lambert/31/README.md

# 31 Power Supply Unit

[Documentation](docs/README.md).

[Electrical CAD files](ecad/README.md)

[Mechanical CAD files](mcad/README.md)

CC BY-SA
