lambert/31/ecad/pcb/README.md

Requires [pcb version 4.2.1](https://sourceforge.net/projects/pcb/files/pcb/pcb-4.2.1/) or later.
