lambert/31/ecad/pcb/eyecandy/README.md

# pcb eyecandy

## 31.001.00.01.01 Front panel

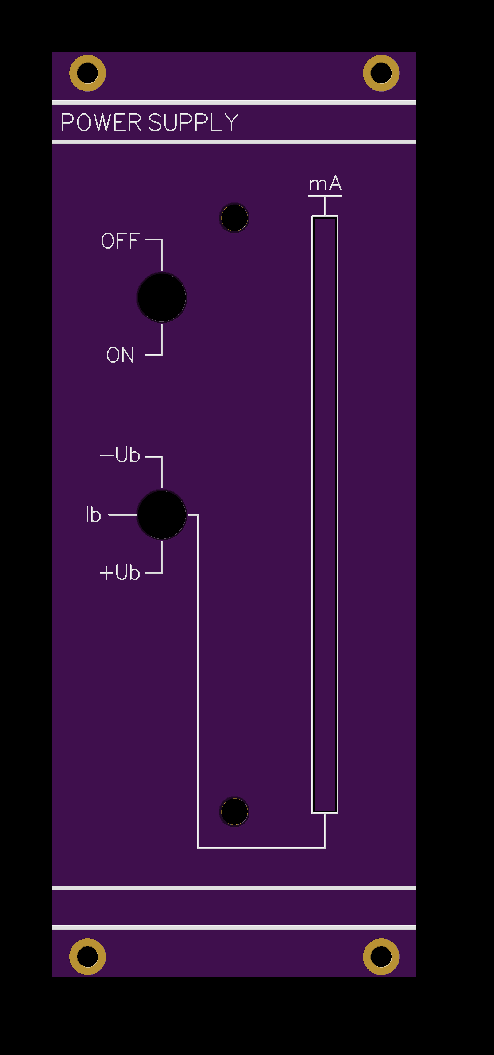
[picture p2: ecad/pcb/eyecandy/31.001.00.01.01.pcb.top.png]
top-001


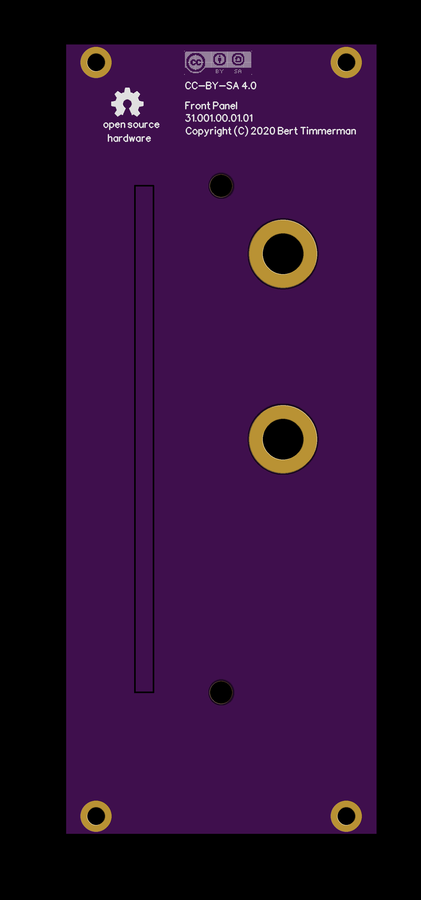
[picture p3: ecad/pcb/eyecandy/31.001.00.01.01.pcb.bottom.png]
bottom-001


## 31.002.00.01.01 Front pcb

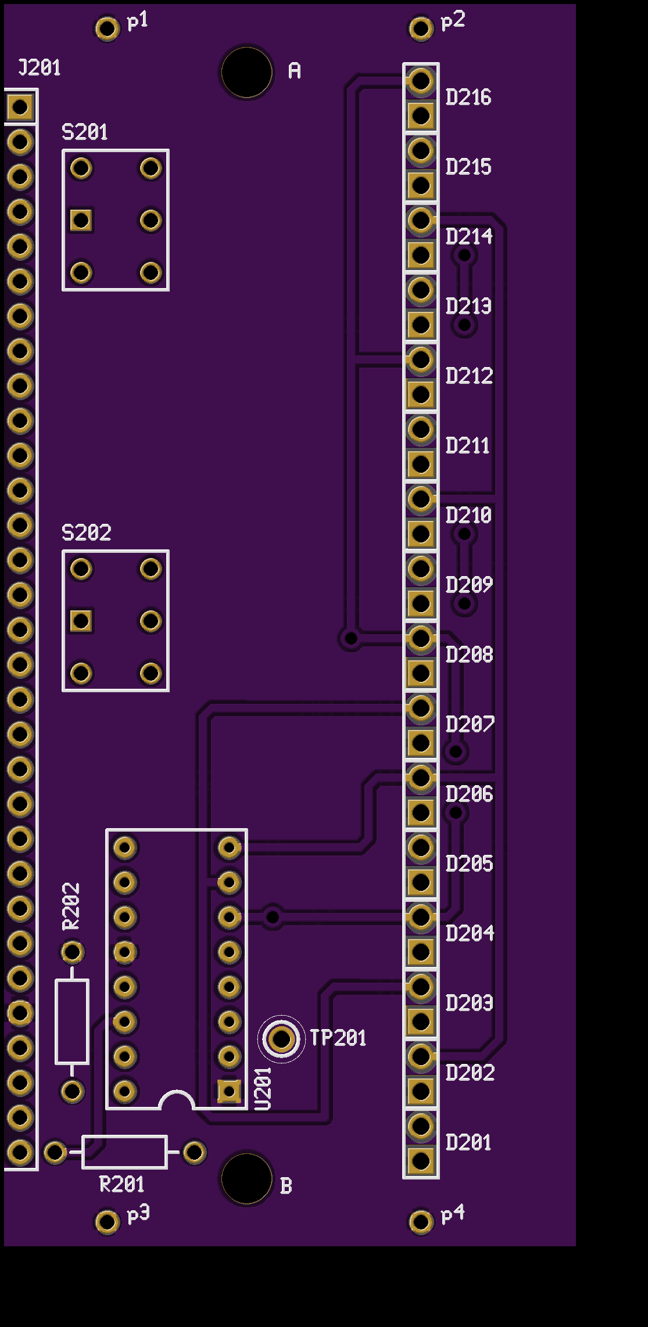
[picture p4: ecad/pcb/eyecandy/31.002.00.01.01.pcb.top.png]
top-002


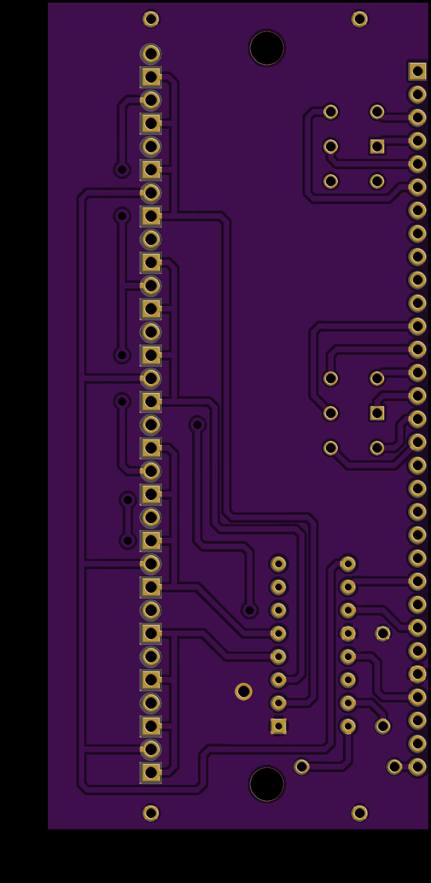
[picture p5: ecad/pcb/eyecandy/31.002.00.01.01.pcb.bottom.png]
bottom-002


## 31.003.00.01.01 Main pcb

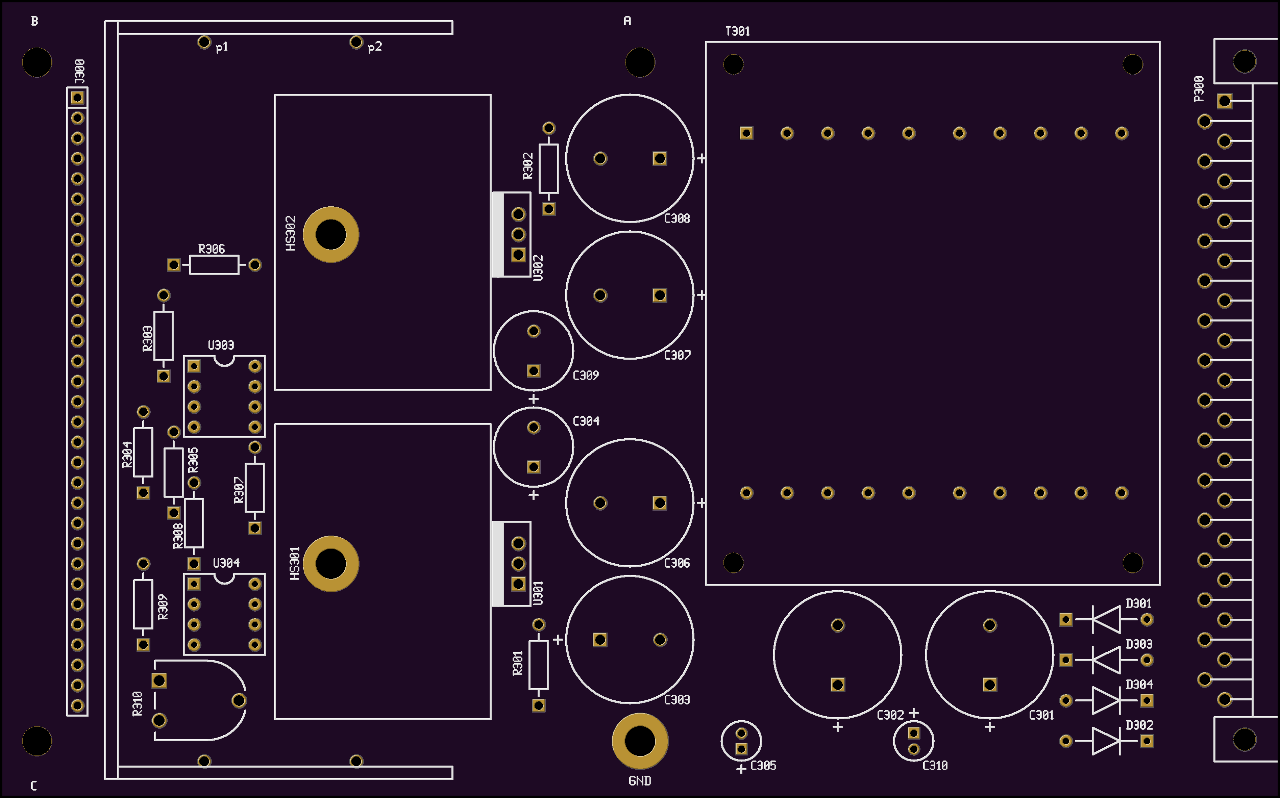
[picture p6: ecad/pcb/eyecandy/31.003.00.01.01.pcb.top.png]
top-003


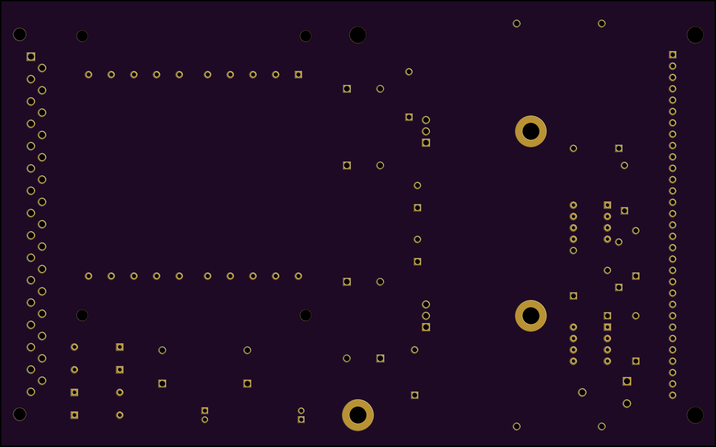
[picture p7: ecad/pcb/eyecandy/31.003.00.01.01.pcb.bottom.png]
bottom-003


## 31.004.00.01.01 Shielding pcb

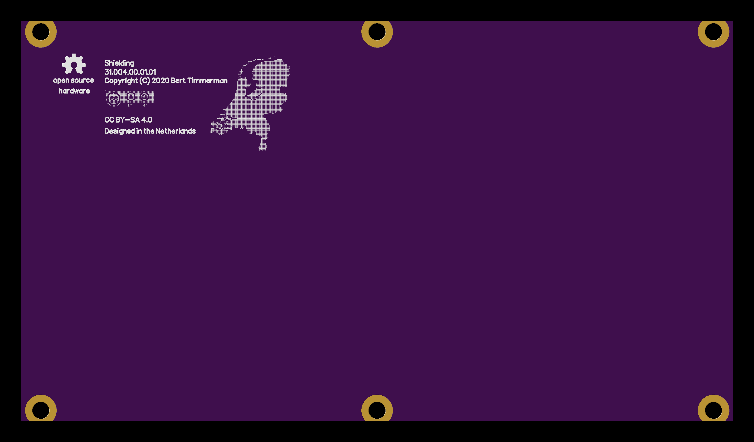
[picture p8: ecad/pcb/eyecandy/31.004.00.01.01.pcb.top.png]
top-004


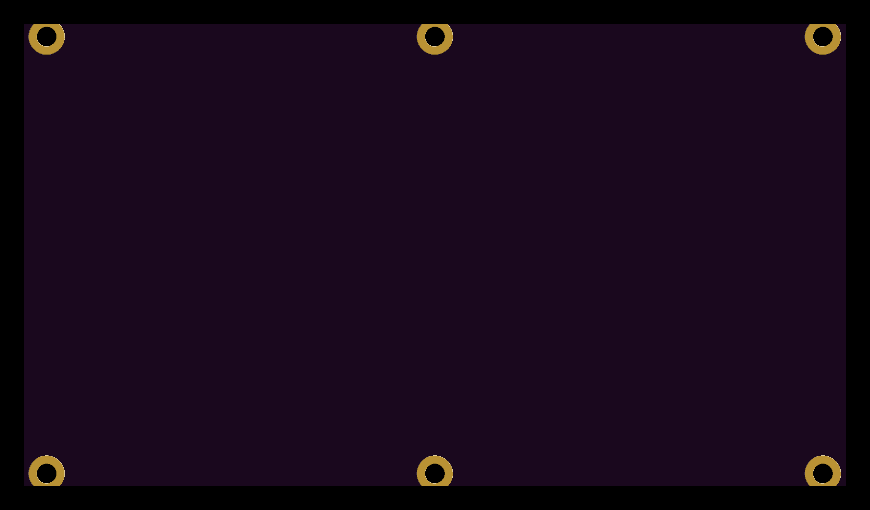
[picture p9: ecad/pcb/eyecandy/31.004.00.01.01.pcb.bottom.png]
bottom-004


## 31.005.00.01.01 Strut

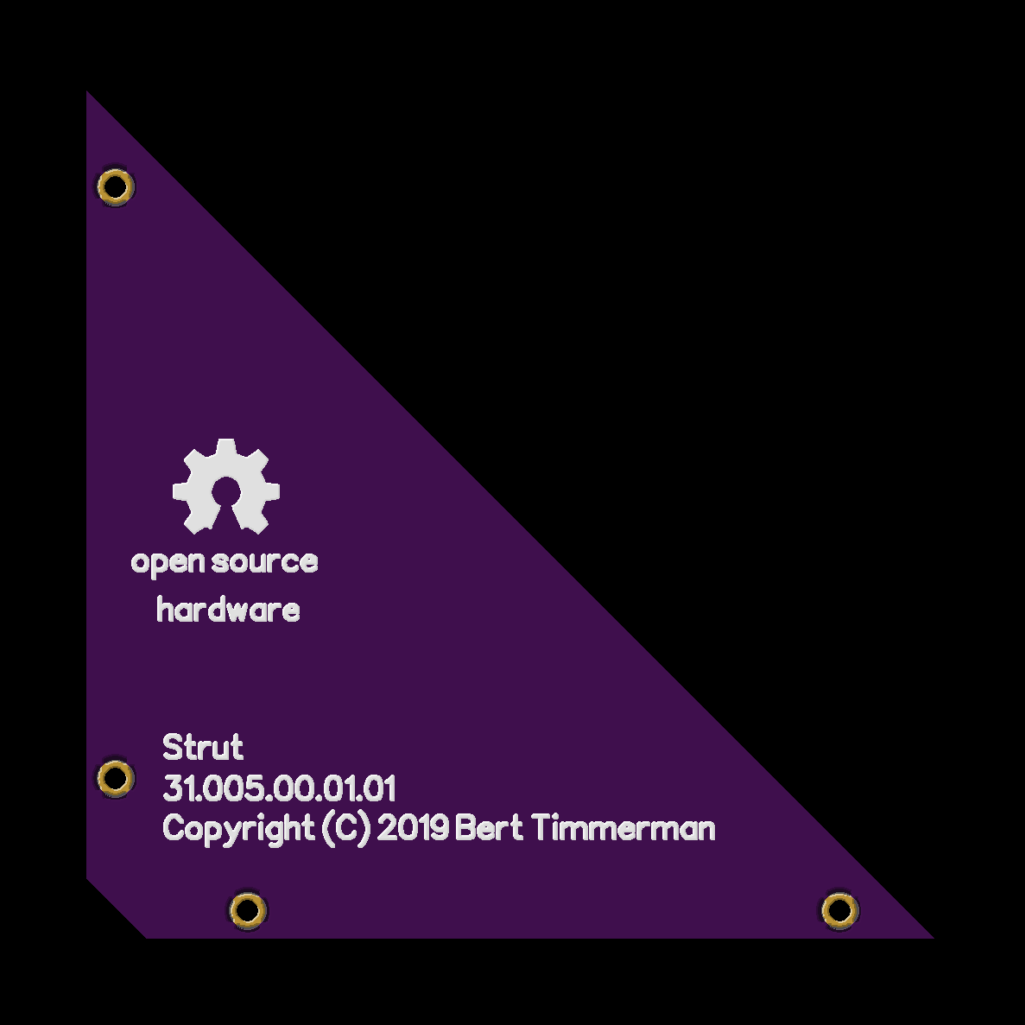
[picture p10: ecad/pcb/eyecandy/31.005.00.01.01.pcb.top.png]
top-005


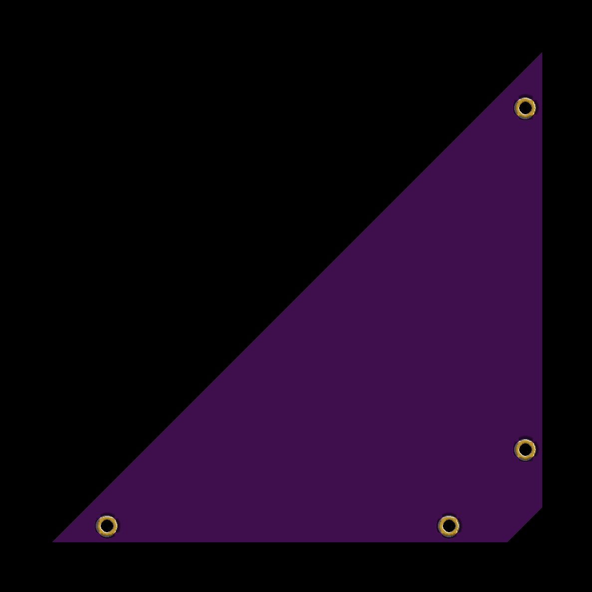
[picture p11: ecad/pcb/eyecandy/31.005.00.01.01.pcb.bottom.png]
bottom-005
