lambert/31/ecad/pcb/plotfiles/31.004.00.01.01.pcb.pdf

## 31.004.00.01.01.pcb

## 1. Table of Contents (This Page) Created on Sun Jan 3 12:16:32 2021 2. top 3. bottom 4. outline 5. plated-drill 6. componentmask 7. soldermask 8. topsilk 9. bottomsilk 10. topassembly 11. bottomassembly 12. fab

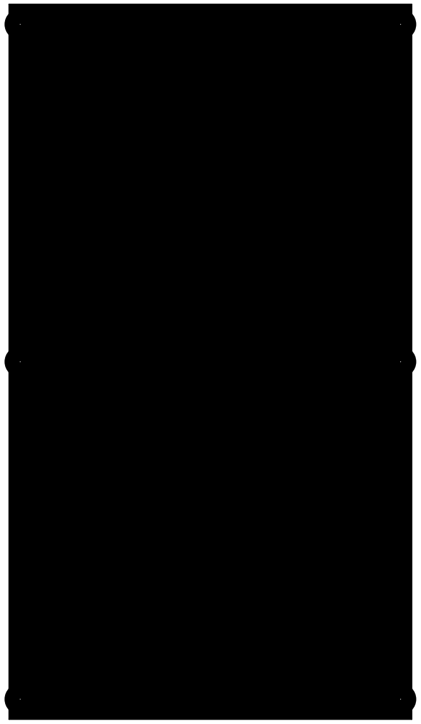
[picture p12: figure]

31.004.00.01.01.pcb, top, scale = 1:1.000

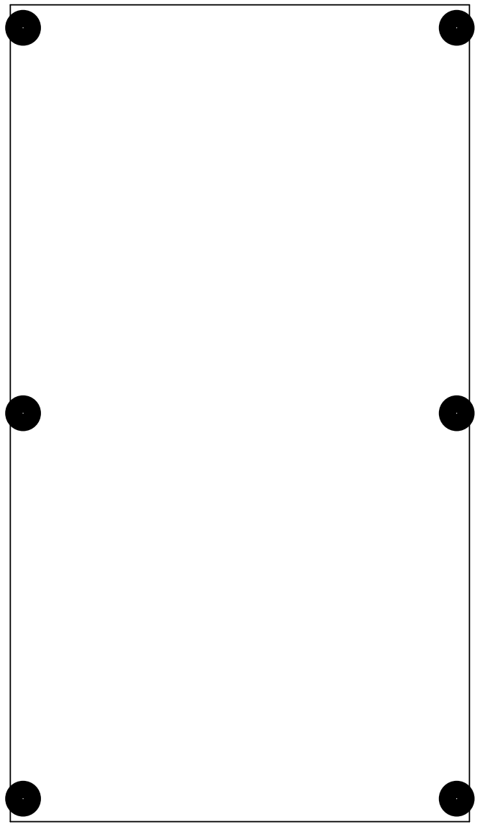
[picture p13: figure]

31.004.00.01.01.pcb, bottom (mirrored), scale = 1:1.000

31.004.00.01.01.pcb, outline, scale = 1:1.000

31.004.00.01.01.pcb, plated-drill, scale = 1:1.000

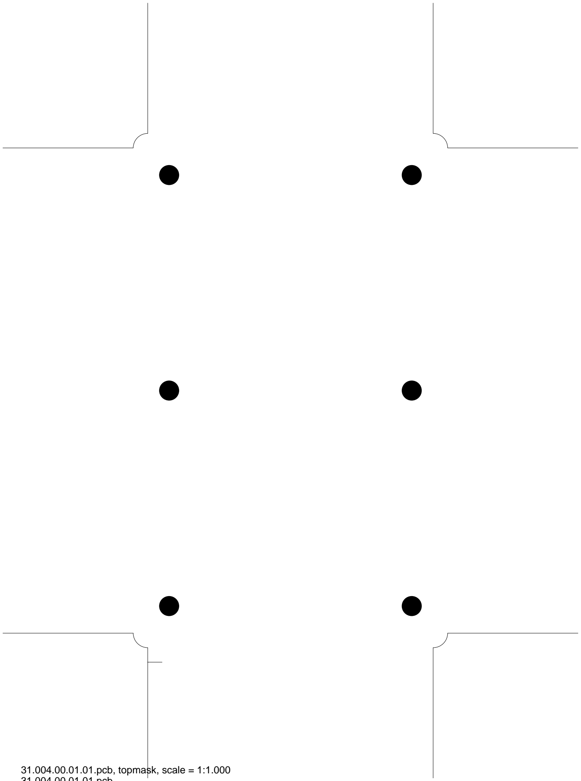
[picture p14: figure]
31.004.00.01.01.pcb, topmask, scale = 1:1.000

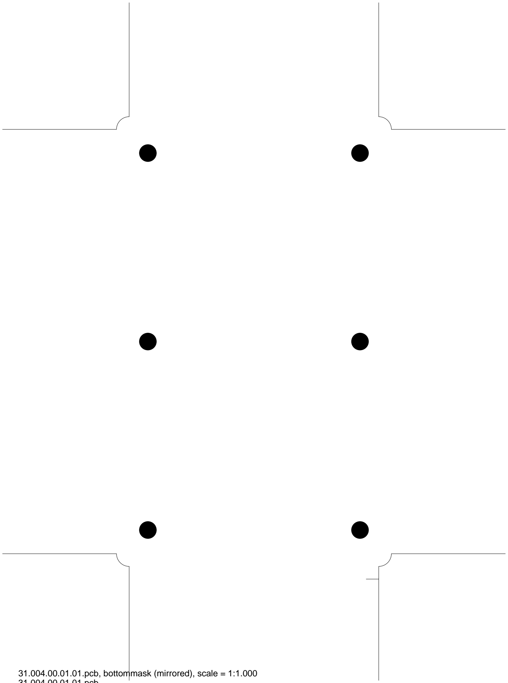
[picture p15: figure]

31.004.00.01.01.pcb, bottommask (mirrored), scale = 1:1.000

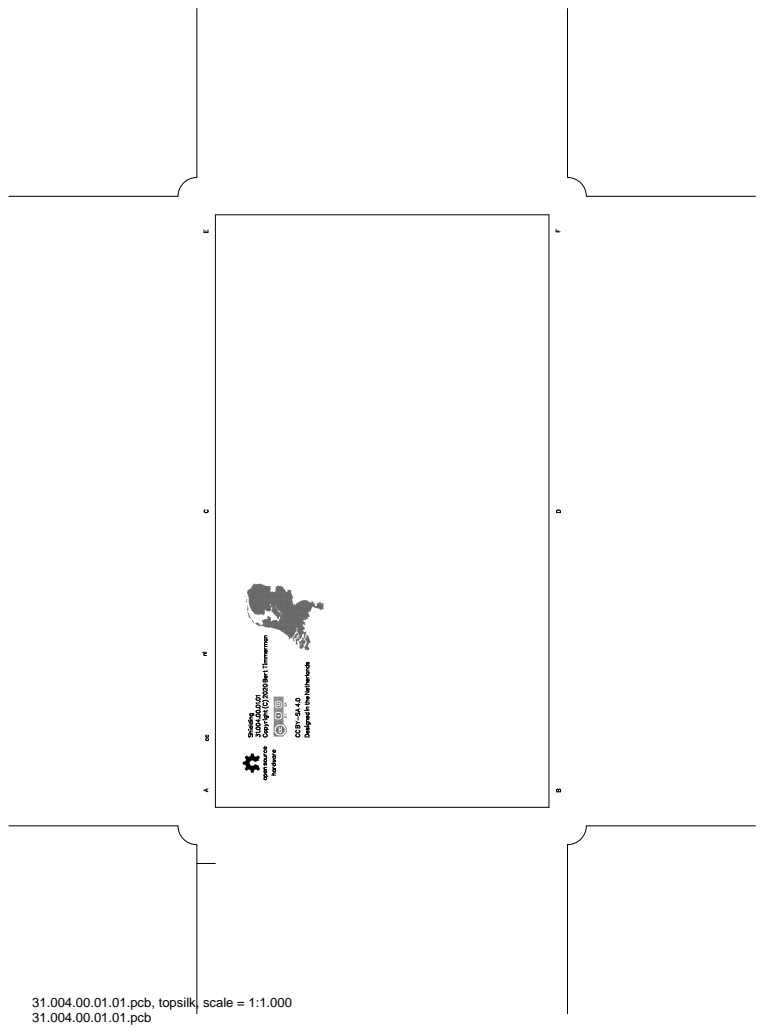
[picture p16: page 8]

31.004.00.01.01.pcb, topsilk, scale = 1:1.000

31.004.00.01.01.pcb, bottomsilk (mirrored), scale = 1:1.000

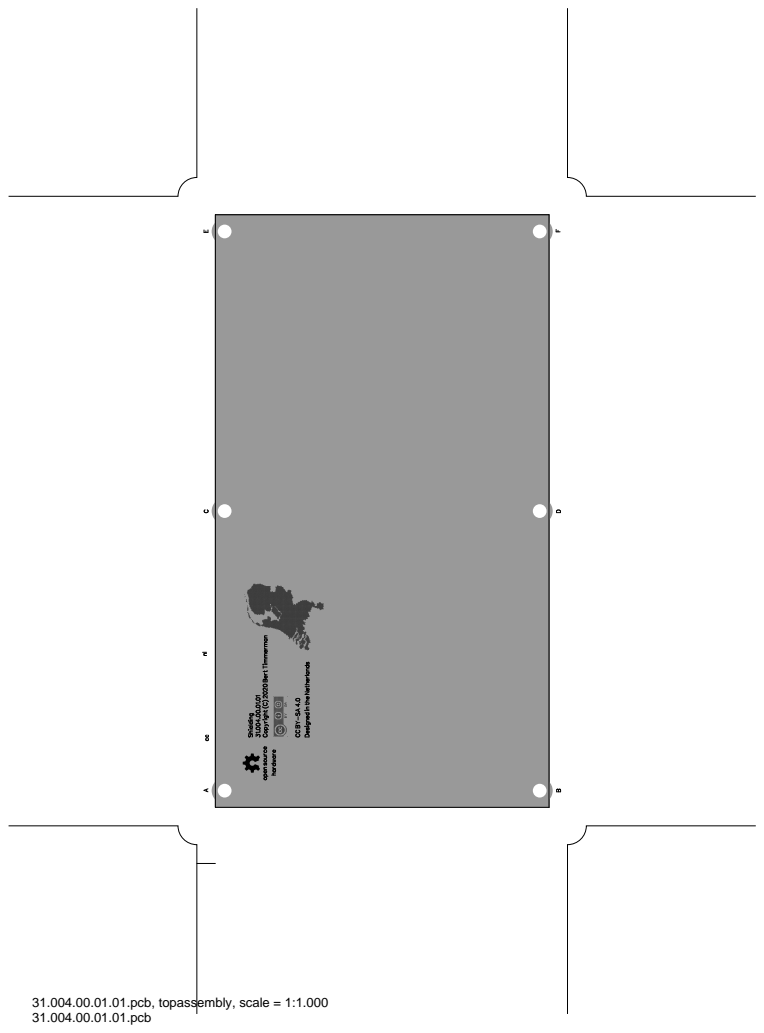
[picture p17: page 10]

31.004.00.01.01.pcb, topassembly, scale = 1:1.000

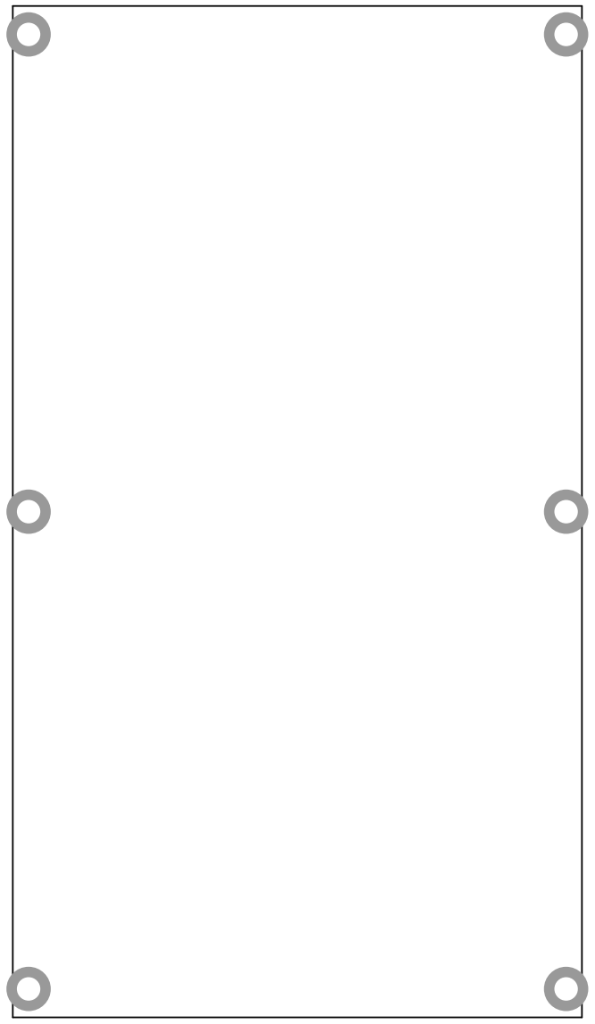
[picture p18: figure]

31.004.00.01.01.pcb, bottomassembly (mirrored), scale = 1:1.000

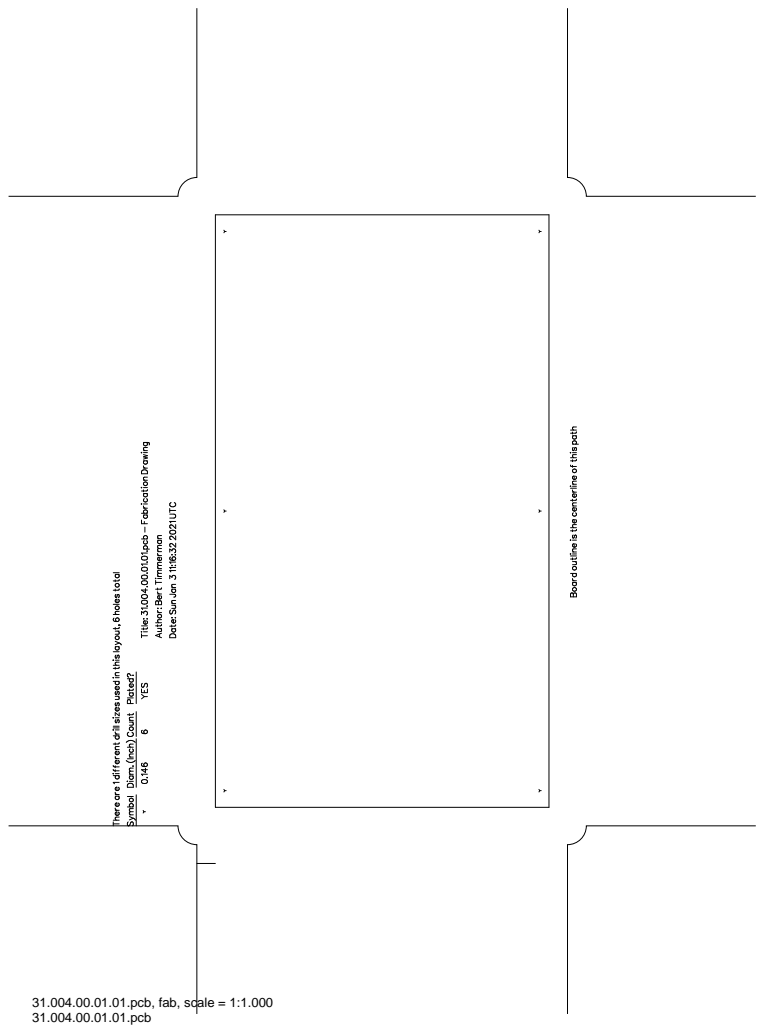
[picture p19: page 12]

31.004.00.01.01.pcb, fab, scale = 1:1.000
