lambert/31/docs/Era-UI39-13.5-18VA.jpg

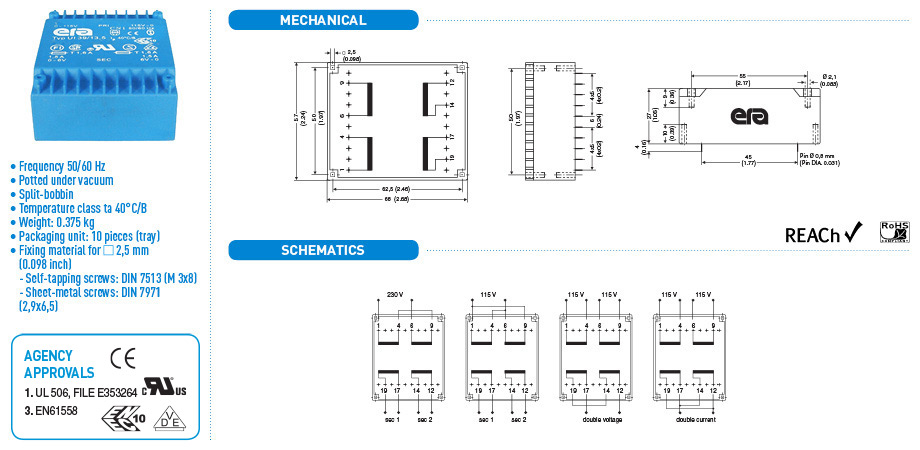
docs/Era-UI39-13.5-18VA.jpg
