lambert/31/mcad/parts/README.md

# Mechanical parts CAD files

All *.dwg files require Autodesk AutoCAD release 2015.
