lambert/31/docs/purchase/OSH_Park/README.md

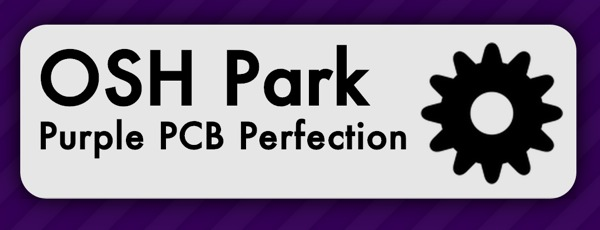
[picture p21: docs/purchase/OSH_Park/OSH_Park_logo.jpg]
OSH_Park_logo
.

----

[31.001.00 Front panel rev. 00](31-001-00/README.md)

[31.002.00 Front pcb rev. 00](31-002-00/README.md)

[31.003.00 Main pcb rev. 00](31-003-00/README.md)

[31.004.00 Shielding pcb rev. 00](31-004-00/README.md)

[31.005.00 Strut rev. 00](31-005-00/README.md)
