lambert/31/(list of files, cad)

Other CAD files:
mcad/parts/31_main_pcb_assembly_mechanical.dwg
mcad/parts/31_main_pcb_assembly.dwg
mcad/31.003.00.03.01_main_pcb_mechanical.dwg
mcad/parts/31_front_pcb_assembly.dwg
mcad/parts/31_assembly.dwg
mcad/parts/31_front_panel_assembly.dwg
mcad/31.001.00.01.01_front_panel_assembly.dwg
mcad/parts/31_main_pcb.dwg
mcad/31.003.00.02.01_main_pcb_fabrication_notes.dwg
mcad/31.003.00.02.02_main_pcb_drill_info.dwg
mcad/31.003.00.01.02_main_pcb_assembly_mechanical.dwg
mcad/31.000.00.01.06_assembly_left_view.dwg
mcad/31.000.00.01.07_assembly_right_view.dwg
mcad/31.002.00.01.01_front_pcb_assembly.dwg
mcad/31.003.00.01.01_main_pcb_assembly.dwg
mcad/31.000.00.01.02_assembly_top_view.dwg
mcad/31.000.00.01.00_assembly_SW_ISO_view.dwg
mcad/31.000.00.01.03_assembly_bottom_view.dwg
mcad/31.000.00.01.04_assembly_front_view.dwg
mcad/31.000.00.01.05_assembly_back_view.dwg
mcad/31.000.00.01.01_assembly_ISO_views.dwg
mcad/31.001.00.03.01_front_panel_mechanical.dwg
mcad/31.002.00.02.02_front_pcb_drill_info.dwg
mcad/31.004.00.03.01_shielding_pcb_mechanical.dwg
mcad/31.005.00.03.01_side_panel_mechanical.dwg
mcad/parts/31_front_panel_layout.dwg
mcad/31.006.00.03.01_heatsink_mechanical.dwg
mcad/parts/31_side_panel.dwg
mcad/31.002.00.02.01_front_pcb_fabrication_notes.dwg
mcad/parts/31_front_panel.dwg
mcad/parts/31_shielding_pcb.dwg
mcad/31.001.00.02.02_front_panel_fabrication_notes.dwg
mcad/parts/31_HSINK_Conrad_188751-02_88x35x37_modified.dwg
mcad/parts/31_front_pcb.dwg
mcad/31.001.00.02.03_front_panel_drill_info.dwg
mcad/31.002.00.03.01_front_pcb_mechanical.dwg
mcad/31.001.00.02.01_front_panel_layout.dwg
