lambert/31/mcad/plotfiles/31.001.00.02.02_front_panel_fabrication_notes.pdf

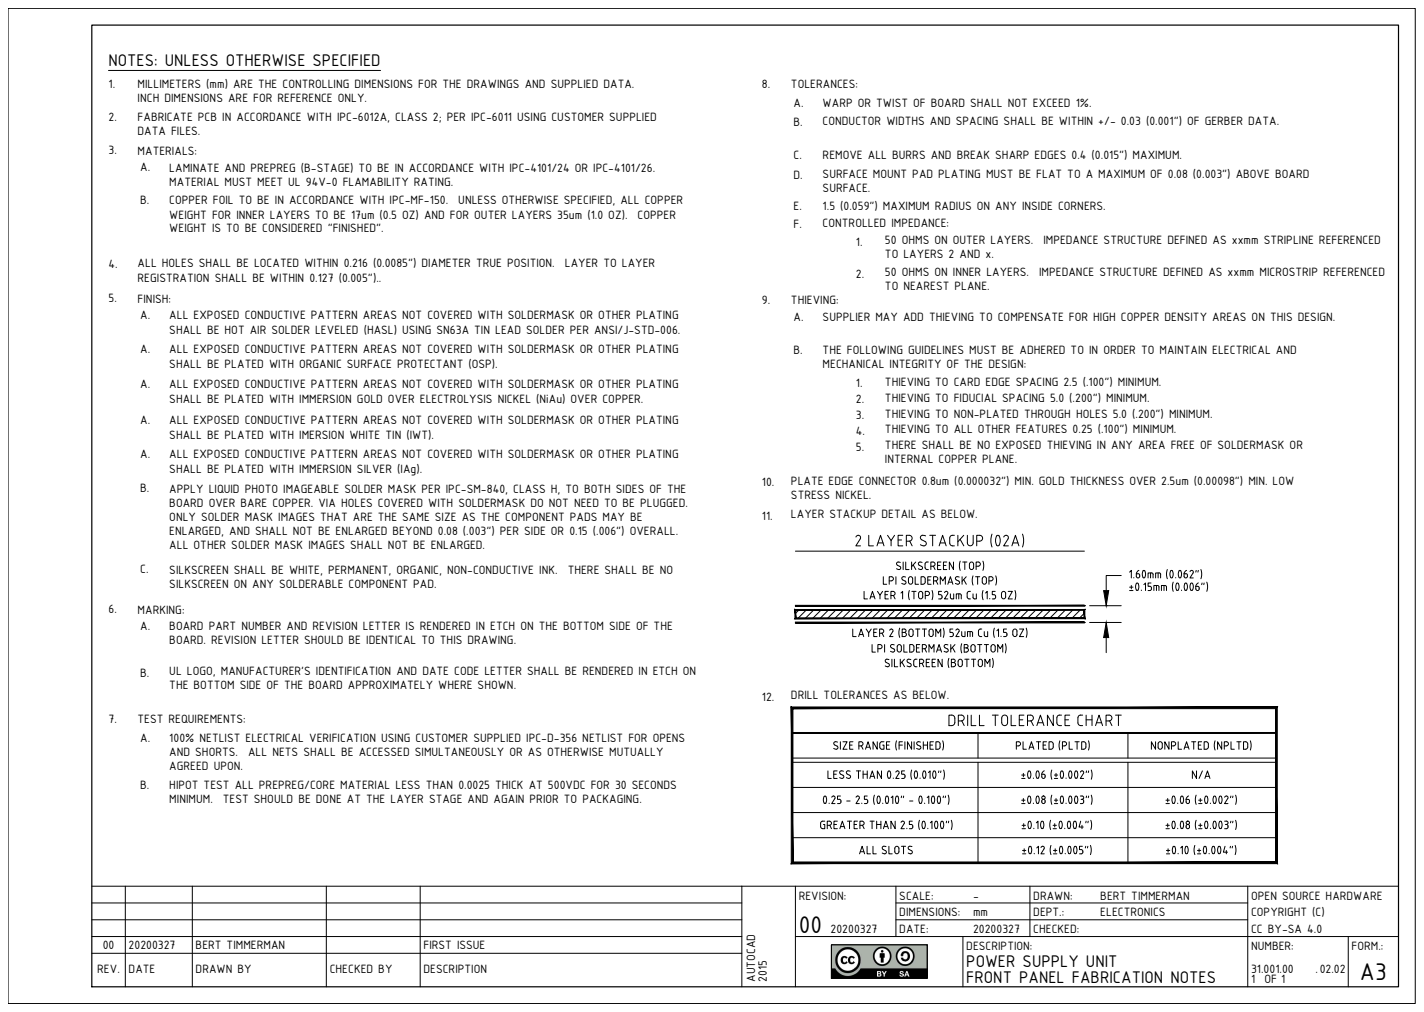
[picture p22: page 1]

NOTES: UNLESS OTHERWISE SPECIFIED

MILLIMETERS (mm) ARE THE CONTROLLING DIMENSIONS FOR THE DRAWINGS AND SUPPLIED DATA.
INCH DIMENSIONS ARE FOR REFERENCE ONLY.
FABRICATE PCB IN ACCORDANCE WITH IPC-6012A, CLASS 2; PER IPC-6011 USING CUSTOMER SUPPLIED
DATA FILES.
MATERIALS:
LAMINATE AND PREPREG (B-STAGE) TO BE IN ACCORDANCE WITH IPC-4101/24 OR IPC-4101/26.
MATERIAL MUST MEET UL 94V-0 FLAMABILITY RATING.
COPPER FOIL TO BE IN ACCORDANCE WITH IPC-MF-150. UNLESS OTHERWISE SPECIFIED, ALL COPPER
WEIGHT FOR INNER LAYERS TO BE 17um (0.5 OZ) AND FOR OUTER LAYERS 35um (1.0 OZ). COPPER
WEIGHT IS TO BE CONSIDERED "FINISHED".

8. TOLERANCES:
WARP OR TWIST OF BOARD SHALL NOT EXCEED 1%.
CONDUCTOR WIDTHS AND SPACING SHALL BE WITHIN +/- 0.03 (0.001") OF GERBER DATA.

REMOVE ALL BURRS AND BREAK SHARP EDGES 0.4 (0.015") MAXIMUM.
SURFACE MOUNT PAD PLATING MUST BE FLAT TO A MAXIMUM OF 0.08 (0.003") ABOVE BOARD
SURFACE.
1.5 (0.059") MAXIMUM RADIUS ON ANY INSIDE CORNERS.
CONTROLLED IMPEDANCE:

50 OHMS ON OUTER LAYERS. IMPEDANCE STRUCTURE DEFINED AS xxmm STRIPLINE REFERENCED
TO LAYERS 2 AND x.
50 OHMS ON INNER LAYERS. IMPEDANCE STRUCTURE DEFINED AS xxmm MICROSTRIP REFERENCED
TO NEAREST PLANE.

ALL HOLES SHALL BE LOCATED WITHIN 0.216 (0.0085") DIAMETER TRUE POSITION. LAYER TO LAYER
REGISTRATION SHALL BE WITHIN 0.127 (0.005")..
5. FINISH:
ALL EXPOSED CONDUCTIVE PATTERN AREAS NOT COVERED WITH SOLDERMASK OR OTHER PLATING
SHALL BE HOT AIR SOLDER LEVELED (HASL) USING SN63A TIN LEAD SOLDER PER ANSI/J-STD-006.
SHALL BE PLATED WITH ORGANIC SURFACE PROTECTANT (OSP).
SHALL BE PLATED WITH IMMERSION GOLD OVER ELECTROLYSIS NICKEL (NiAu) OVER COPPER.

9. THIEVING:
SUPPLIER MAY ADD THIEVING TO COMPENSATE FOR HIGH COPPER DENSITY AREAS ON THIS DESIGN.

THE FOLLOWING GUIDELINES MUST BE ADHERED TO IN ORDER TO MAINTAIN ELECTRICAL AND
MECHANICAL INTEGRITY OF THE DESIGN:

THIEVING TO CARD EDGE SPACING 2.5 (.100") MINIMUM.
THIEVING TO FIDUCIAL SPACING 5.0 (.200") MINIMUM.
THIEVING TO NON-PLATED THROUGH HOLES 5.0 (.200") MINIMUM.
THIEVING TO ALL OTHER FEATURES 0.25 (.100") MINIMUM.
THERE SHALL BE NO EXPOSED THIEVING IN ANY AREA FREE OF SOLDERMASK OR
INTERNAL COPPER PLANE.

SHALL BE PLATED WITH IMERSION WHITE TIN (IWT).
SHALL BE PLATED WITH IMMERSION SILVER (IAg).
APPLY LIQUID PHOTO IMAGEABLE SOLDER MASK PER IPC-SM-840, CLASS H, TO BOTH SIDES OF THE
BOARD OVER BARE COPPER. VIA HOLES COVERED WITH SOLDERMASK DO NOT NEED TO BE PLUGGED.
ONLY SOLDER MASK IMAGES THAT ARE THE SAME SIZE AS THE COMPONENT PADS MAY BE
ENLARGED, AND SHALL NOT BE ENLARGED BEYOND 0.08 (.003") PER SIDE OR 0.15 (.006") OVERALL.
ALL OTHER SOLDER MASK IMAGES SHALL NOT BE ENLARGED.

PLATE EDGE CONNECTOR 0.8um (0.000032") MIN. GOLD THICKNESS OVER 2.5um (0.00098") MIN. LOW
STRESS NICKEL.
11. LAYER STACKUP DETAIL AS BELOW.

SILKSCREEN SHALL BE WHITE, PERMANENT, ORGANIC, NON-CONDUCTIVE INK. THERE SHALL BE NO
SILKSCREEN ON ANY SOLDERABLE COMPONENT PAD.

MARKING:
BOARD PART NUMBER AND REVISION LETTER IS RENDERED IN ETCH ON THE BOTTOM SIDE OF THE
BOARD. REVISION LETTER SHOULD BE IDENTICAL TO THIS DRAWING.

UL LOGO, MANUFACTURER'S IDENTIFICATION AND DATE CODE LETTER SHALL BE RENDERED IN ETCH ON
THE BOTTOM SIDE OF THE BOARD APPROXIMATELY WHERE SHOWN.

12. DRILL TOLERANCES AS BELOW.

TEST REQUIREMENTS:
100% NETLIST ELECTRICAL VERIFICATION USING CUSTOMER SUPPLIED IPC-D-356 NETLIST FOR OPENS
AND SHORTS. ALL NETS SHALL BE ACCESSED SIMULTANEOUSLY OR AS OTHERWISE MUTUALLY
AGREED UPON.
HIPOT TEST ALL PREPREG/CORE MATERIAL LESS THAN 0.0025 THICK AT 500VDC FOR 30 SECONDS
MINIMUM. TEST SHOULD BE DONE AT THE LAYER STAGE AND AGAIN PRIOR TO PACKAGING.

REVISION: 00 20200327 | SCALE: -mm | DRAWN: BERT TIMMERMAN | OPEN SOURCE HARDWARE COPYRIGHT (C)

DIMENSIONS: | DEPT.: ELECTRONICS
DATE: 20200327 | CHECKED:

00 | 20200327 | BERT TIMMERMAN | | FIRST ISSUE | | DESCRIPTION: POWER SUPPLY UNIT FRONT PANEL FABRICATION NOTES | CC BY-SA 4.0 AUTOCAD 2015 NUMBER: 31.001.00 . OF 02.02 1 1 | FORM.: A3

REV. | DATE | DRAWN BY | CHECKED BY | DESCRIPTION
