lambert/31/docs/31_POWER_SUPPLY_UNIT-schematics.pdf

| PSU Power Supply Unit TITLE Front Page
31.000.00.00.01.sch FILE: 01 01 PAGE OF | 20240622 REVISION: Bert Timmerman DRAWN BY: | A3

This hardware is released under Creative Commons Share-alike 4.0 International (http://creativecommons.org/licenses/by-sa/4.0/).

Note: This is a human-readable summary of (and not a substitute for) the license (http://creativecommons.org/licenses/by-sa/4.0/legalcode).

You are free to:

Share — copy and redistribute the material in any medium or format

Adapt — remix, transform, and build upon the material
for any purpose, even commercially.

The licensor cannot revoke these freedoms as long as you follow the license terms.

Under the following terms:

Attribution — You must give appropriate credit, provide a link to the license, and indicate if changes were made. You may do so in any reasonable manner, but not in any way that suggests the licensor endorses you or your use.

ShareAlike — If you remix, transform, or build upon the material, you must distribute your contributions under the same license as the original.

No additional restrictions — You may not apply legal terms or technological measures that legally restrict others from doing anything the license permits.

Notices:

You do not have to comply with the license for elements of the material in the public domain or where your use is permitted by an applicable exception or limitation.

No warranties are given. The license may not give you all of the permissions necessary for your intended use. For example, other rights such as publicity, privacy, or moral rights may limit how you use the material.

DOC.NR. | | DESCRIPTION STATUS
31.000.00.01.01 | FINAL | Overall - Block diagram
31.000.00.01.02 | FINAL | Overall - Schematic
31.001.00.01.01 | FINAL | Front panel (DFM) - Schematic
31.002.00.01.01 | FINAL | Front PCB (DFM) - Schematic
31.003.00.01.01 | FINAL | Front PCB (DFM) - Schematic
31.004.00.01.01 | FINAL | Shielding PCB (DFM) - Schematic
31.005.00.01.01 | FINAL | Strut PCB (DFM) - Schematic

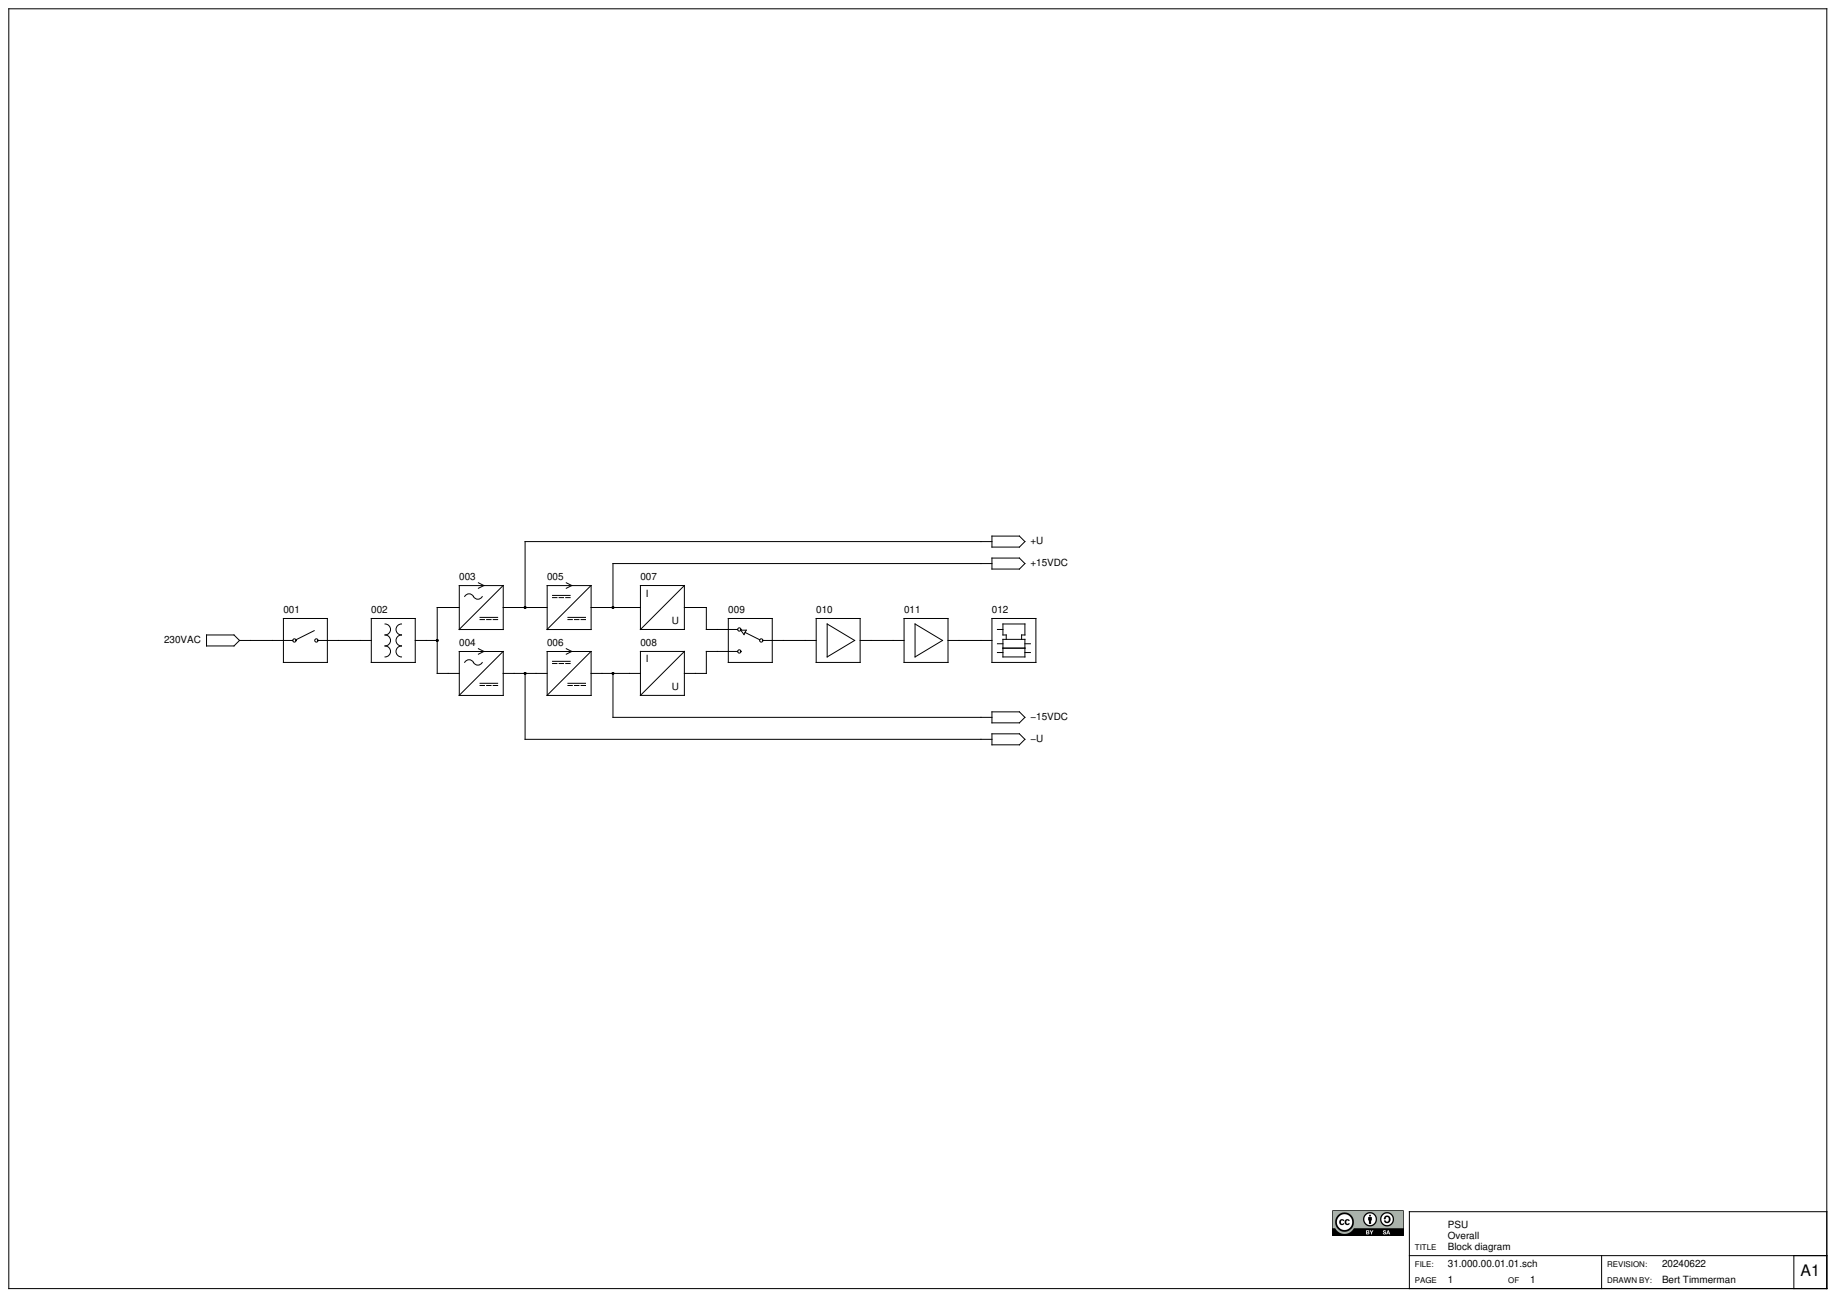
[picture p23: page 2]
A1 31.000.00.01.01.sch 1; 20240622 Bert Timmerman; Block diagram

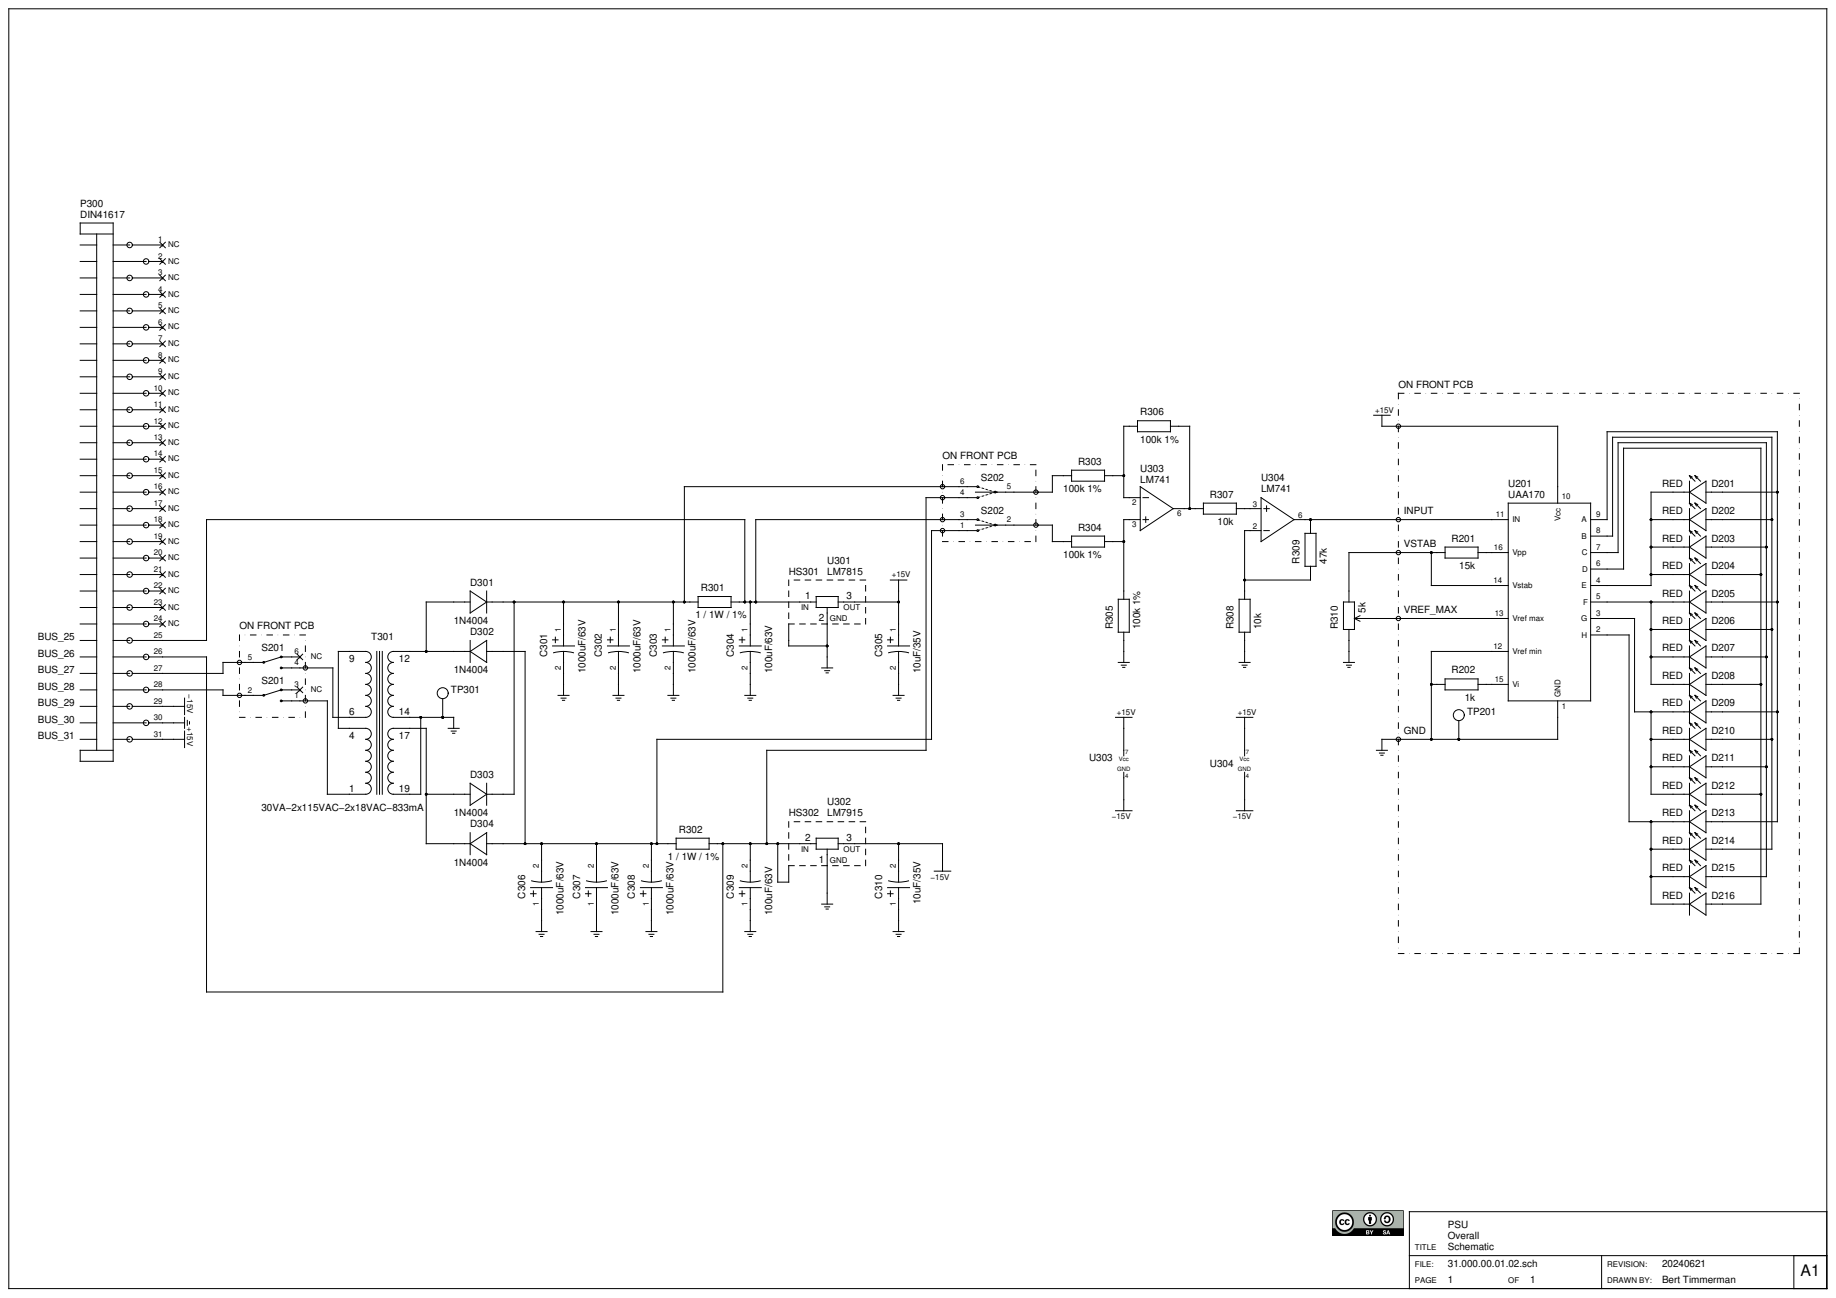
[picture p24: page 3]

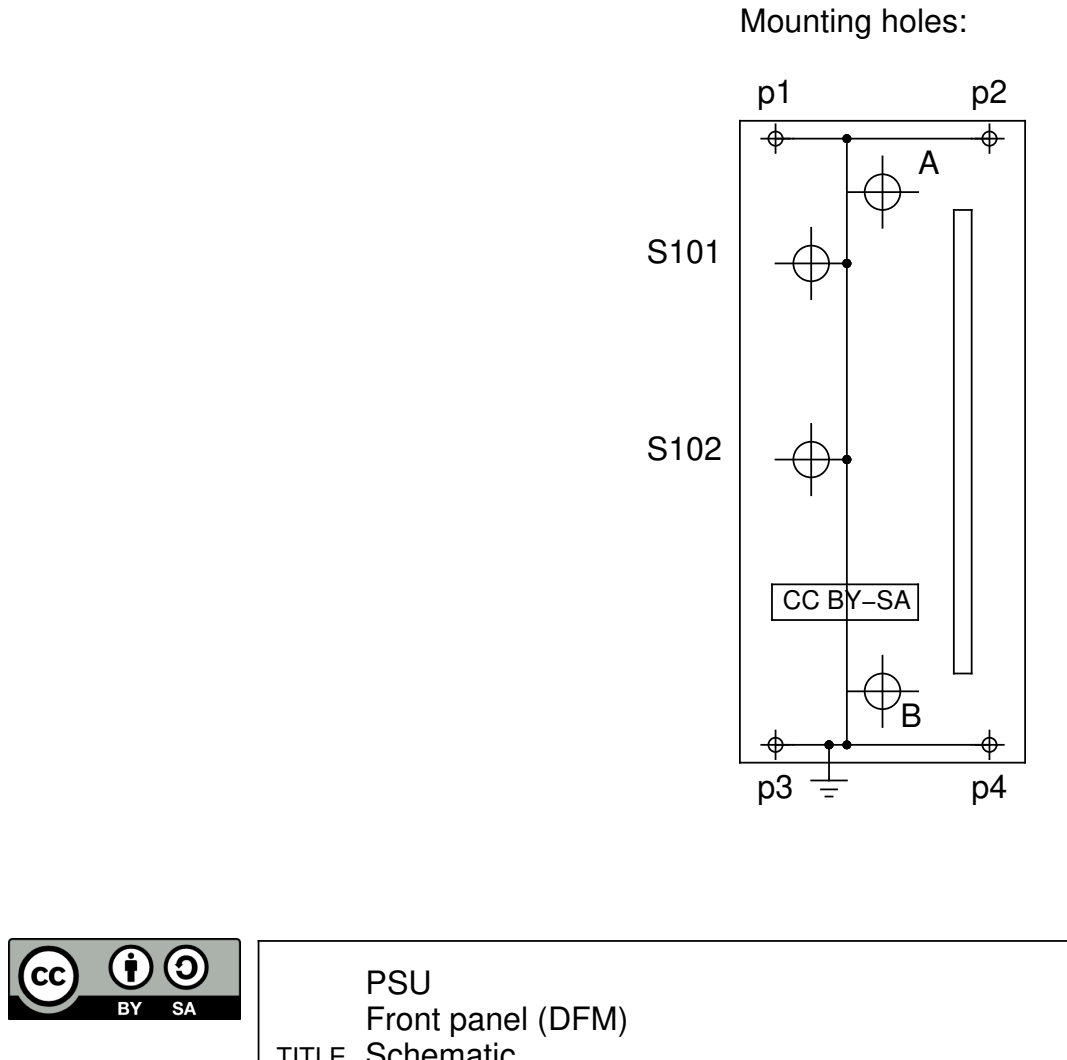
[picture p25: page 4]
Front panel (DFM); Mounting holes:

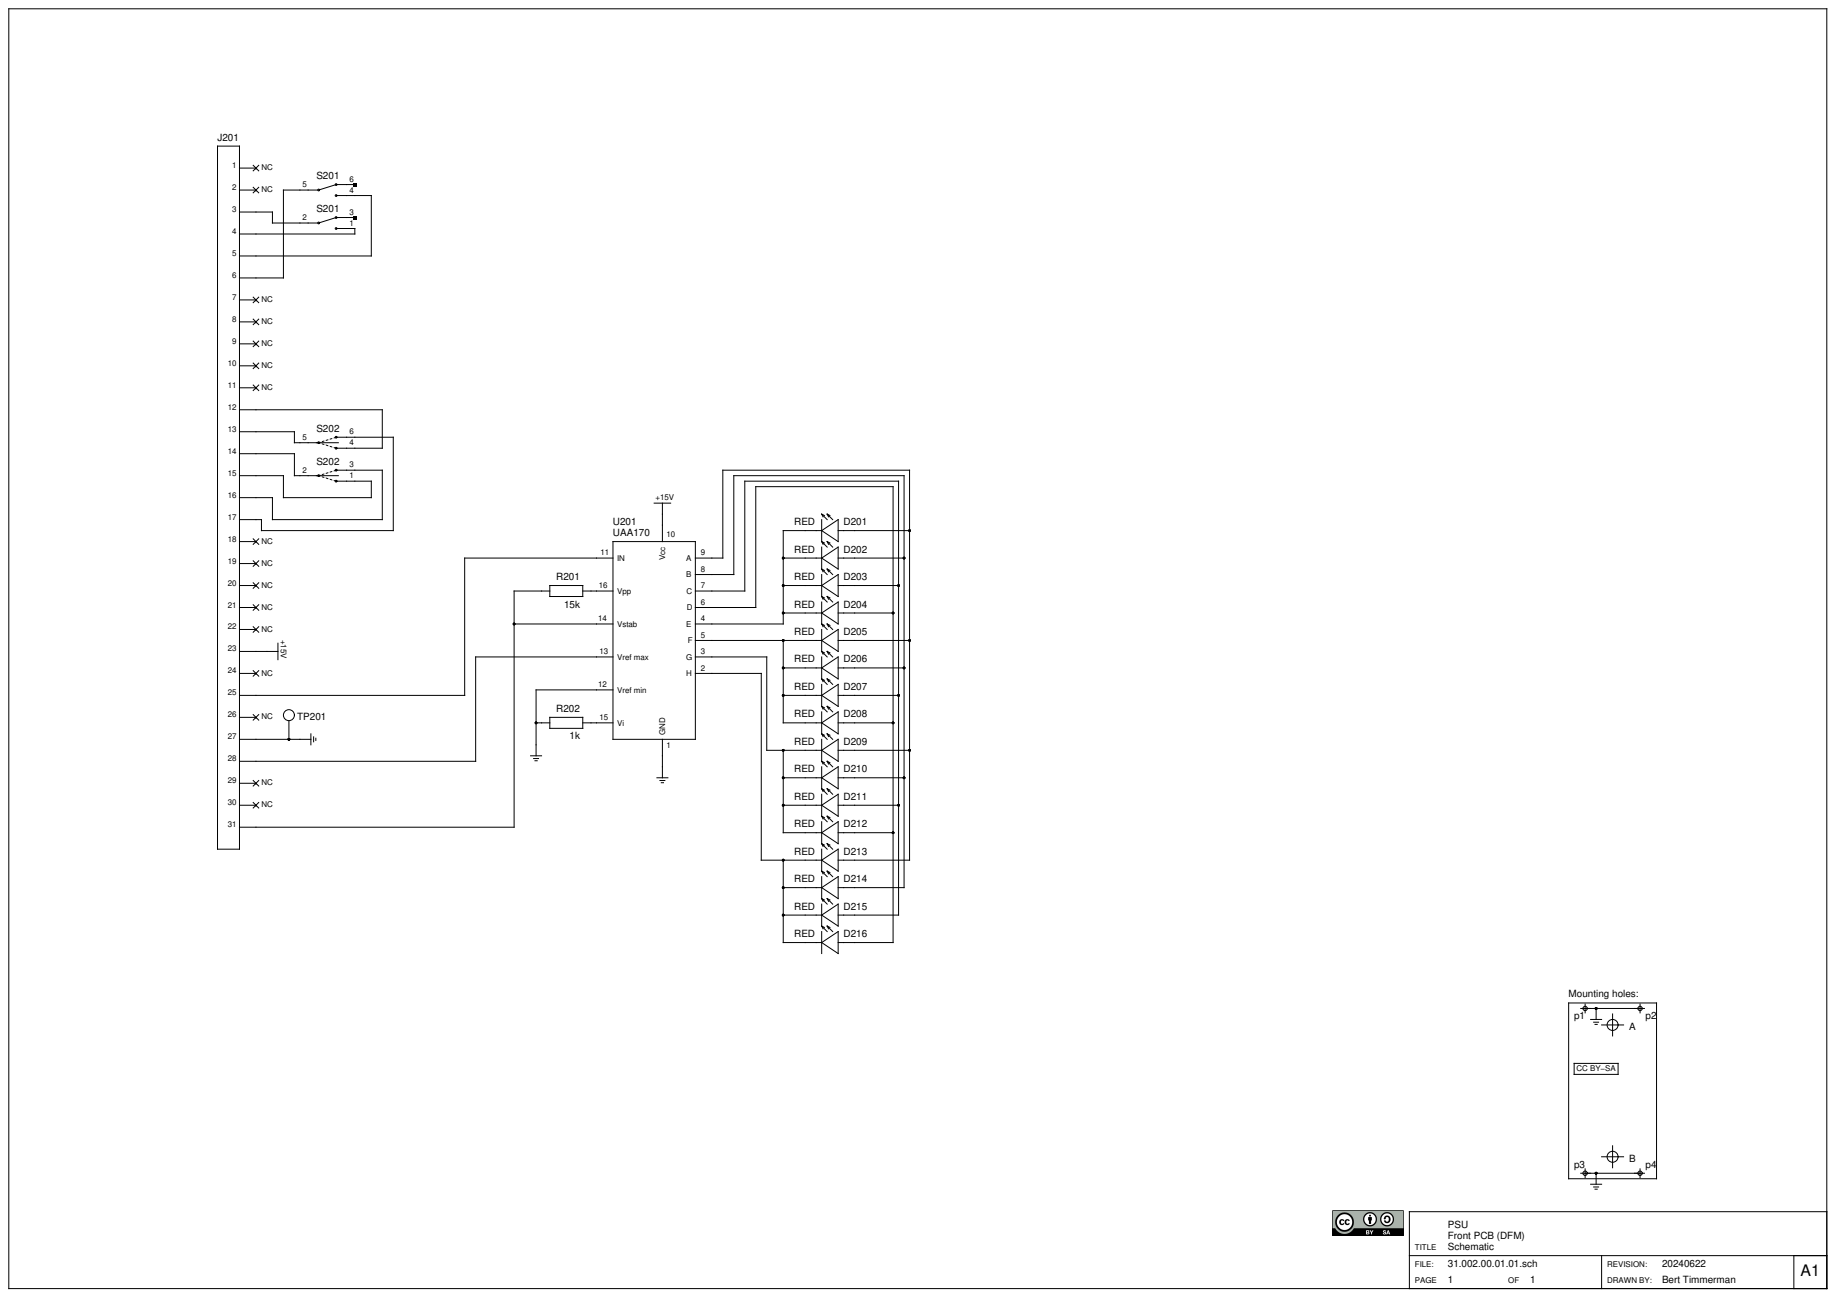
[picture p26: page 5]

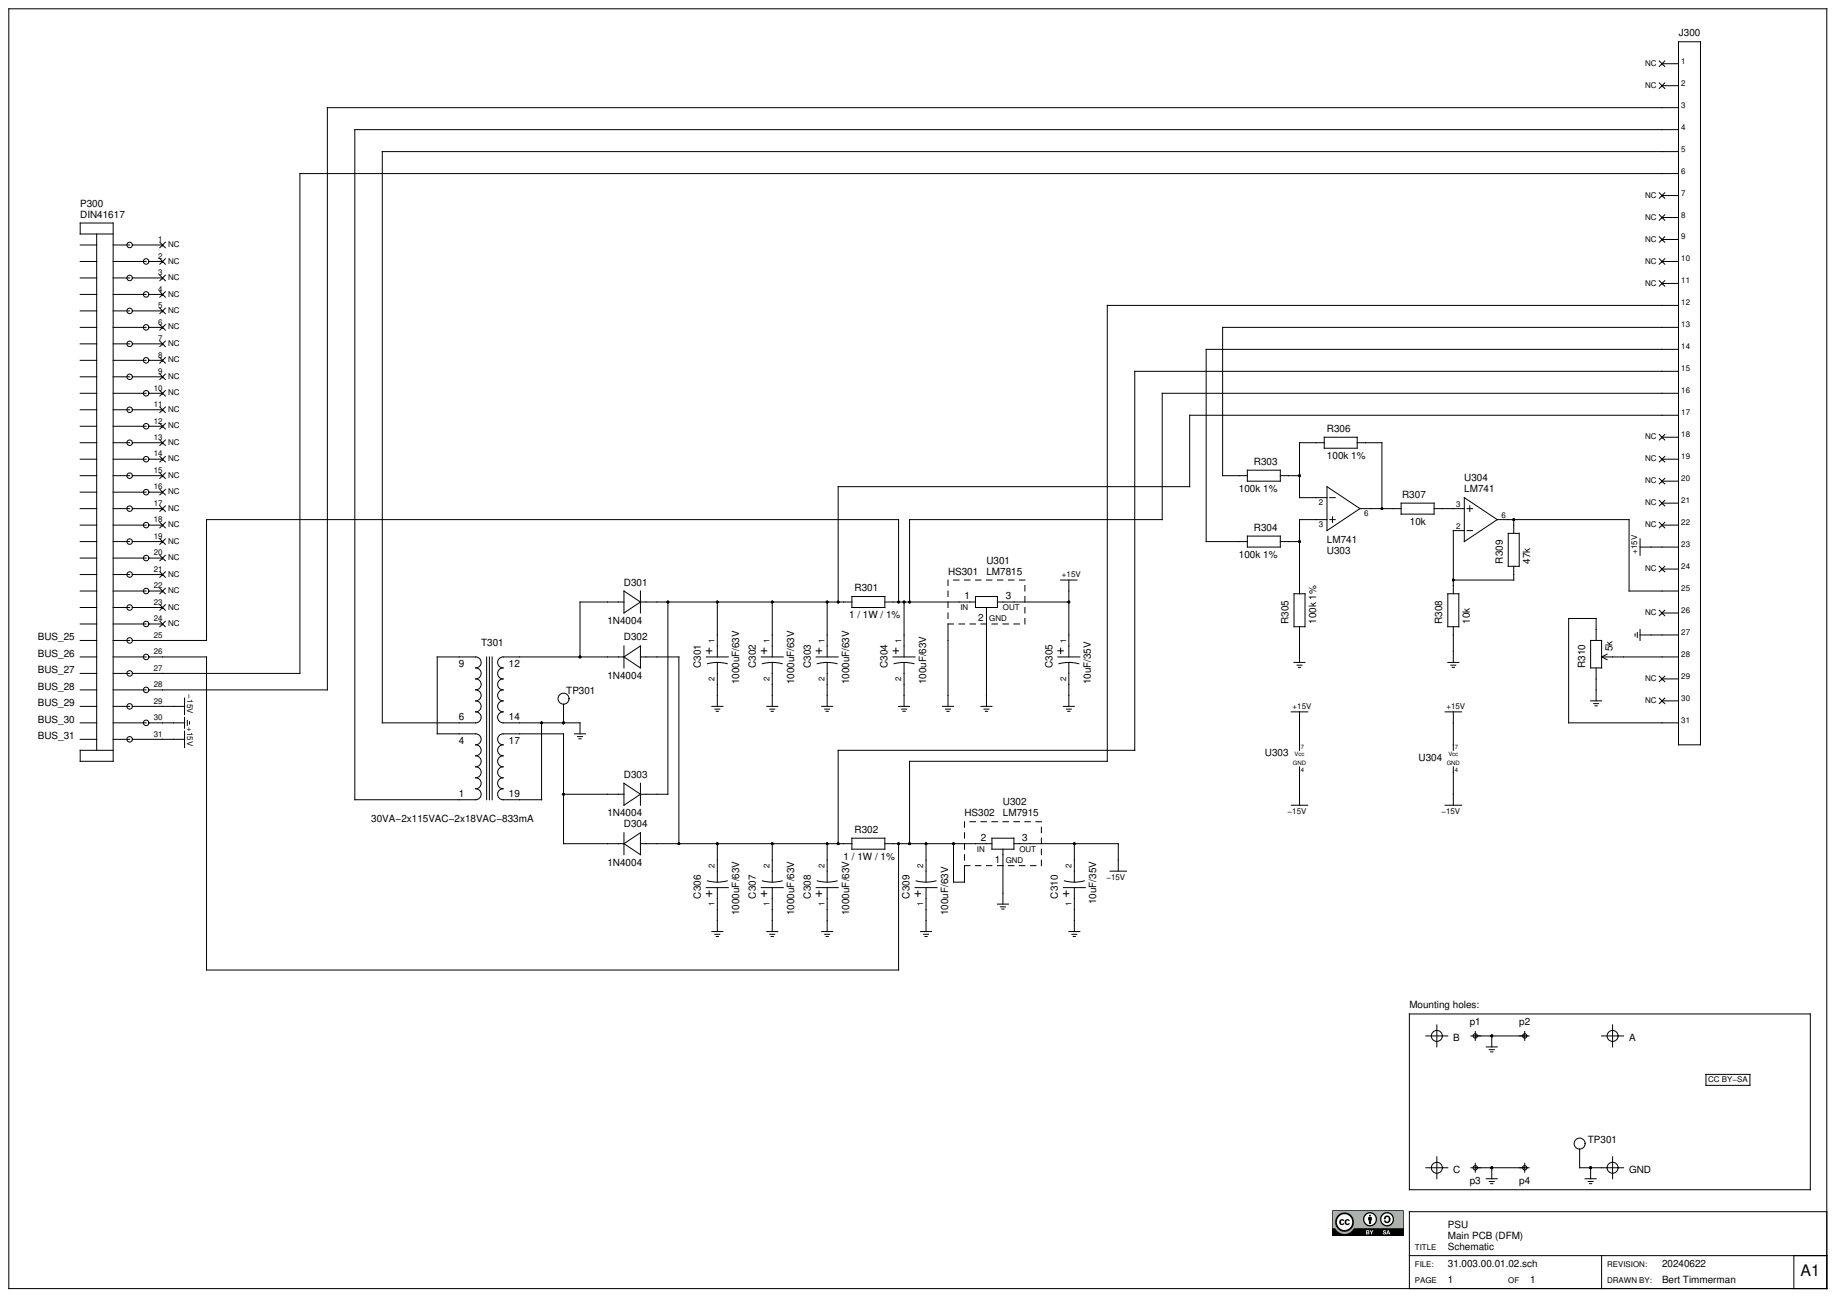
[picture p27: page 6]

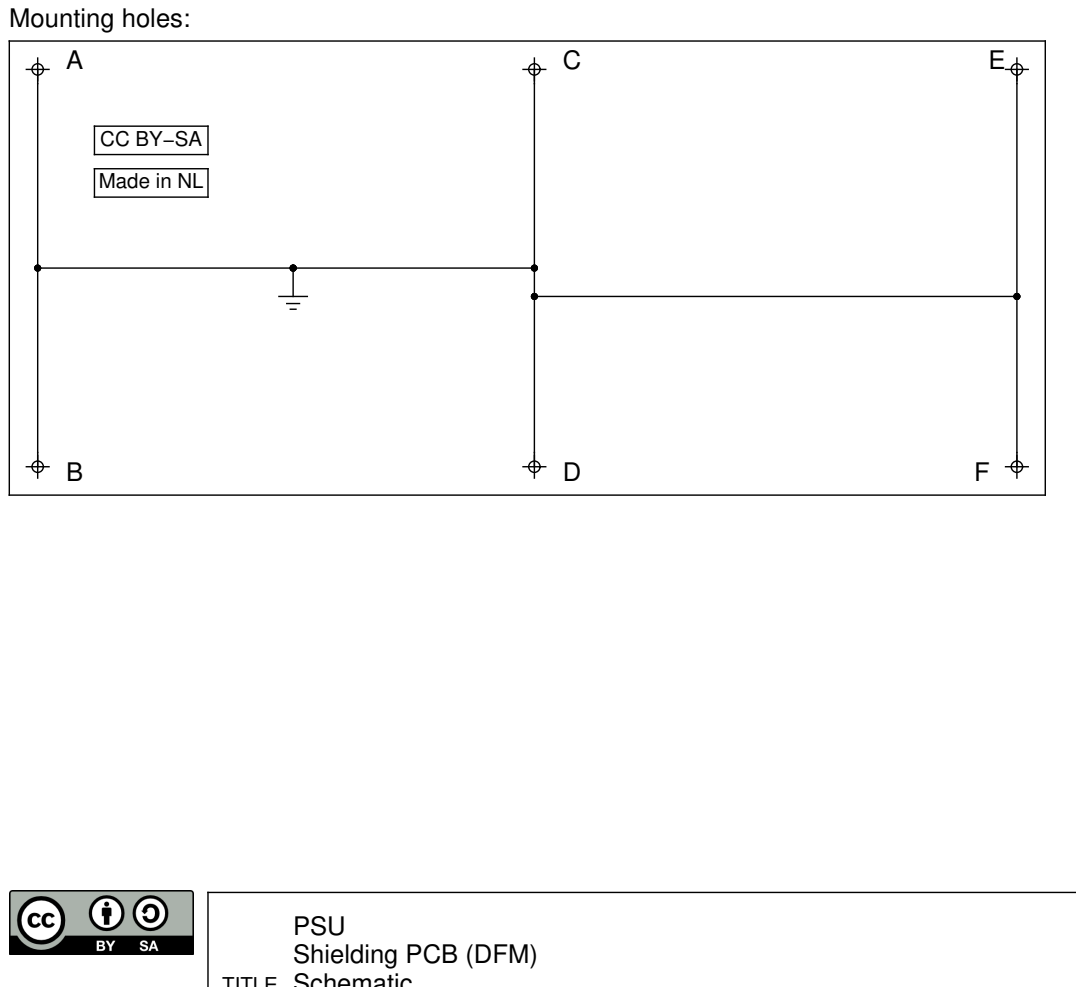
[picture p28: page 7]
Shielding PCB (DFM); Mounting holes:

Made in NL

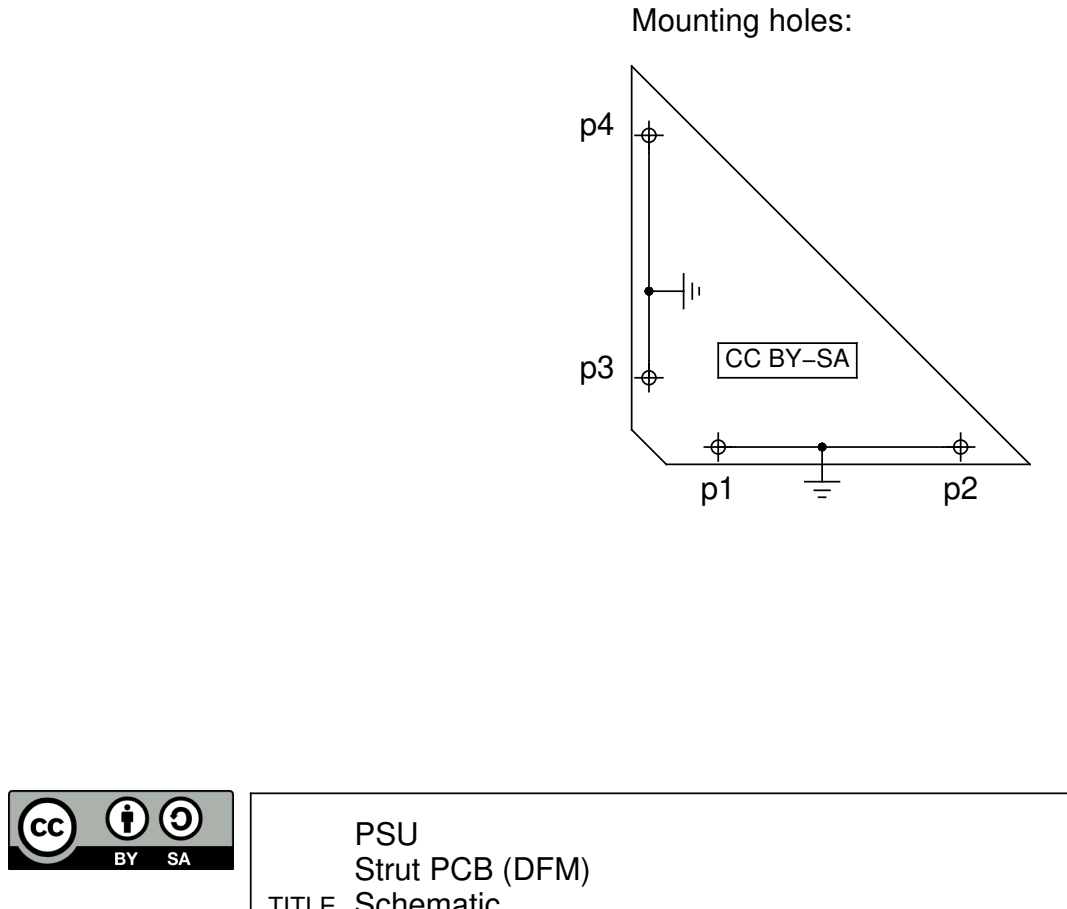
[picture p29: page 8]
Mounting holes:; Strut PCB (DFM)
