lambert/31/mcad/plotfiles/31.001.00.03.01_front_panel_mechanical.pdf

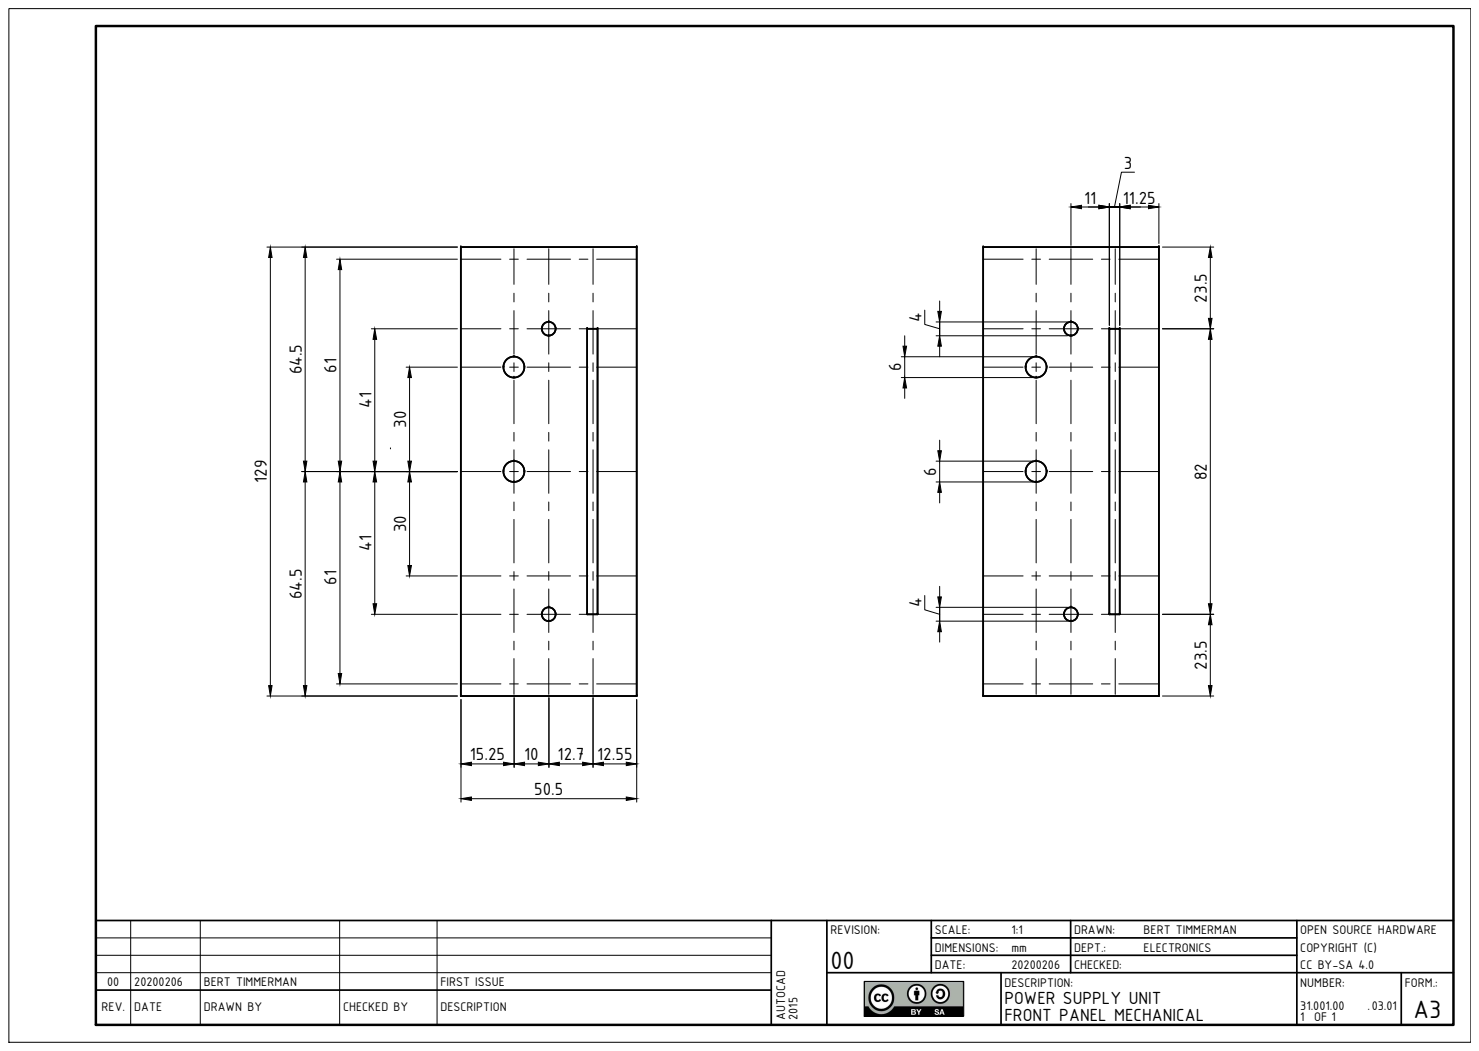
[picture p30: page 1]
REV.; DATE; DRAWN BY; CHECKED BY; DESCRIPTION; DATE: SCALE: DIMENSIONS: REVISION:; DEPT.: DRAWN: CHECKED: DESCRIPTION:; FORM.: . OF NUMBER: 31.001.00; A3 POWER SUPPLY UNIT FRONT PANEL MECHANICAL 1:1 mm20200206; BERT TIMMERMAN ELECTRONICS; OPEN SOURCE HARDWARE COPYRIGHT (C) CC BY-SA 4.0

2015 00 20200206 BERT TIMMERMAN FIRST ISSUE
