lambert/31/mcad/plotfiles/31.003.00.01.02_main_pcb_assembly_mechanical.pdf

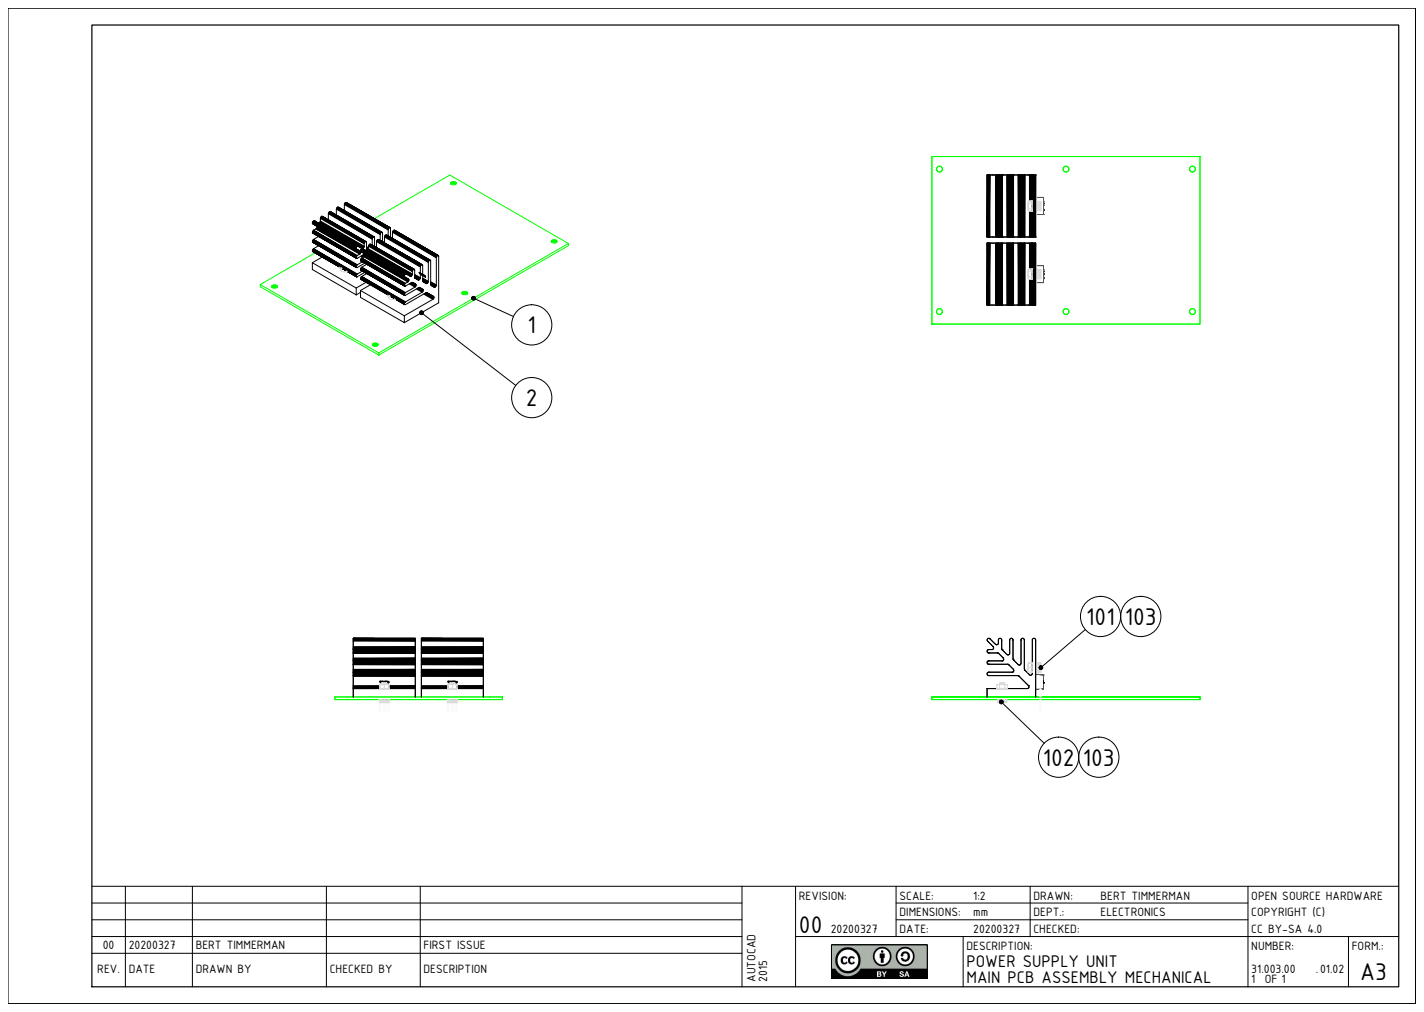
[picture p31: page 1]

REVISION: 00 20200327 | SCALE: 1:2 | DRAWN: BERT TIMMERMAN | OPEN SOURCE HARDWARE COPYRIGHT (C)

DIMENSIONS: mm | DEPT.: ELECTRONICS
DATE: 20200327 | CHECKED:

00 | 20200327 | BERT TIMMERMAN | | FIRST ISSUE | | DESCRIPTION: POWER SUPPLY UNIT MAIN PCB ASSEMBLY MECHANICAL | CC BY-SA 4.0 AUTOCAD 2015 NUMBER: 31.003.00 . OF 01.02 1 1 | FORM.: A3

REV. | DATE | DRAWN BY | CHECKED BY | DESCRIPTION
