lambert/31/mcad/plotfiles/31.004.00.03.01_shielding_pcb_mechanical.pdf

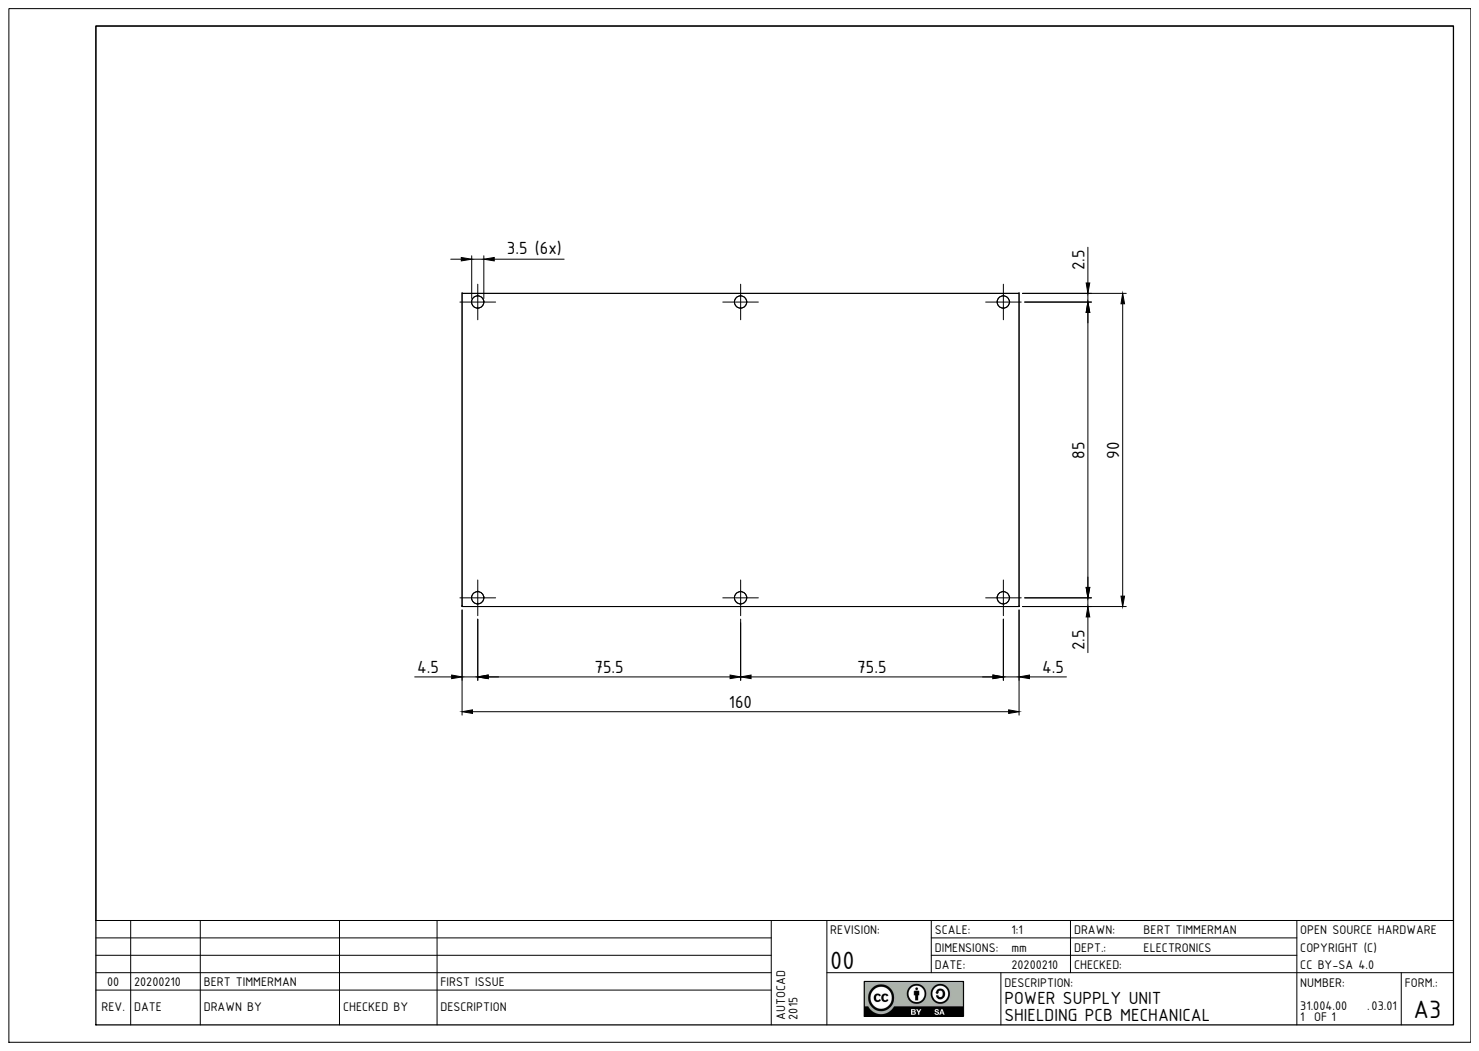
[picture p33: page 1]
REV.; DATE; DRAWN BY; CHECKED BY; DESCRIPTION; DATE: SCALE: DIMENSIONS: REVISION:; DEPT.: DRAWN: CHECKED: DESCRIPTION:; FORM.: . OF NUMBER: 31.004.00; A3 POWER SUPPLY UNIT SHIELDING PCB MECHANICAL 1:1 mm20200210; BERT TIMMERMAN ELECTRONICS; OPEN SOURCE HARDWARE COPYRIGHT (C) CC BY-SA 4.0

2015 00 20200210 BERT TIMMERMAN FIRST ISSUE 160
