lambert/31/mcad/plotfiles/31.006.00.03.01_heatsink_mechanical.pdf

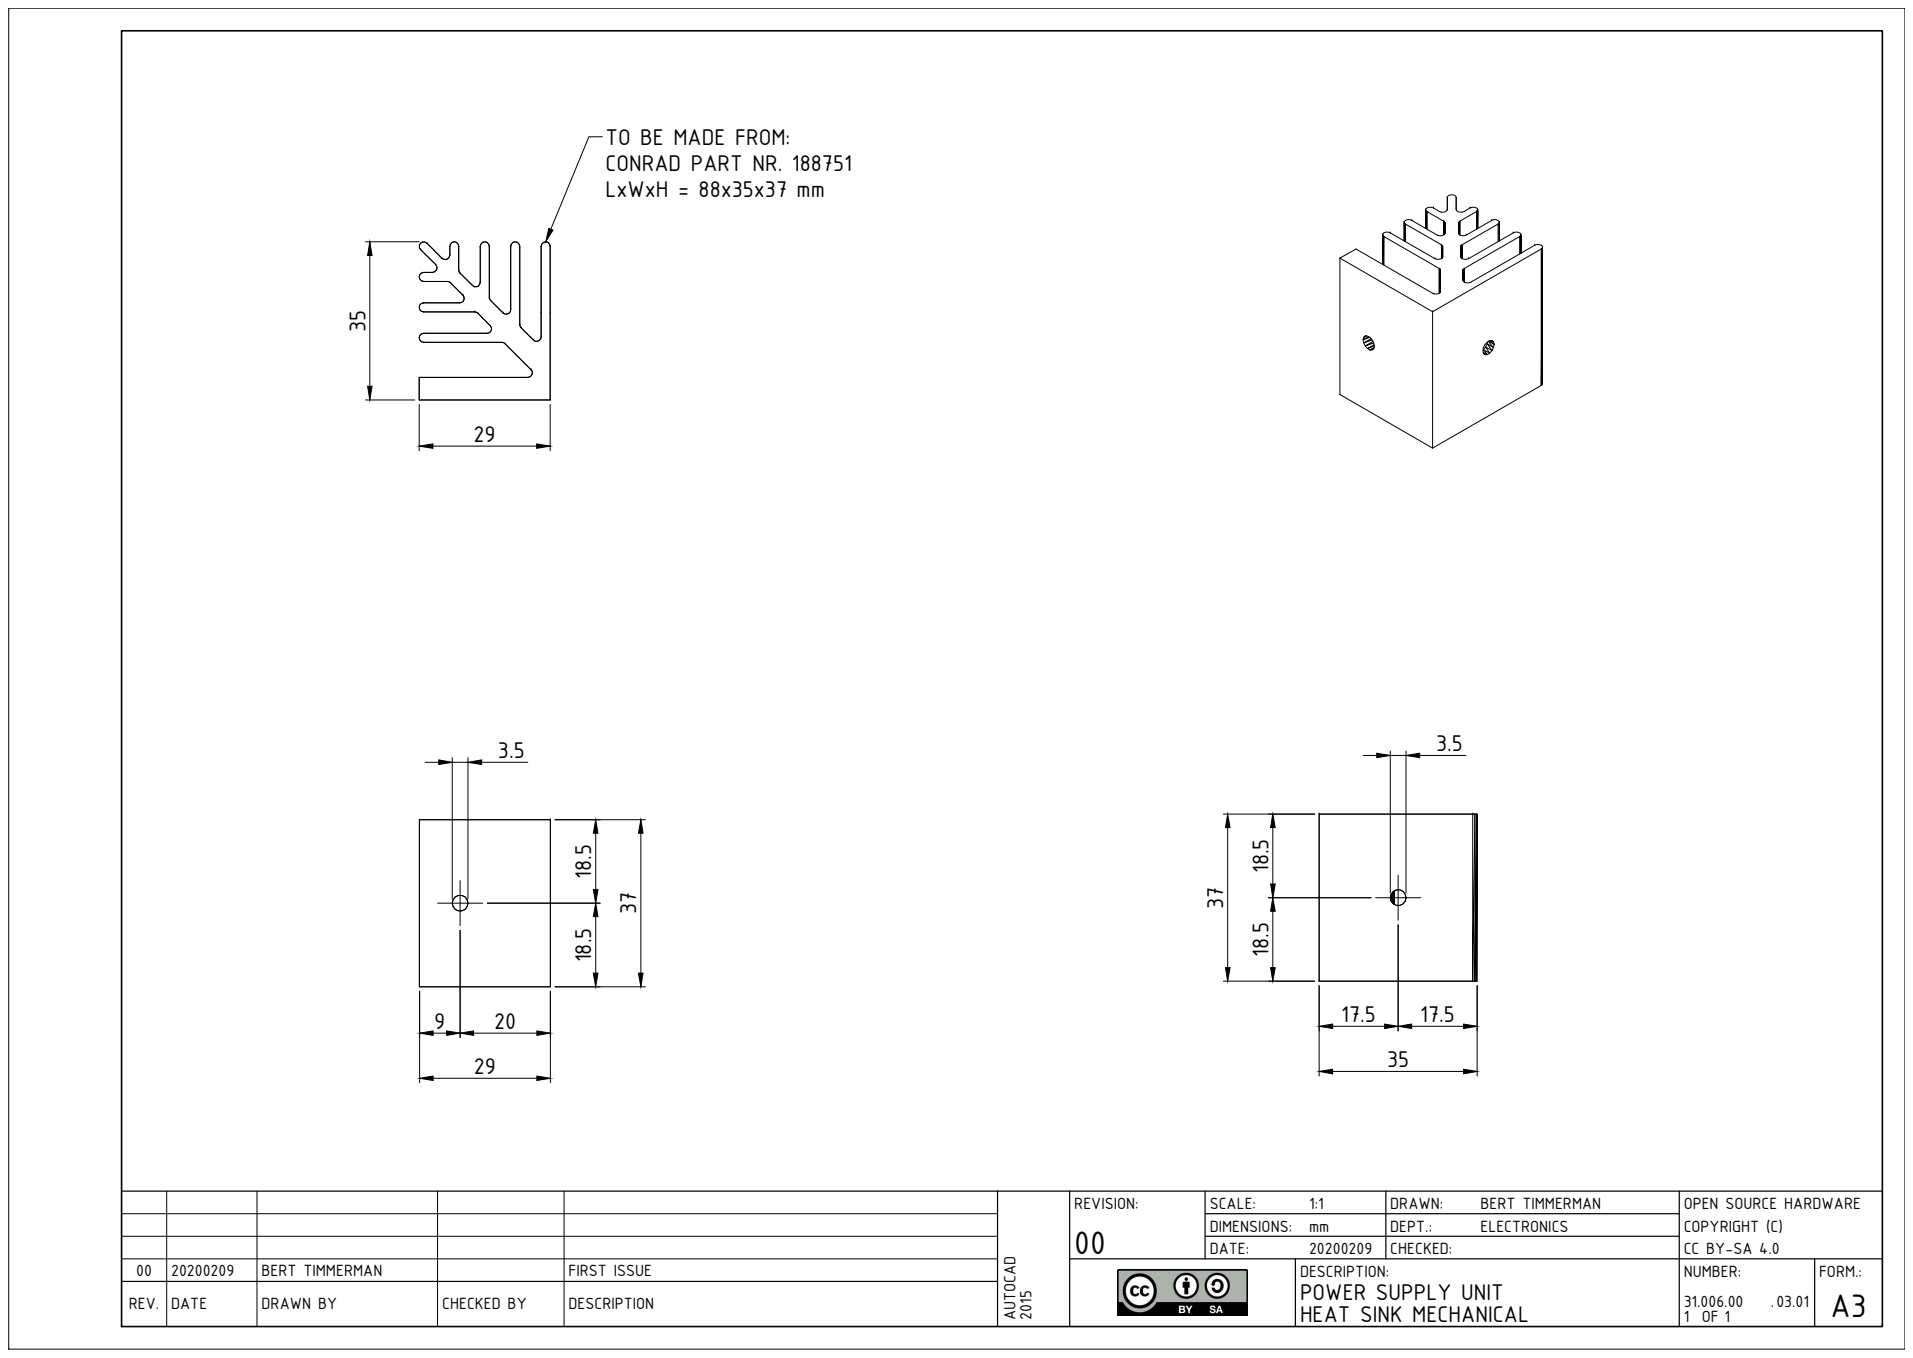
[picture p35: page 1]
REV.; DATE; DRAWN BY; CHECKED BY; DESCRIPTION; DATE: SCALE: DIMENSIONS: REVISION:; DEPT.: DRAWN: CHECKED: DESCRIPTION:; FORM.: . OF NUMBER: 31.006.00; A3 POWER SUPPLY UNIT HEAT SINK MECHANICAL 1:1 mm20200209; BERT TIMMERMAN ELECTRONICS; OPEN SOURCE HARDWARE COPYRIGHT (C) CC BY-SA 4.0

18.5 9 20 17.5 17.5 TO BE MADE FROM: CONRAD PART NR. 188751 LxWxH = 88x35x37 mm 3.5 3.5

2015 00 20200209 BERT TIMMERMAN FIRST ISSUE 29
