lambert/31/mcad/plotfiles/31.000.00.01.06_assembly_left_view.pdf

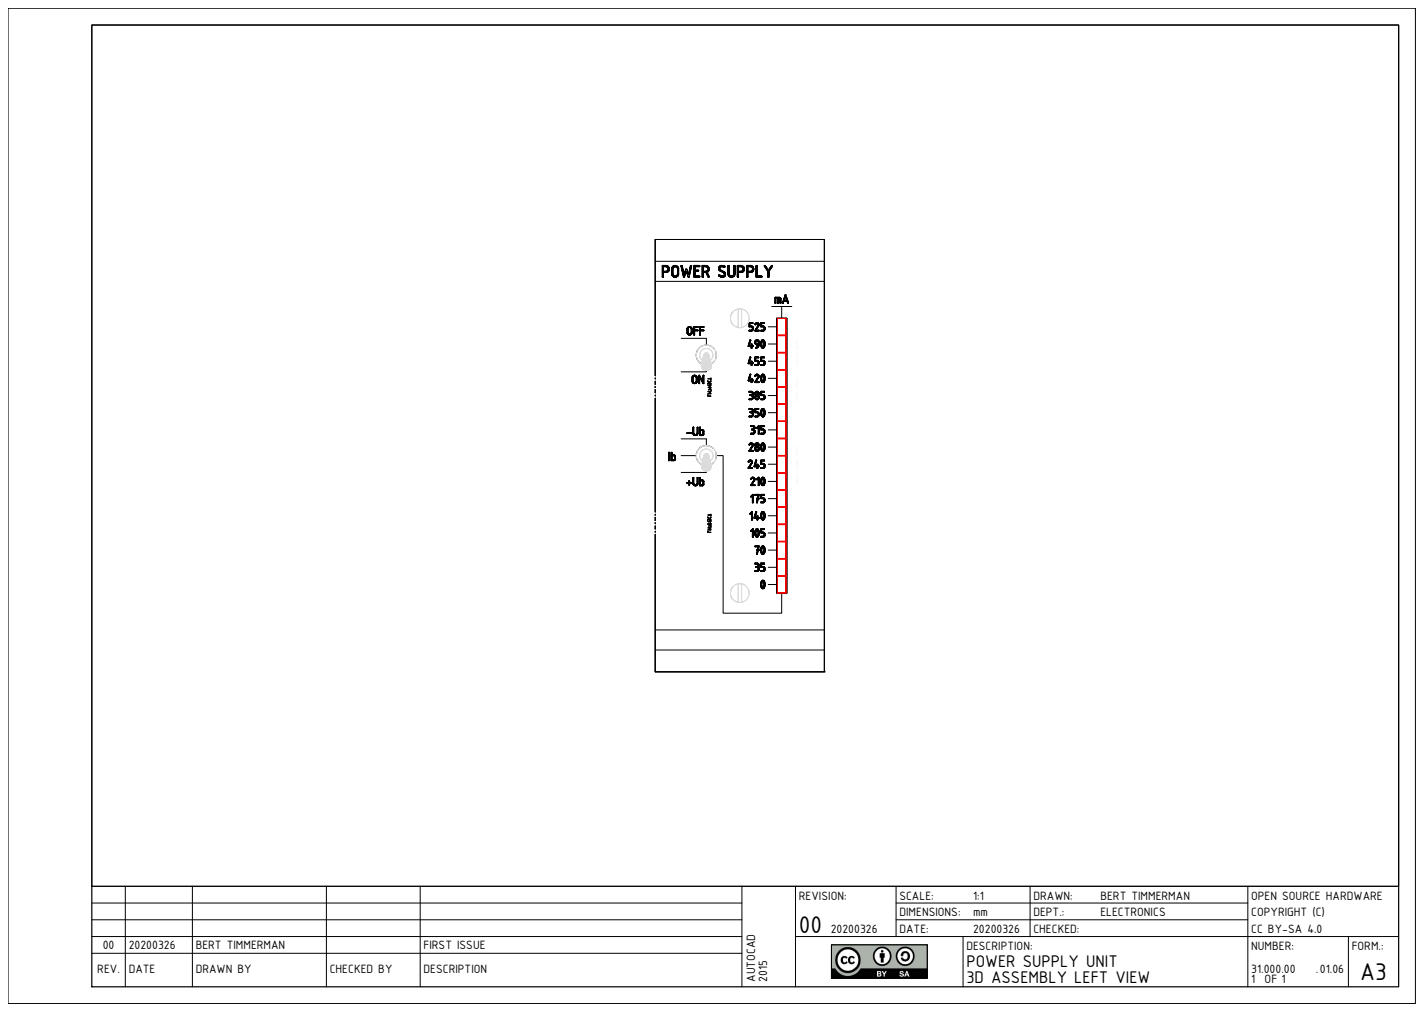
[picture p36: page 1]
REV. DATE; DRAWN BY; CHECKED BY; DESCRIPTION; DESCRIPTION:; FORM.: . OF; POWER SUPPLY UNIT 3D ASSEMBLY LEFT VIEW; BERT TIMMERMAN; FIRST ISSUE

OPEN SOURCE HARDWARE
COPYRIGHT (C)

CC BY-SA 4.0 AUTOCAD 2015
