lambert/31/mcad/plotfiles/31.000.00.01.07_assembly_right_view.pdf

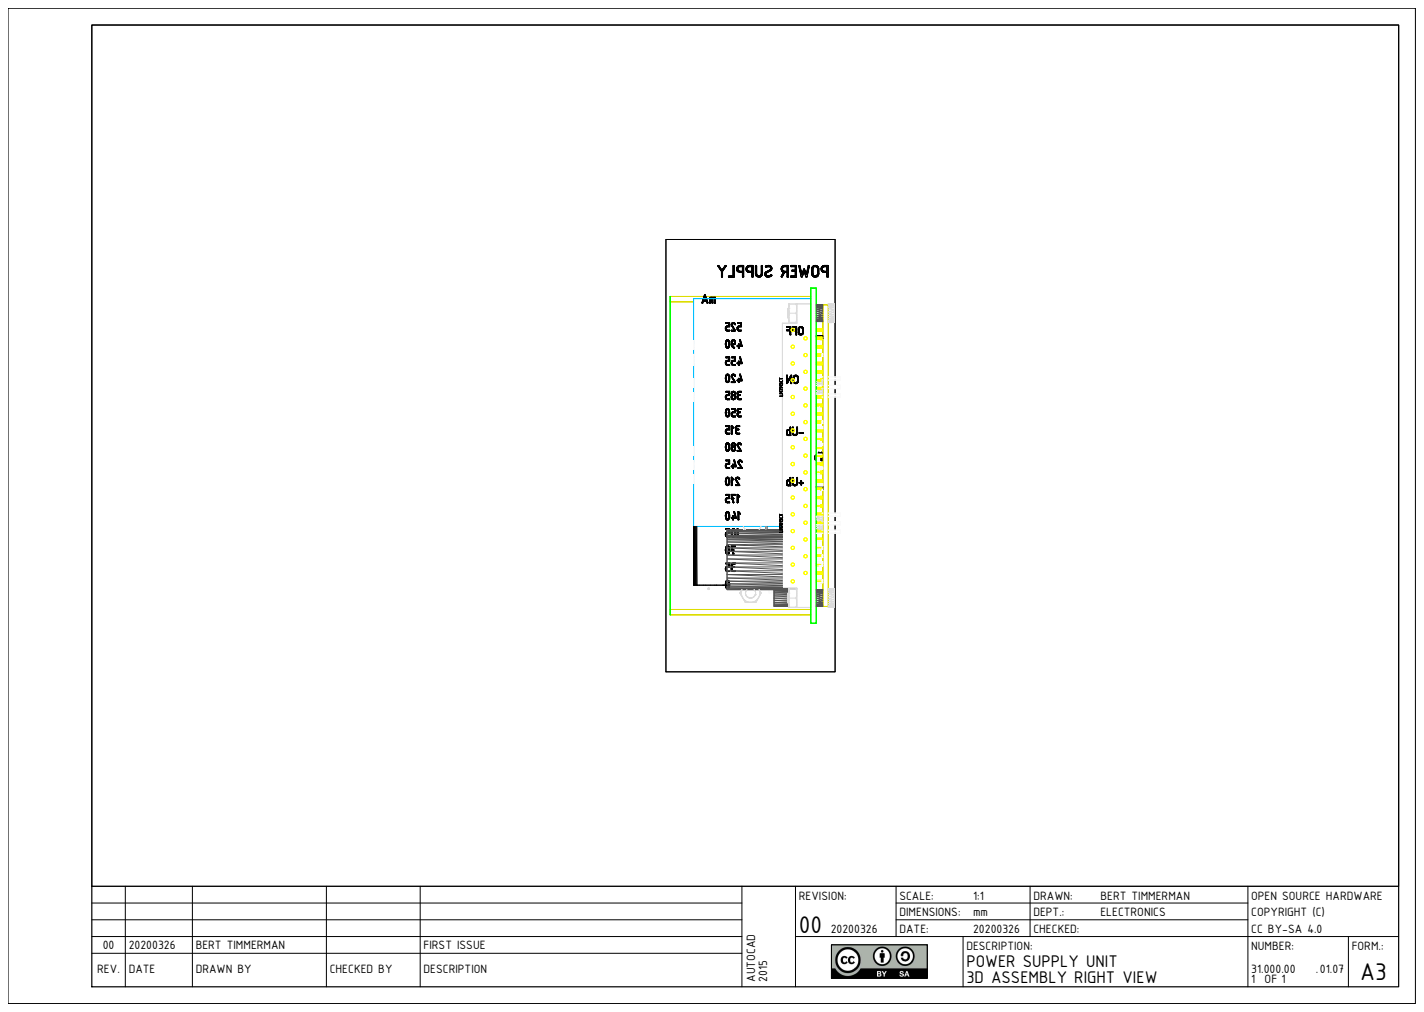
[picture p37: page 1]
REV. DATE; DRAWN BY; CHECKED BY; DESCRIPTION; DESCRIPTION:; FORM.: . OF; POWER SUPPLY UNIT 3D ASSEMBLY RIGHT VIEW; BERT TIMMERMAN; FIRST ISSUE

OPEN SOURCE HARDWARE
COPYRIGHT (C)

CC BY-SA 4.0 AUTOCAD 2015
