lambert/31/mcad/plotfiles/31.002.00.03.01_front_pcb_mechanical.pdf

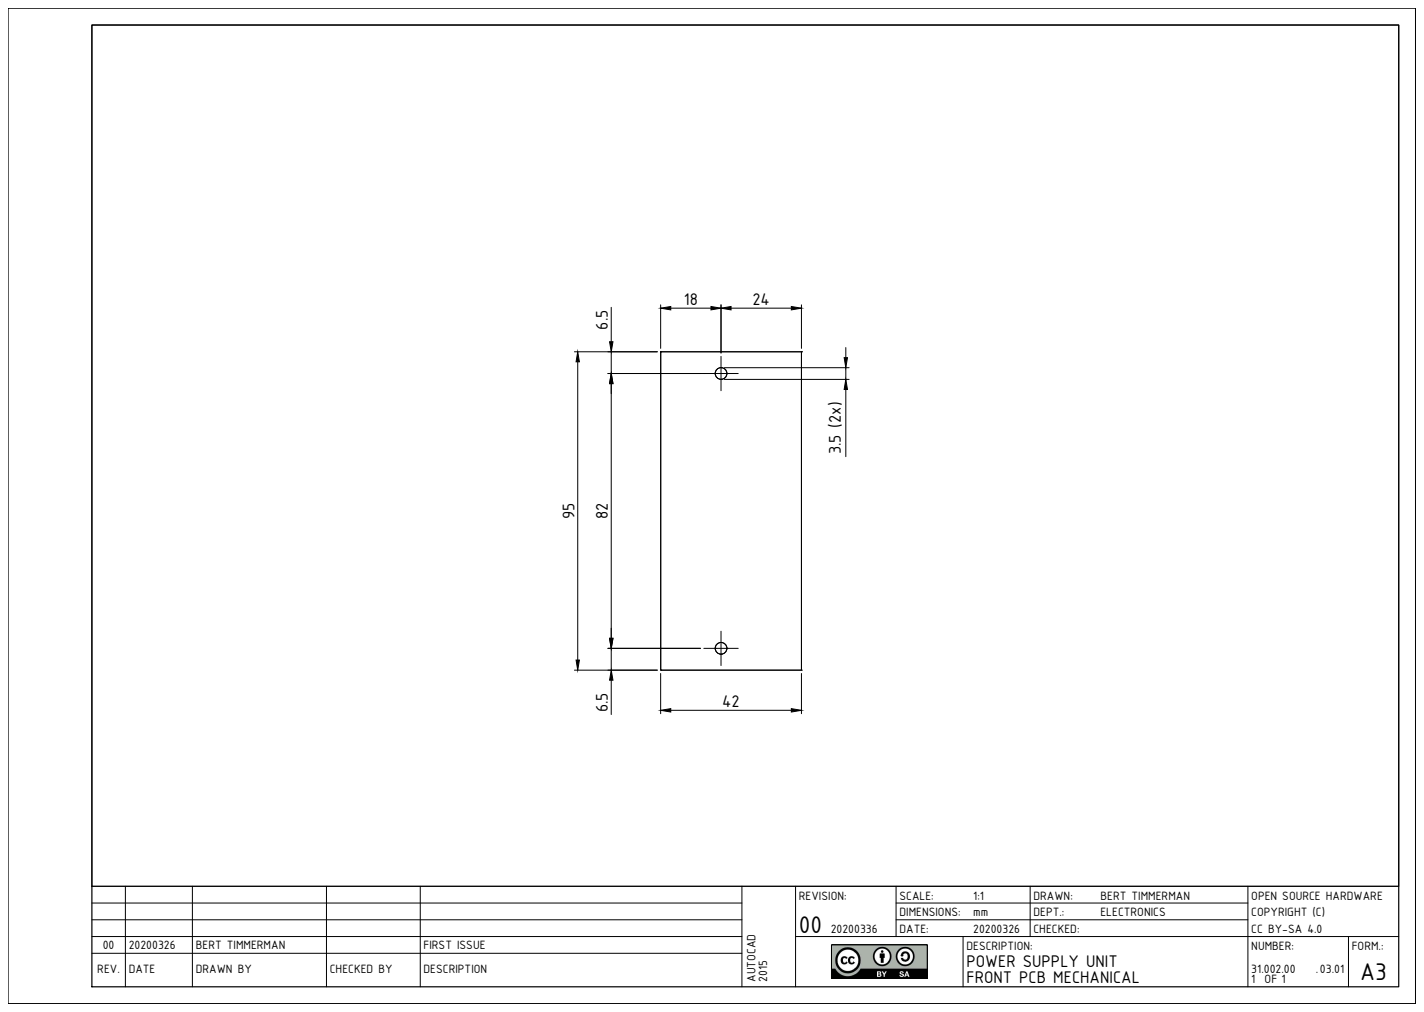
[picture p39: page 1]
BERT TIMMERMAN; FIRST ISSUE

REVISION: 00 20200336 | SCALE: 1:1 | DRAWN: BERT TIMMERMAN | OPEN SOURCE HARDWARE COPYRIGHT (C)

DIMENSIONS: mm | DEPT.: ELECTRONICS
DATE: 20200326 | CHECKED:

DESCRIPTION: POWER SUPPLY UNIT FRONT PCB MECHANICAL | CC BY-SA 4.0 AUTOCAD 2015 NUMBER: 31.002.00 . OF 03.01 1 1 | FORM.: A3

REV. | DATE | DRAWN BY | CHECKED BY | DESCRIPTION
