lambert/31/mcad/plotfiles/31.003.00.01.01_main_pcb_assembly.pdf

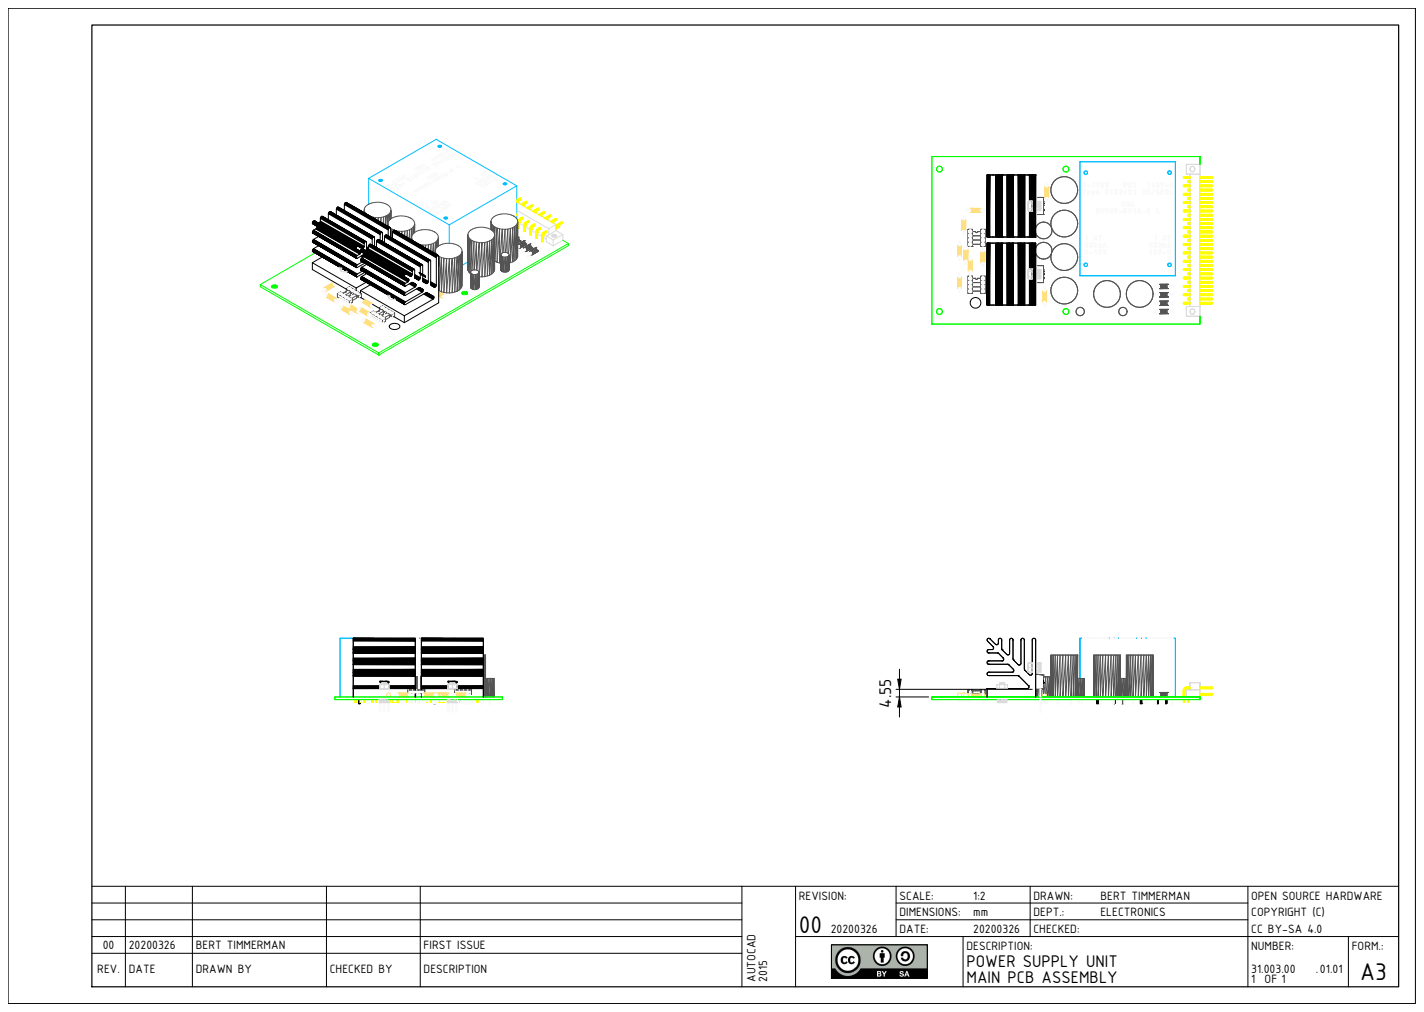
[picture p40: page 1]
REV. DATE; DRAWN BY; CHECKED BY; DESCRIPTION; POWER SUPPLY UNIT MAIN PCB ASSEMBLY; BERT TIMMERMAN; FIRST ISSUE

OPEN SOURCE HARDWARE
COPYRIGHT (C)

CC BY-SA 4.0 AUTOCAD 2015
