lambert/31/mcad/plotfiles/31.000.00.01.01_assembly_ISO_views.pdf

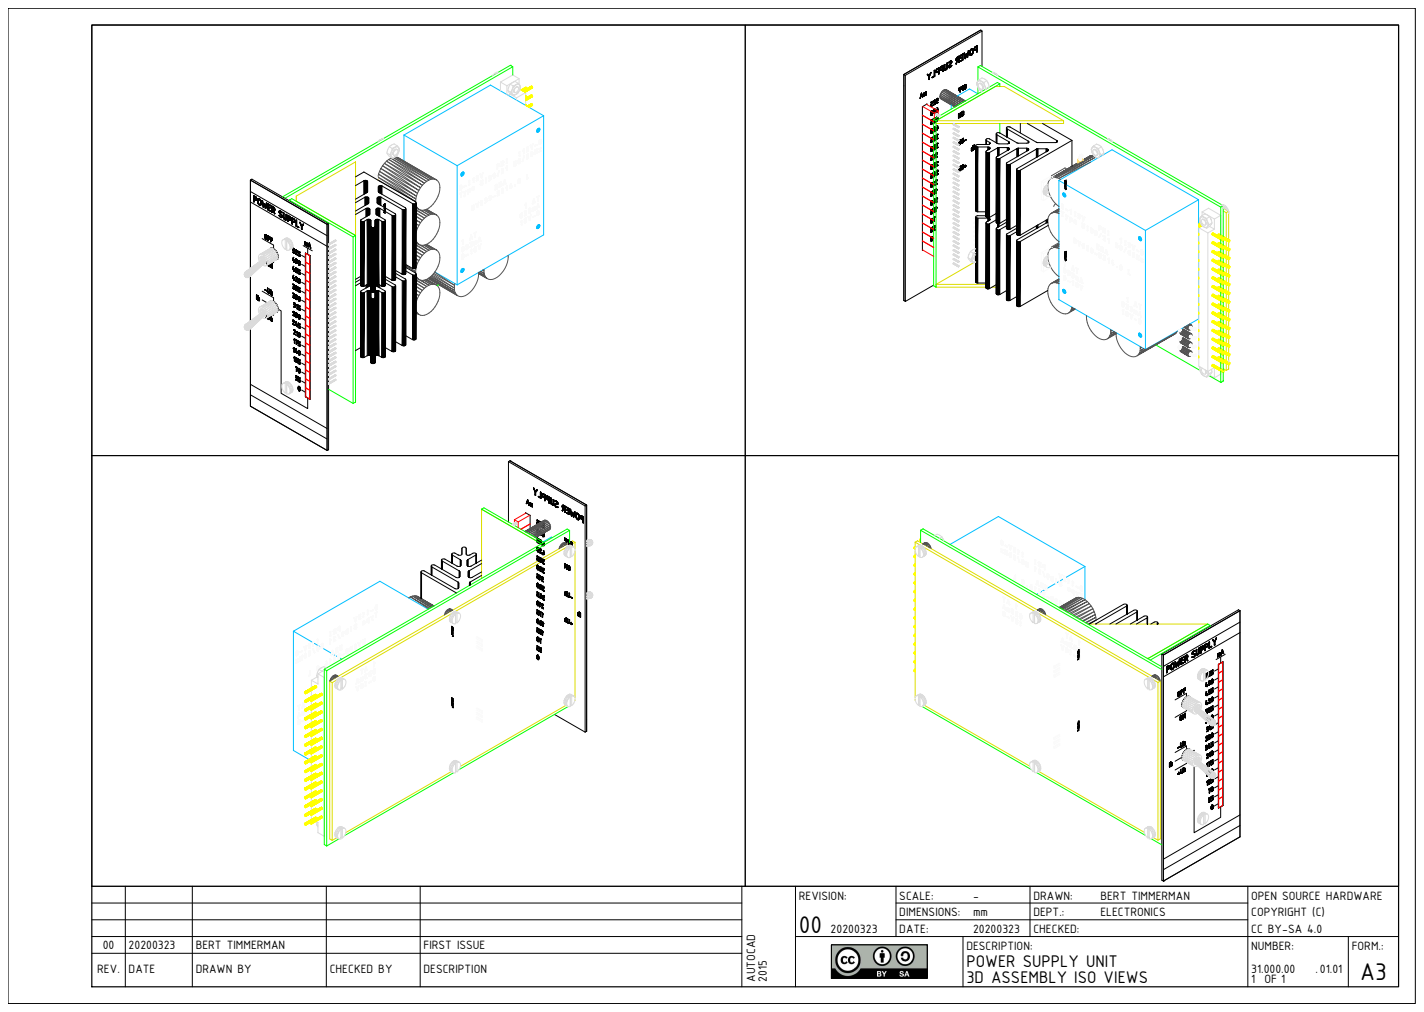
[picture p41: page 1]
REV. DATE; DRAWN BY; CHECKED BY; DESCRIPTION; DESCRIPTION:; FORM.: . OF; BERT TIMMERMAN; FIRST ISSUE

3D ASSEMBLY ISO VIEWS -mm

OPEN SOURCE HARDWARE
COPYRIGHT (C)

CC BY-SA 4.0 AUTOCAD 2015

POWER SUPPLY UNIT
