lambert/31/mcad/plotfiles/31.000.00.01.03_assembly_bottom_view.pdf

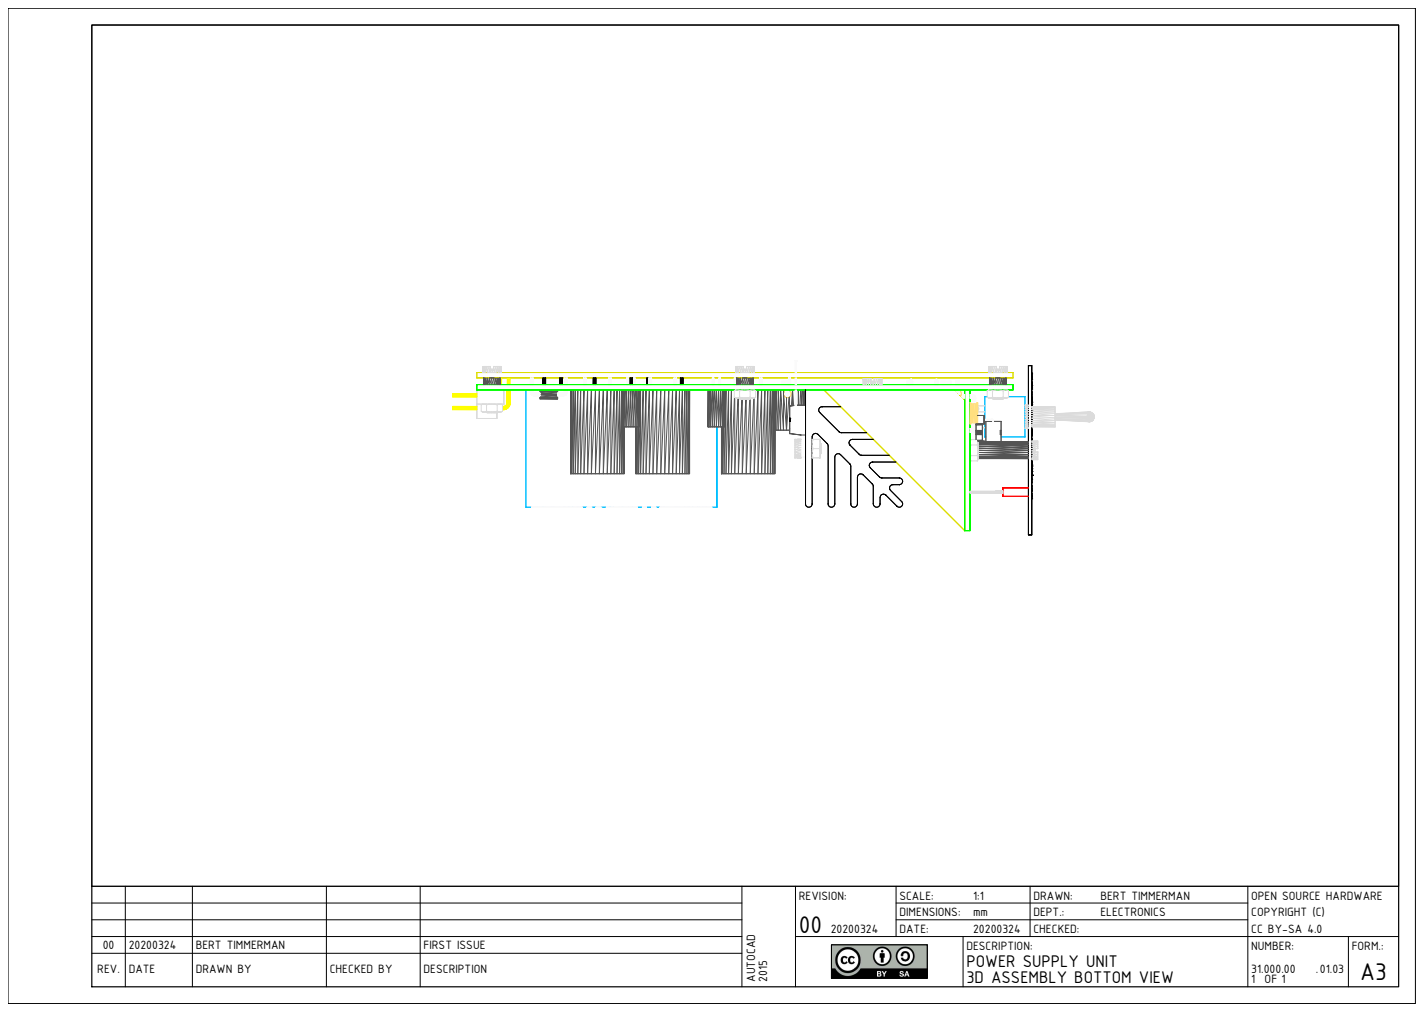
[picture p43: page 1]
REV. DATE; DRAWN BY; CHECKED BY; DESCRIPTION; DESCRIPTION:; FORM.: . OF; POWER SUPPLY UNIT 3D ASSEMBLY BOTTOM VIEW; BERT TIMMERMAN; FIRST ISSUE

OPEN SOURCE HARDWARE
COPYRIGHT (C)

CC BY-SA 4.0 AUTOCAD 2015
