lambert/31/mcad/plotfiles/31.001.00.02.03_front_panel_drill_info.pdf

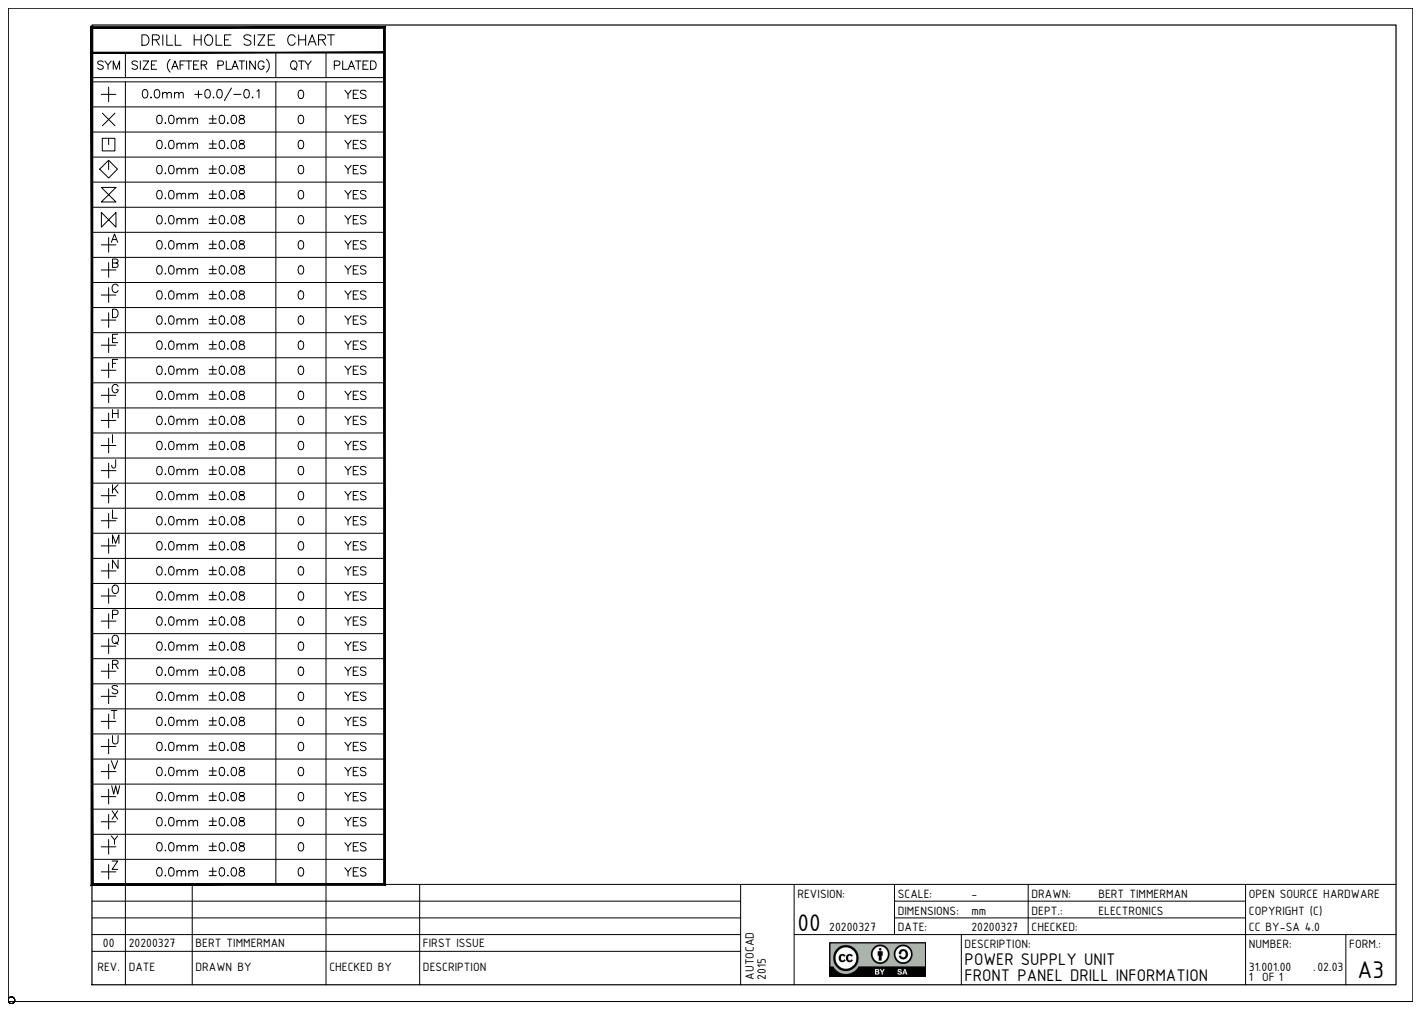
[picture p46: page 1]

REVISION: 00 20200327 | SCALE: | DRAWN: BERT TIMMERMAN | OPEN SOURCE HARDWARE COPYRIGHT (C)

FRONT PANEL DRILL INFORMATION -mm

DIMENSIONS: | DEPT.: ELECTRONICS
DATE: 20200327 | CHECKED:

00 | 20200327 | BERT TIMMERMAN | | FIRST ISSUE | | DESCRIPTION: POWER SUPPLY UNIT | CC BY-SA 4.0 AUTOCAD 2015 NUMBER: 31.001.00 1 02.03 1 | FORM.: . OF A3

REV. | DATE | DRAWN BY | CHECKED BY | DESCRIPTION
