lambert/31/mcad/plotfiles/31.003.00.02.02_main_pcb_drill_info.pdf

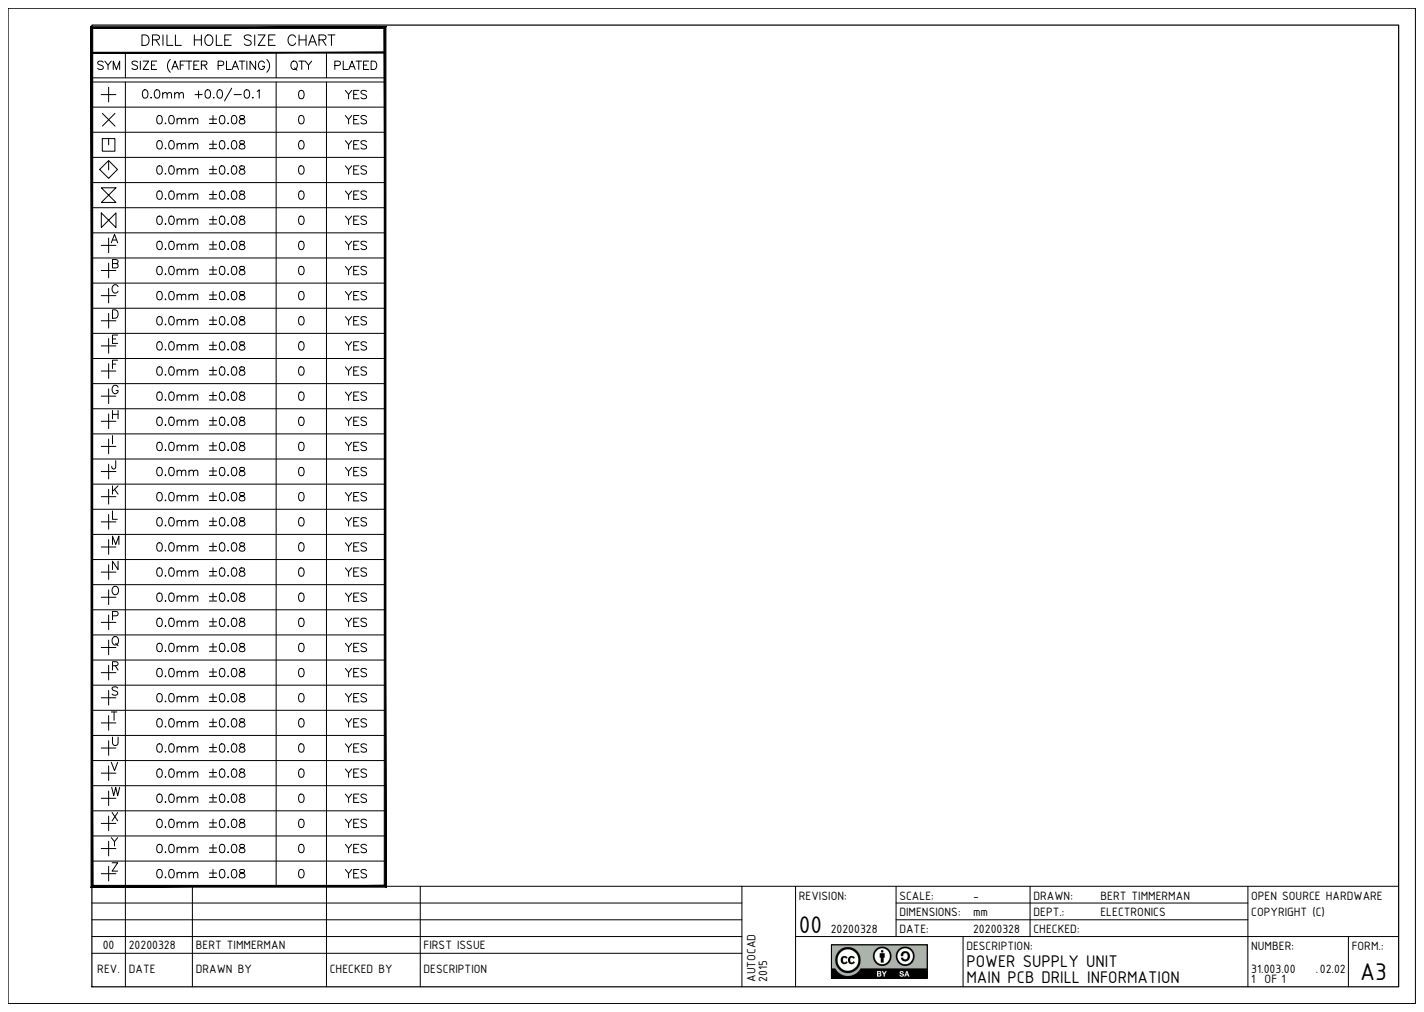
[picture p48: page 1]

REVISION: 00 20200328 | SCALE: | DRAWN: BERT TIMMERMAN | OPEN SOURCE HARDWARE

MAIN PCB DRILL INFORMATION -mm

DATE: 20200328 | CHECKED: | COPYRIGHT (C) AUTOCAD 2015

DIMENSIONS: | DEPT.: ELECTRONICS

00 | 20200328 | BERT TIMMERMAN | | FIRST ISSUE | | DESCRIPTION: POWER SUPPLY UNIT | NUMBER: 31.003.00 1 02.02 1 | FORM.: . OF A3

REV. | DATE | DRAWN BY | CHECKED BY | DESCRIPTION
