lambert/31/mcad/plotfiles/31.001.00.02.01_front_panel_layout.pdf

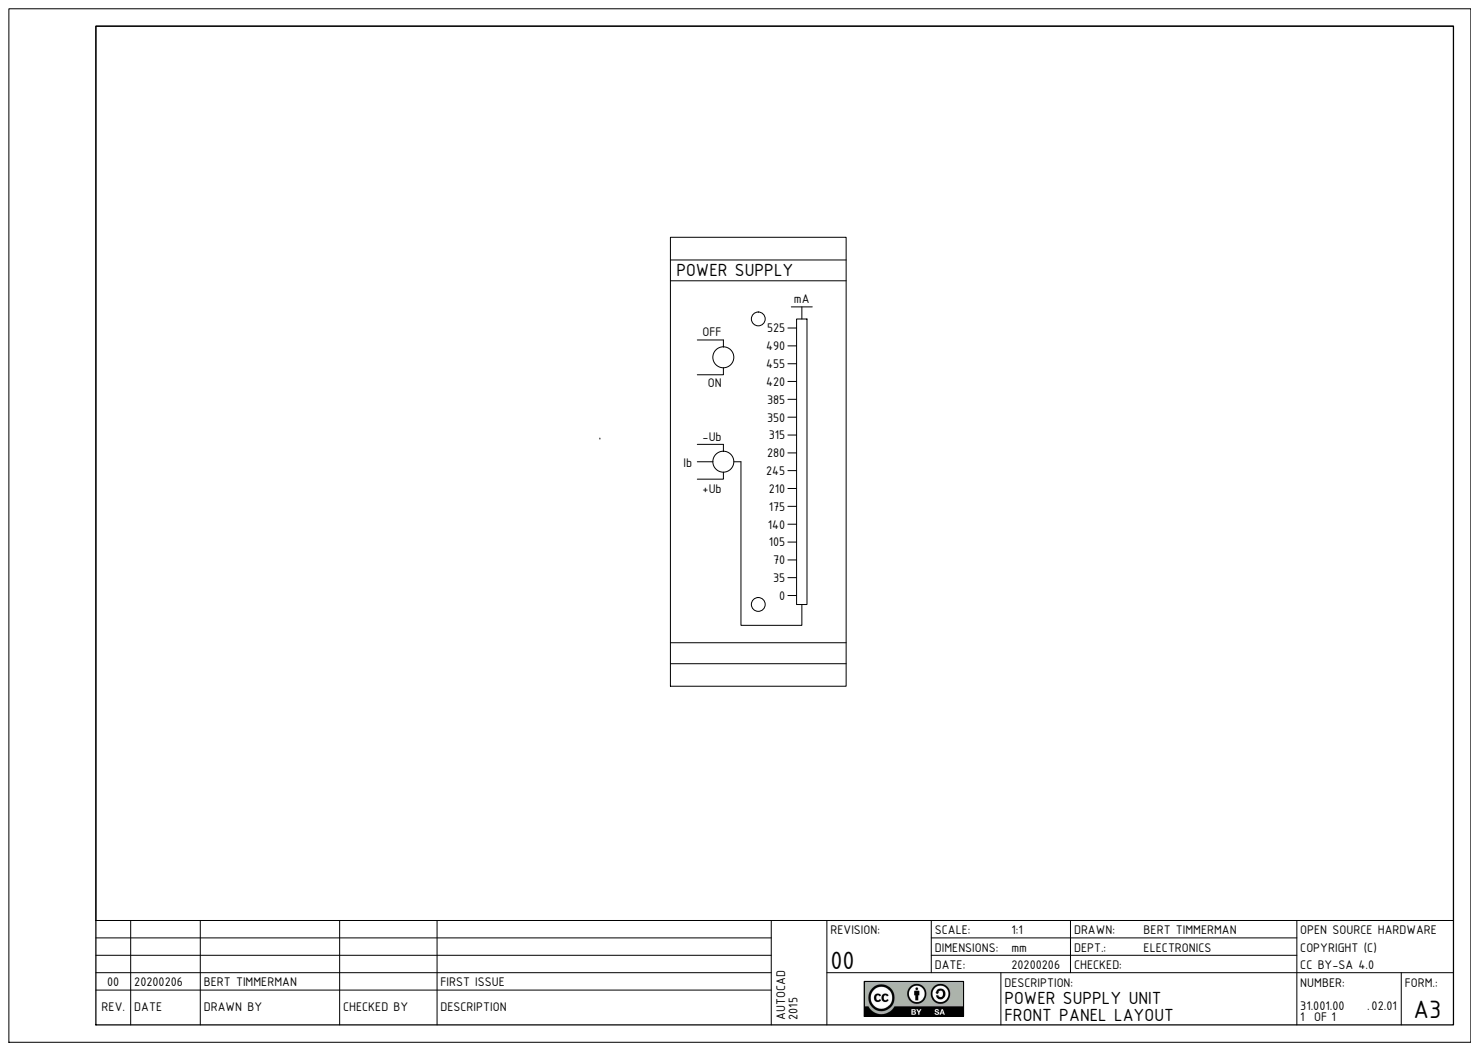
[picture p49: page 1]
POWER SUPPLY OFFON +Ub -Ub Ib; mA 03570 105 140 175 210 245 280 315 350 385 420 455 490 525 REV.; DATE; DRAWN BY; CHECKED BY; DESCRIPTION; DATE: SCALE: DIMENSIONS: REVISION:; DEPT.: DRAWN: CHECKED: DESCRIPTION:; FORM.: . OF NUMBER: 31.001.00; A3 POWER SUPPLY UNIT FRONT PANEL LAYOUT 1:1 mm20200206; BERT TIMMERMAN ELECTRONICS; OPEN SOURCE HARDWARE COPYRIGHT (C) CC BY-SA 4.0

2015 00 20200206 BERT TIMMERMAN FIRST ISSUE
