lambert/31/ecad/pcb/plotfiles/31.001.00.01.01.pcb.pdf

## 31.001.00.01.01.pcb

## 1. Table of Contents (This Page) Created on Sun Jan 3 12:16:31 2021 2. top 3. bottom 4. outline 5. plated-drill 6. unplated-drill 7. componentmask 8. soldermask 9. topsilk 10. bottomsilk 11. bottompaste 12. topassembly 13. bottomassembly 14. fab

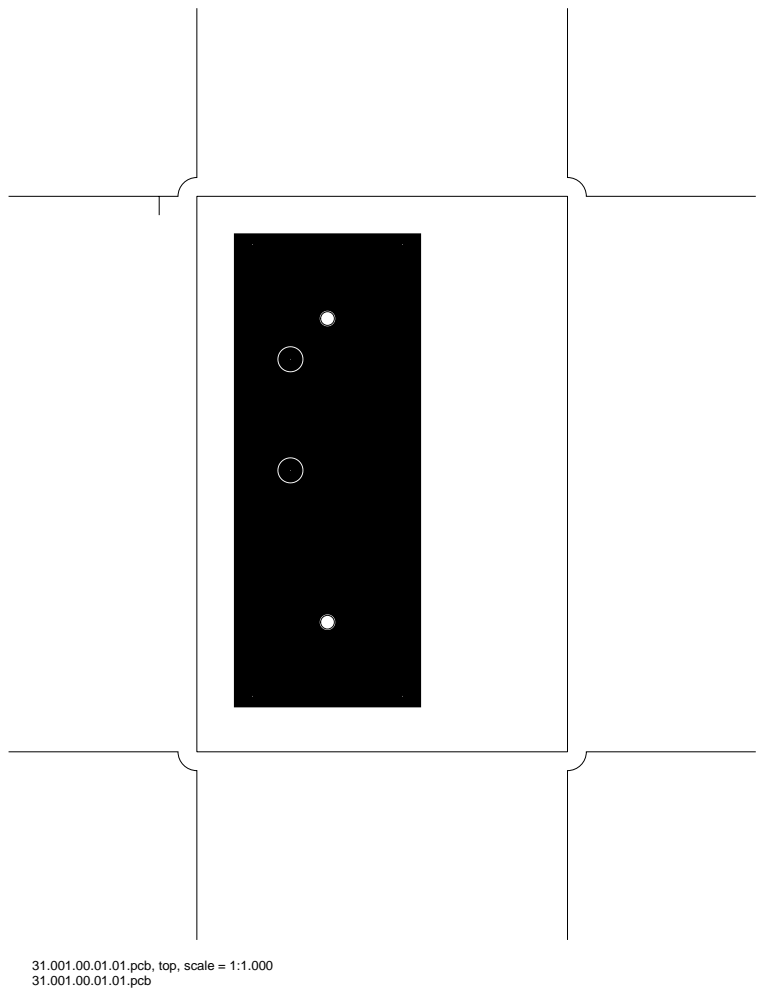
[picture p50: page 2]

31.001.00.01.01.pcb, top, scale = 1:1.000

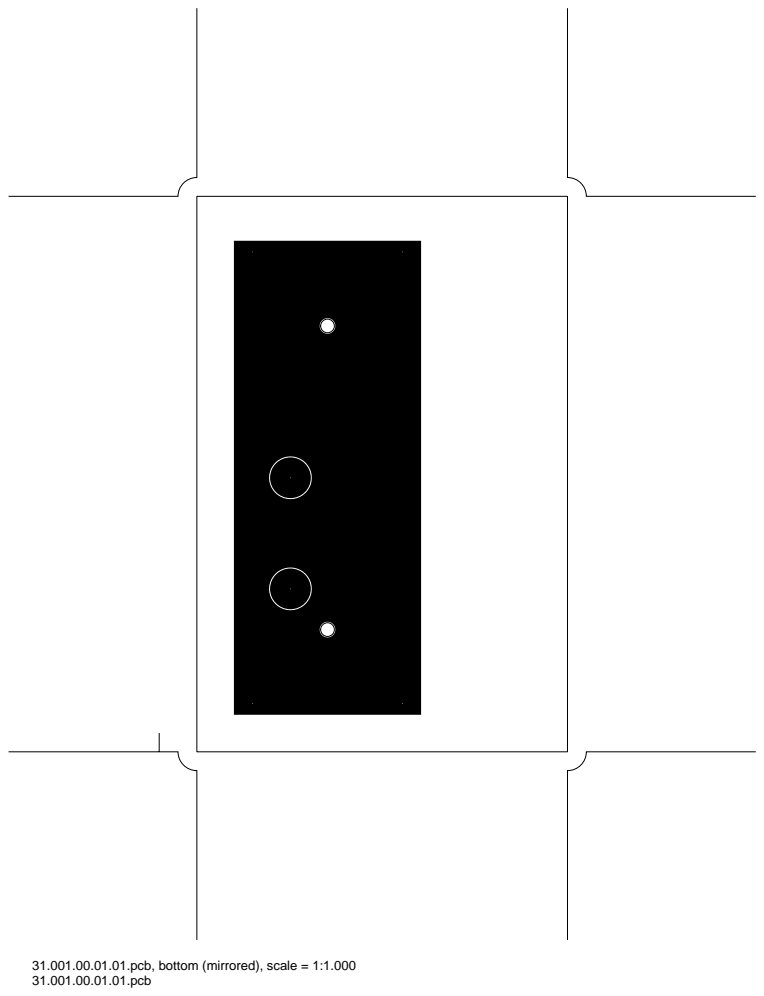
[picture p51: page 3]

31.001.00.01.01.pcb, bottom (mirrored), scale = 1:1.000

31.001.00.01.01.pcb, outline, scale = 1:1.000

31.001.00.01.01.pcb, plated-drill, scale = 1:1.000

31.001.00.01.01.pcb, unplated-drill, scale = 1:1.000

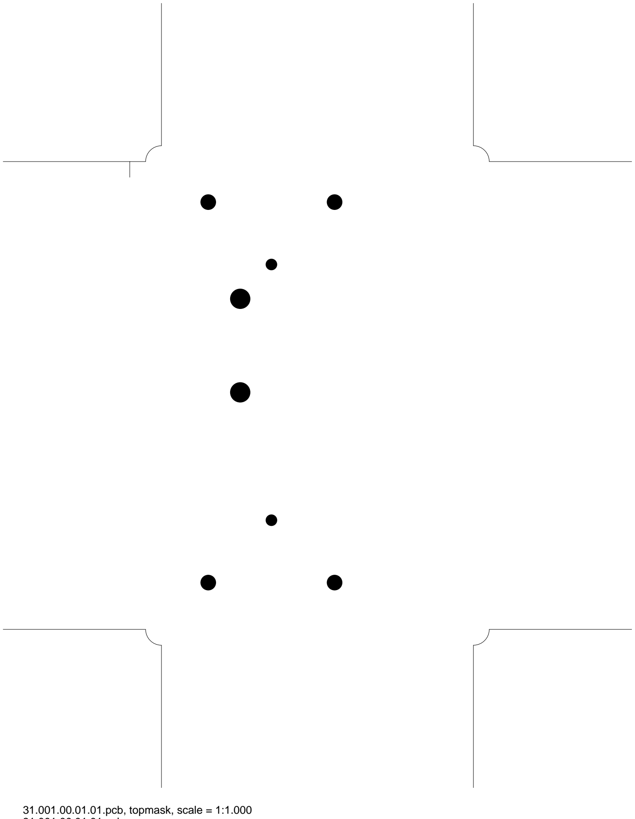
[picture p52: figure]
31.001.00.01.01.pcb, topmask, scale = 1:1.000
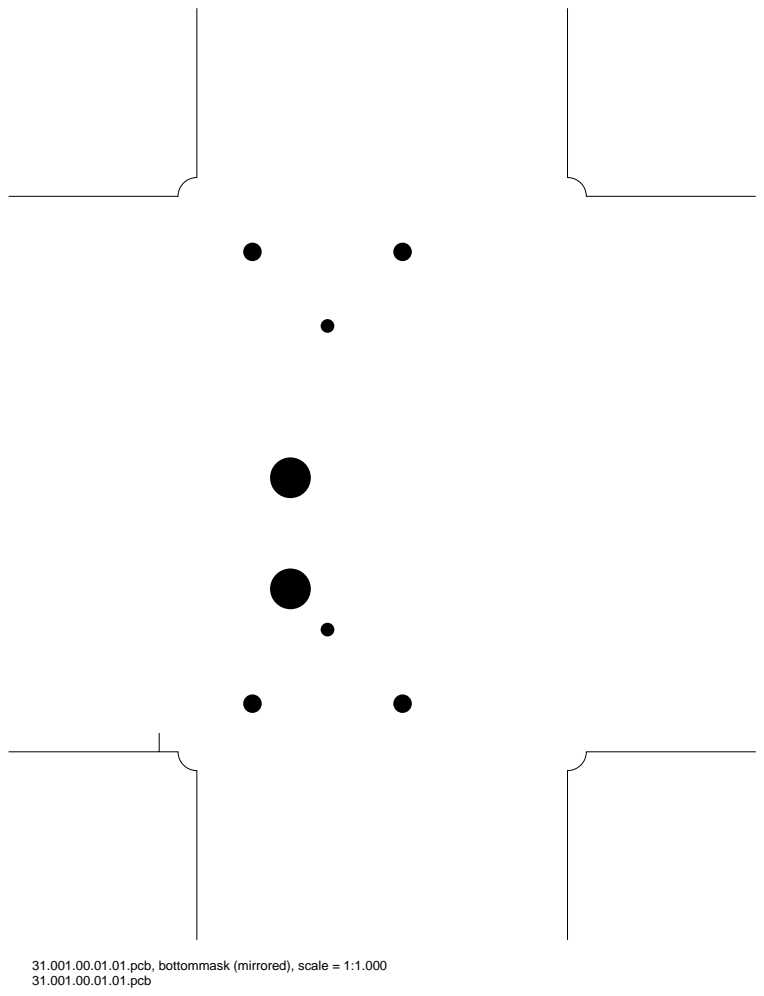
[picture p53: page 8]

31.001.00.01.01.pcb, bottommask (mirrored), scale = 1:1.000

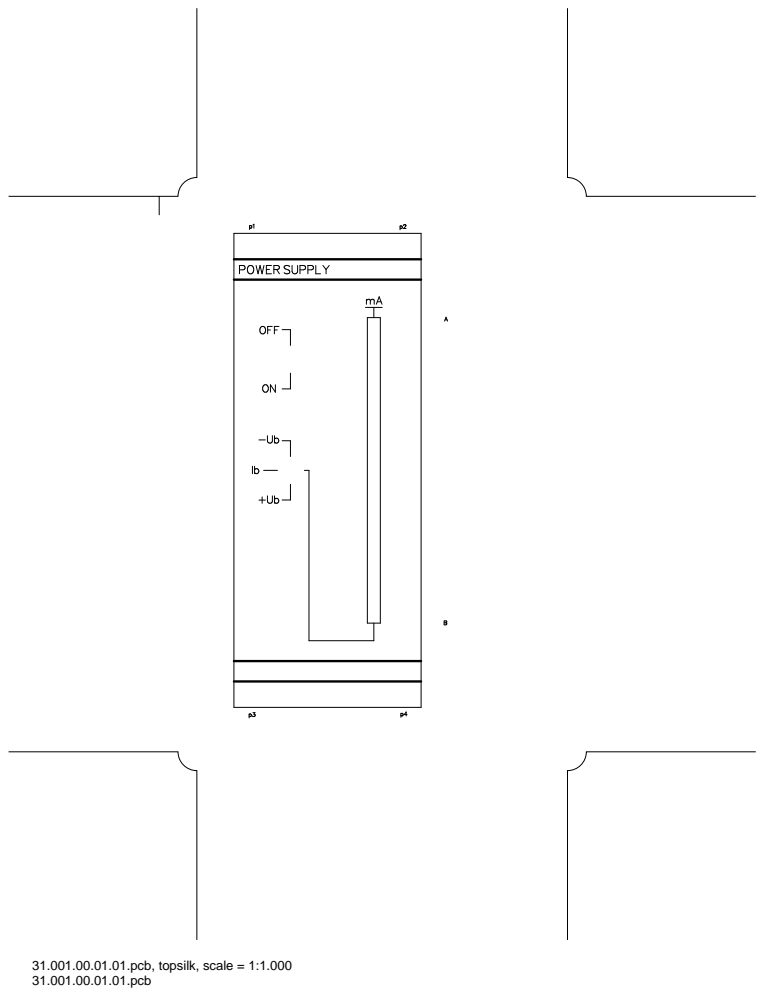
[picture p54: page 9]

31.001.00.01.01.pcb, topsilk, scale = 1:1.000

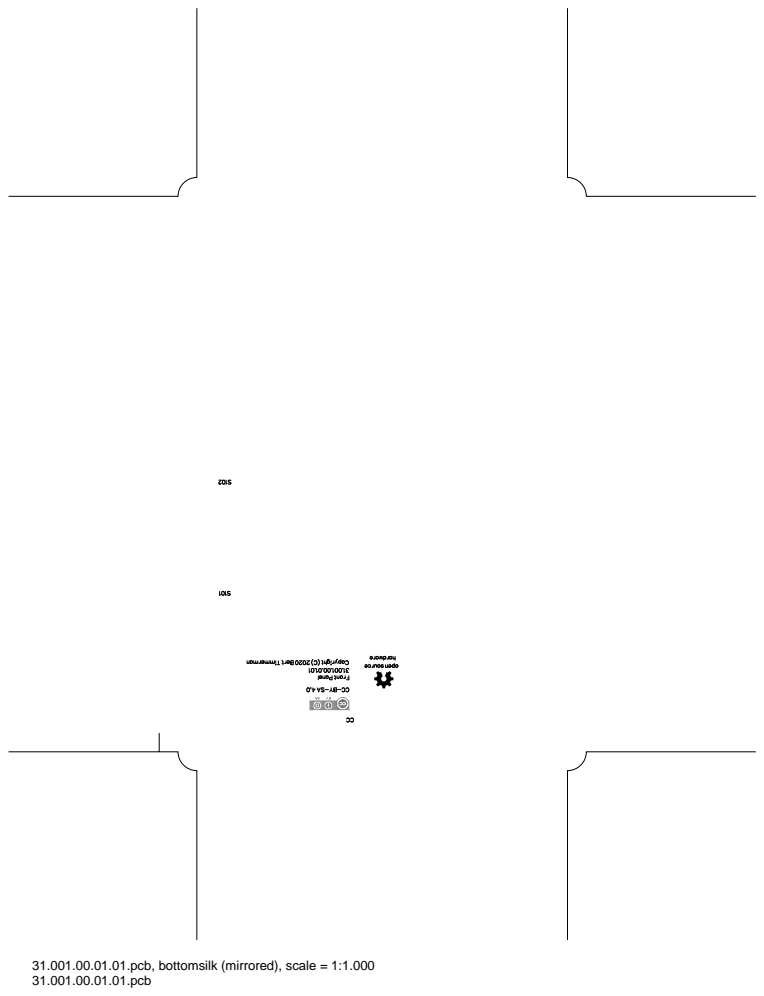
[picture p55: page 10]

31.001.00.01.01.pcb, bottomsilk (mirrored), scale = 1:1.000

31.001.00.01.01.pcb, bottompaste (mirrored), scale = 1:1.000

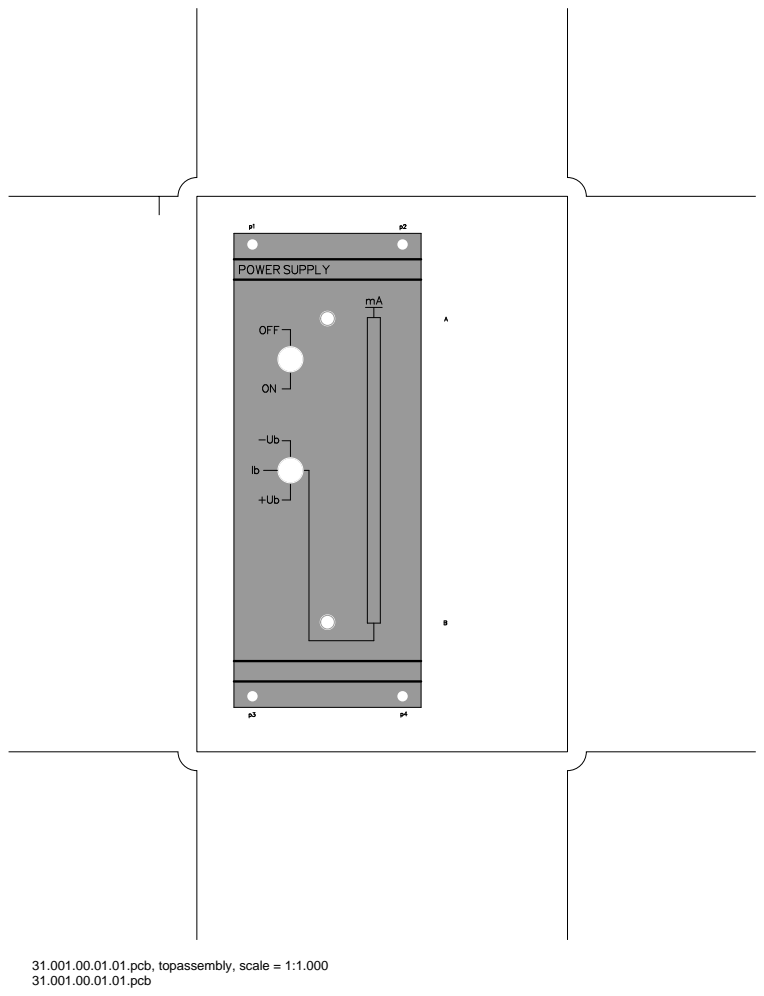
[picture p56: page 12]

31.001.00.01.01.pcb, topassembly, scale = 1:1.000

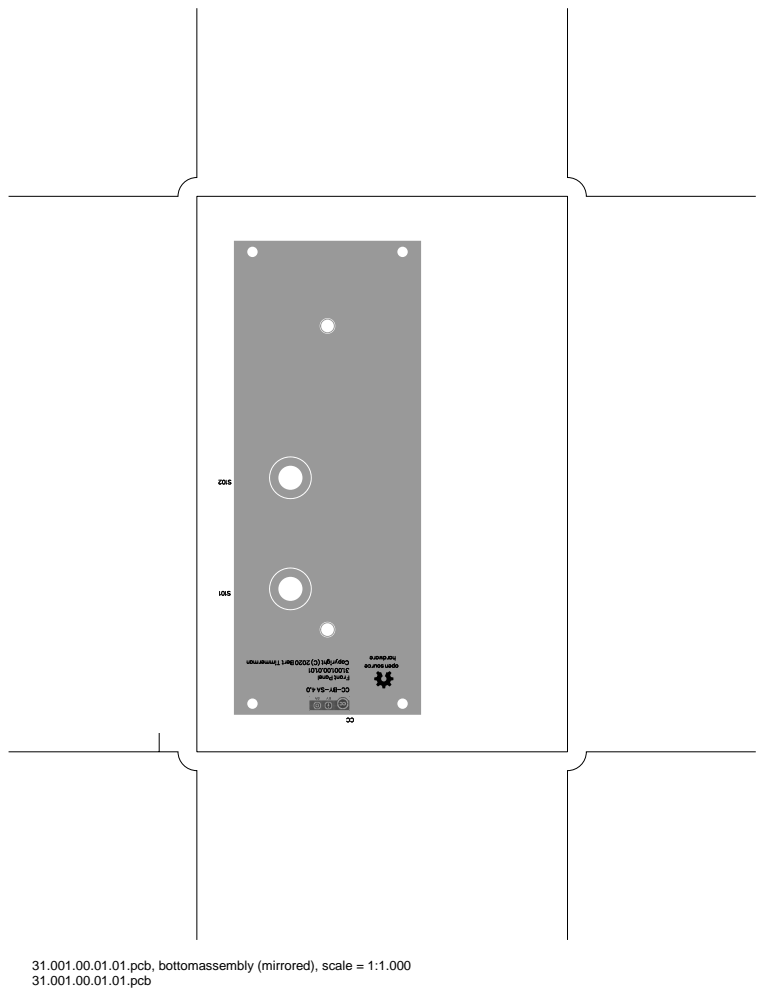
[picture p57: page 13]

31.001.00.01.01.pcb, bottomassembly (mirrored), scale = 1:1.000

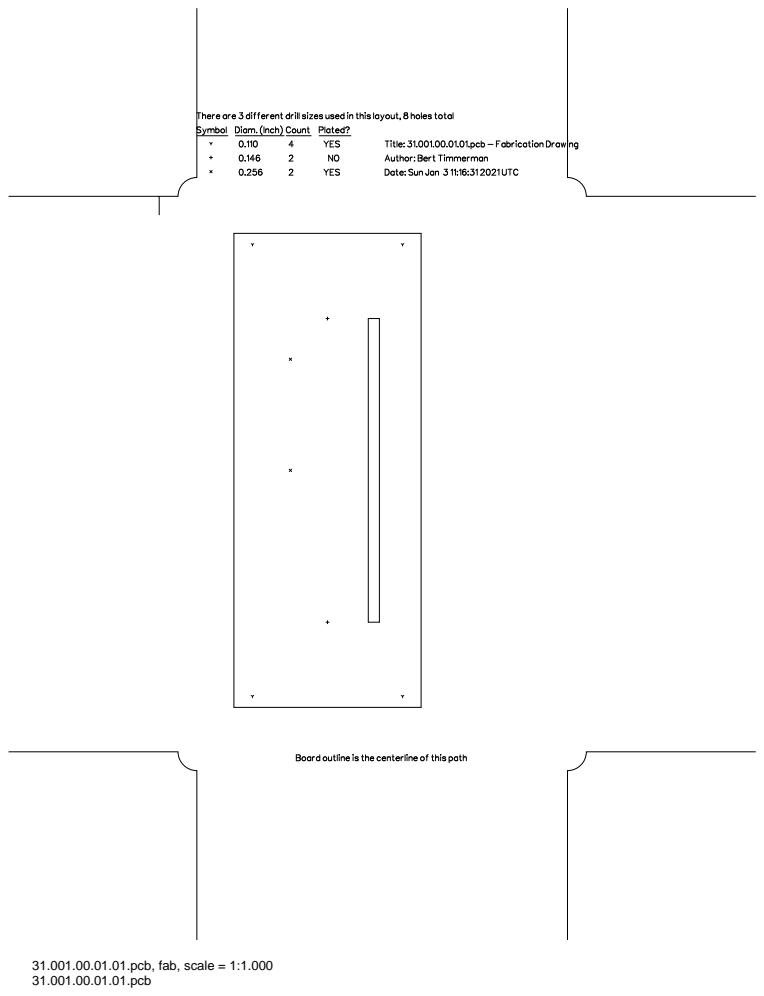
[picture p58: page 14]

31.001.00.01.01.pcb, fab, scale = 1:1.000
