lambert/31/ecad/pcb/plotfiles/31.002.00.01.01.pcb.pdf

## 31.002.00.01.01.pcb

## 1. Table of Contents (This Page) Created on Sun Jan 3 12:16:31 2021 2. component 3. solder 4. outline 5. plated-drill 6. unplated-drill 7. componentmask 8. soldermask 9. topsilk 10. bottomsilk 11. topassembly 12. bottomassembly 13. fab

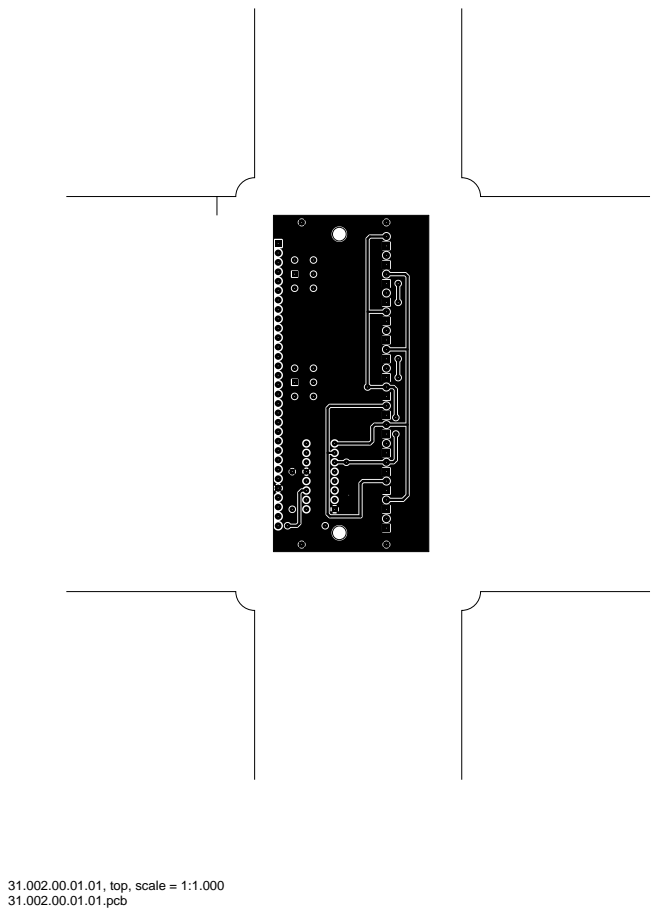
[picture p59: page 2]
31.002.00.01.01, top, scale = 1:1.000

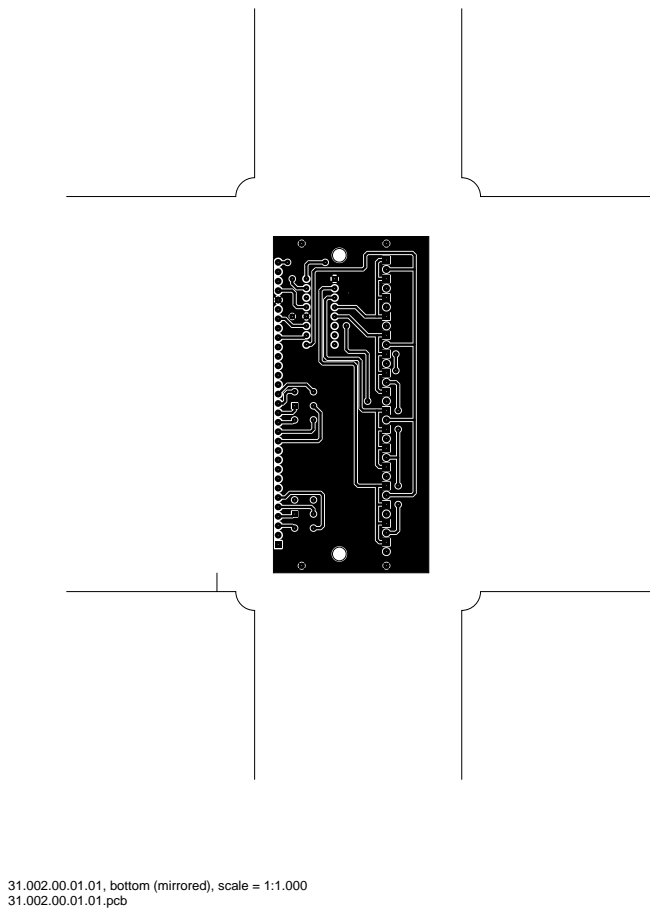
[picture p60: page 3]

31.002.00.01.01, bottom (mirrored), scale = 1:1.000

31.002.00.01.01, outline, scale = 1:1.000

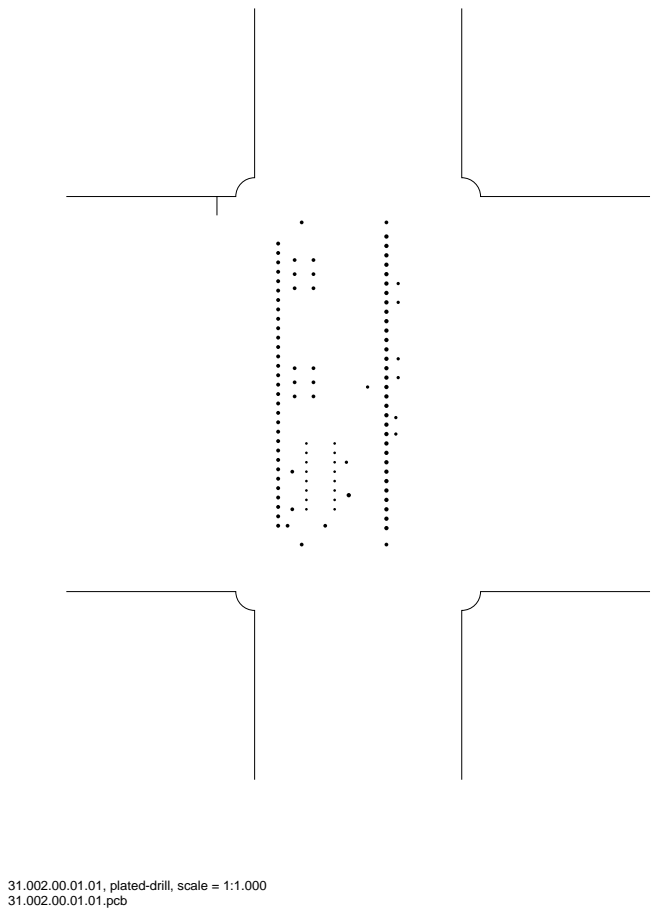
[picture p61: page 5]

31.002.00.01.01, plated-drill, scale = 1:1.000

31.002.00.01.01, unplated-drill, scale = 1:1.000

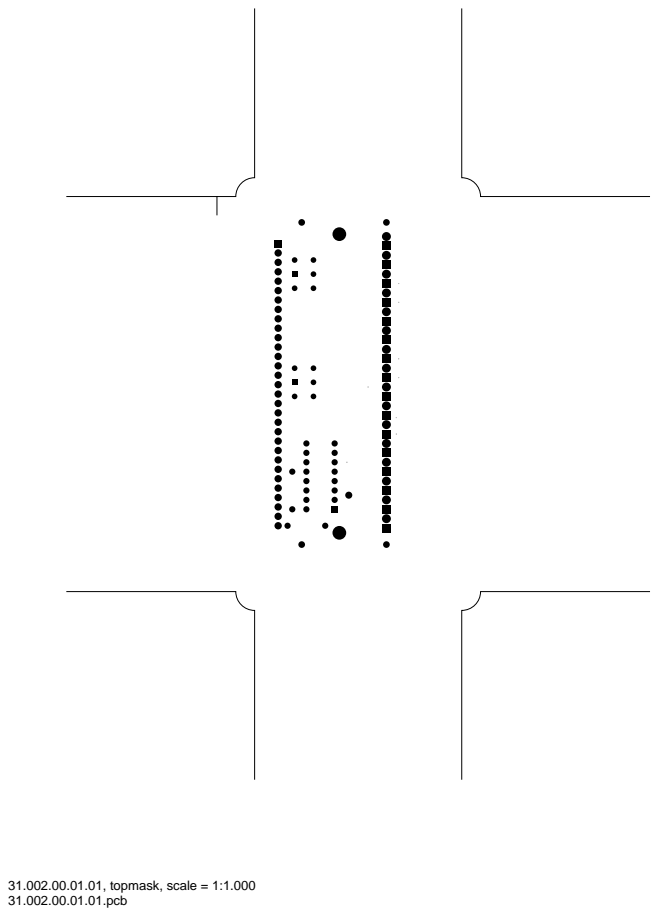
[picture p62: page 7]
31.002.00.01.01, topmask, scale = 1:1.000

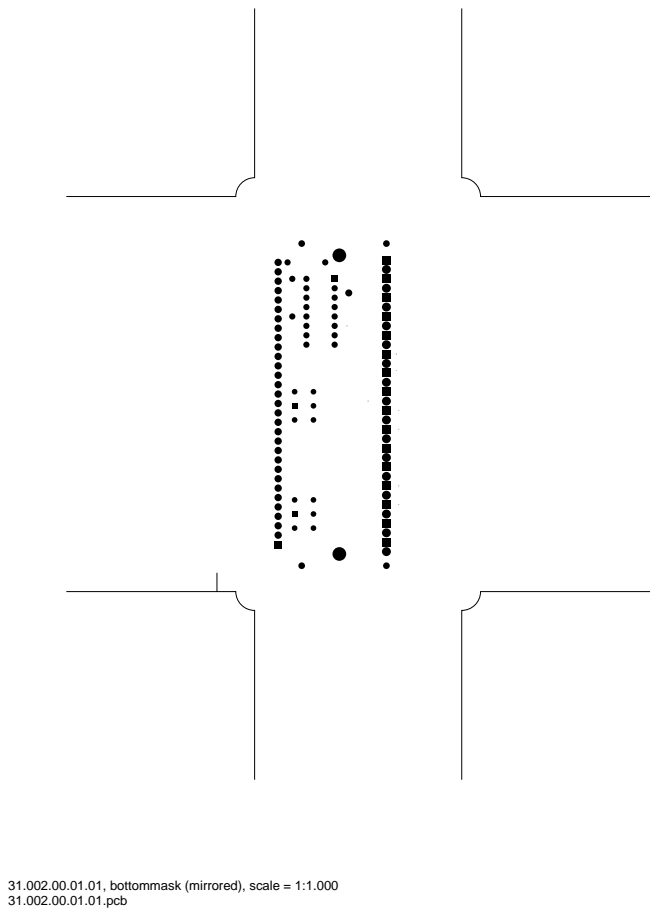
[picture p63: page 8]

31.002.00.01.01, bottommask (mirrored), scale = 1:1.000

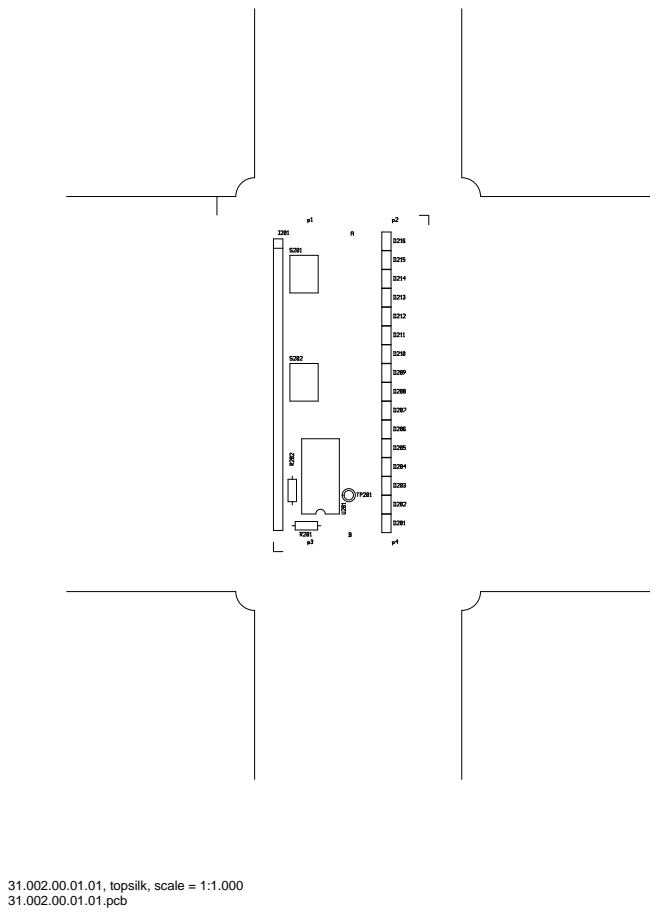
[picture p64: page 9]
31.002.00.01.01, topsilk, scale = 1:1.000

31.002.00.01.01, bottomsilk (mirrored), scale = 1:1.000

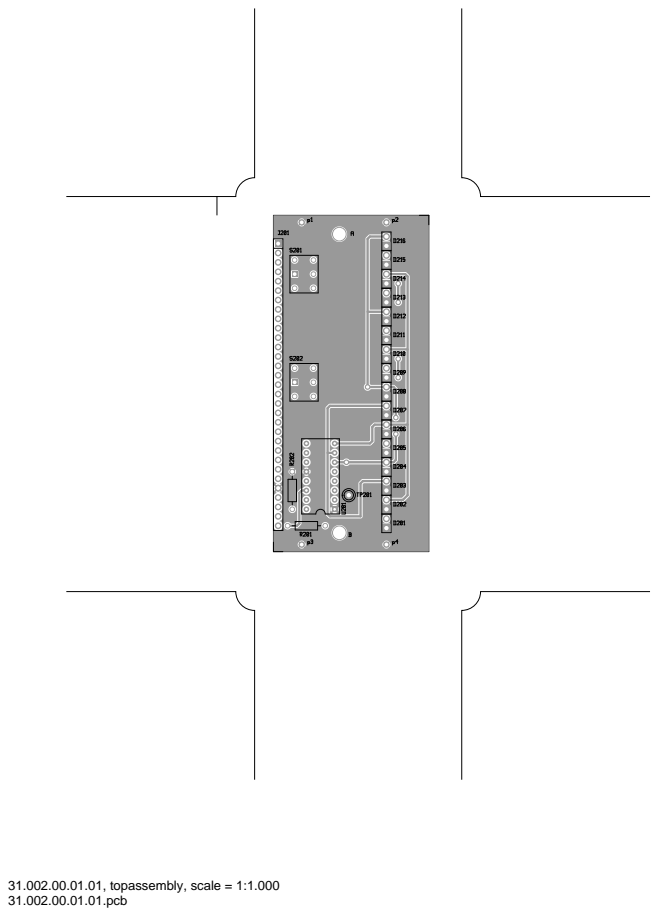
[picture p65: page 11]
31.002.00.01.01, topassembly, scale = 1:1.000

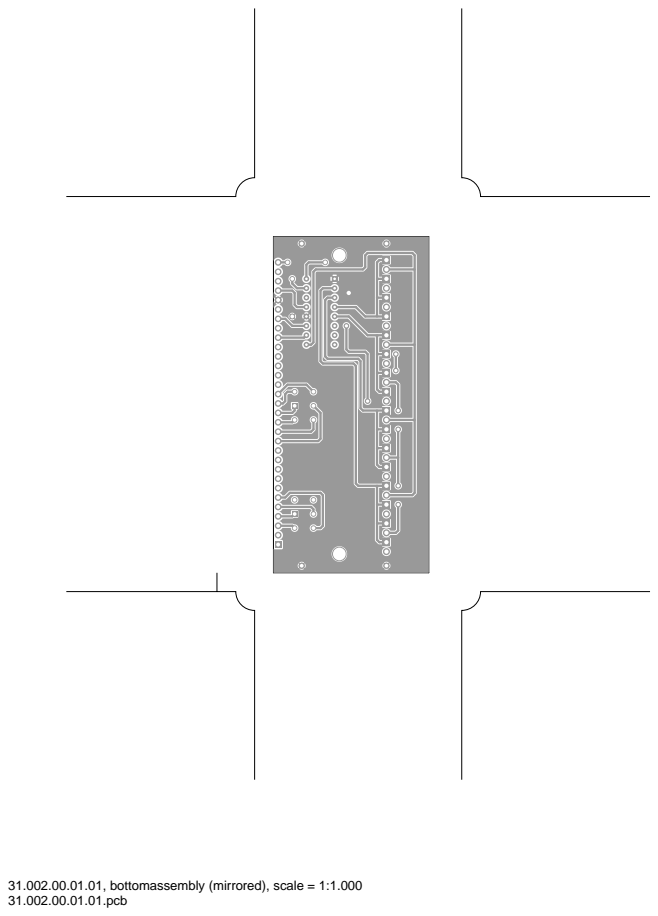
[picture p66: page 12]

31.002.00.01.01, bottomassembly (mirrored), scale = 1:1.000

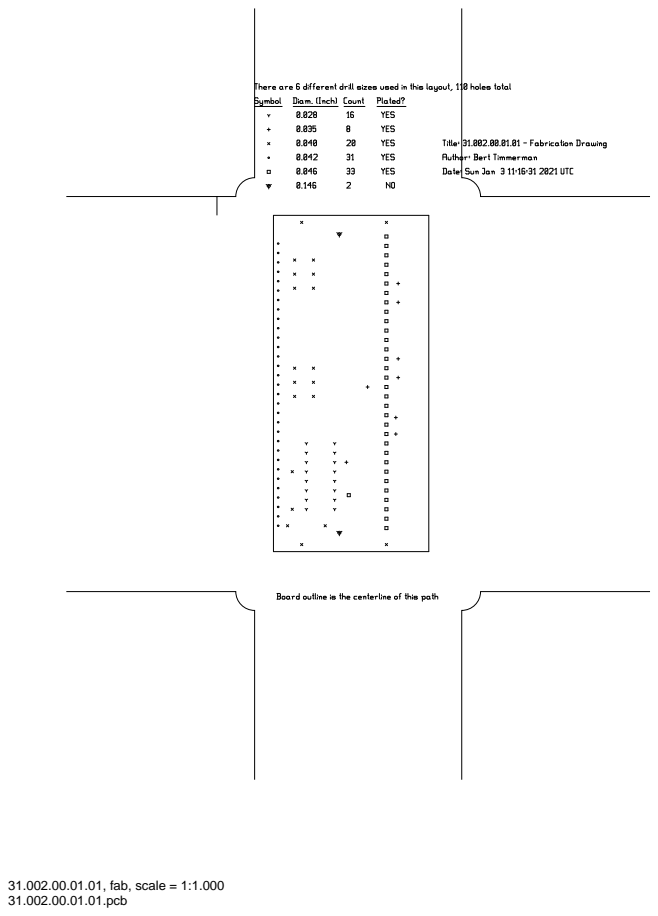
[picture p67: page 13]
31.002.00.01.01, fab, scale = 1:1.000
