lambert/31/ecad/pcb/plotfiles/31.003.00.01.01.pcb.pdf

## 31.003.00.01.01.pcb

## 1. Table of Contents (This Page) Created on Sun Jan 3 12:16:31 2021 2. component 3. solder 4. outline 5. plated-drill 6. unplated-drill 7. componentmask 8. soldermask 9. topsilk 10. bottomsilk 11. topassembly 12. bottomassembly 13. fab

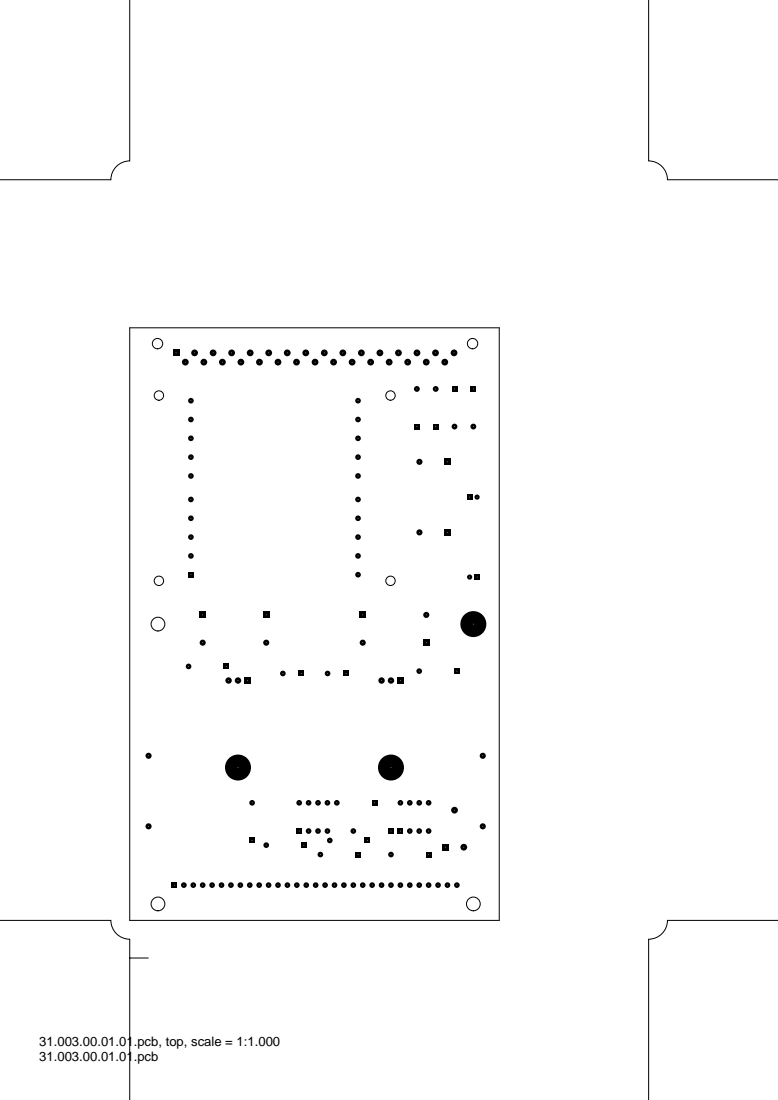
[picture p68: page 2]

31.003.00.01.01.pcb, top, scale = 1:1.000

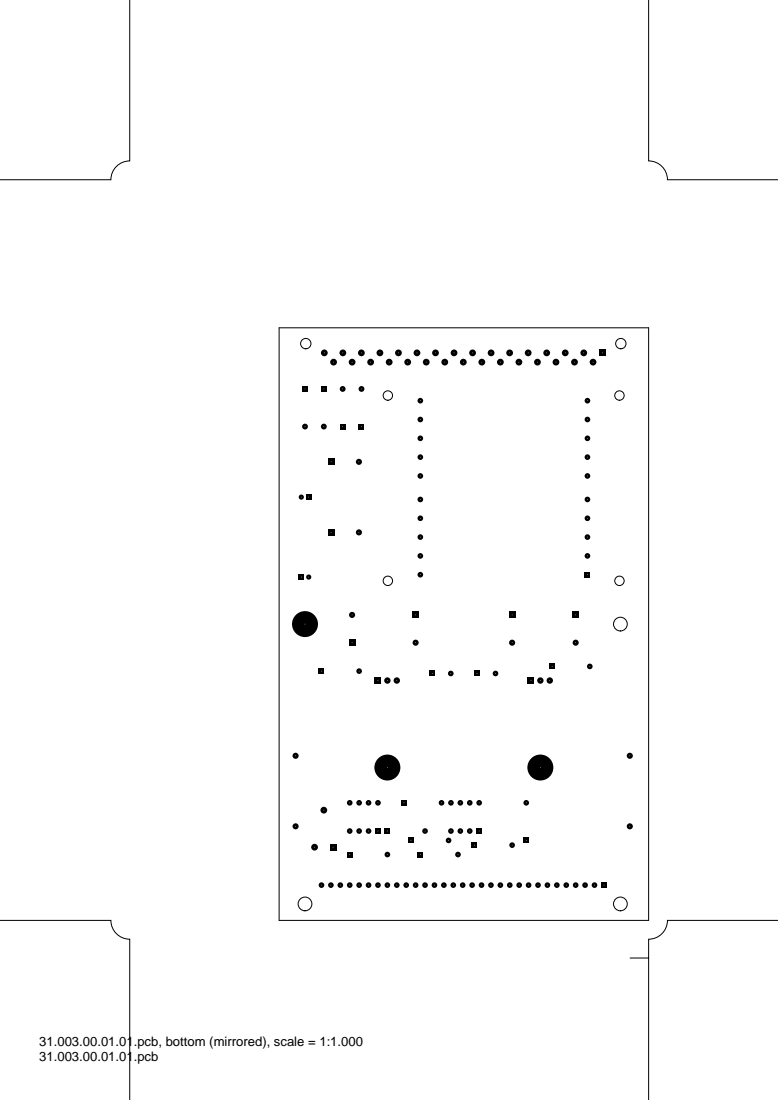
[picture p69: page 3]

31.003.00.01.01.pcb, bottom (mirrored), scale = 1:1.000

31.003.00.01.01.pcb, outline, scale = 1:1.000

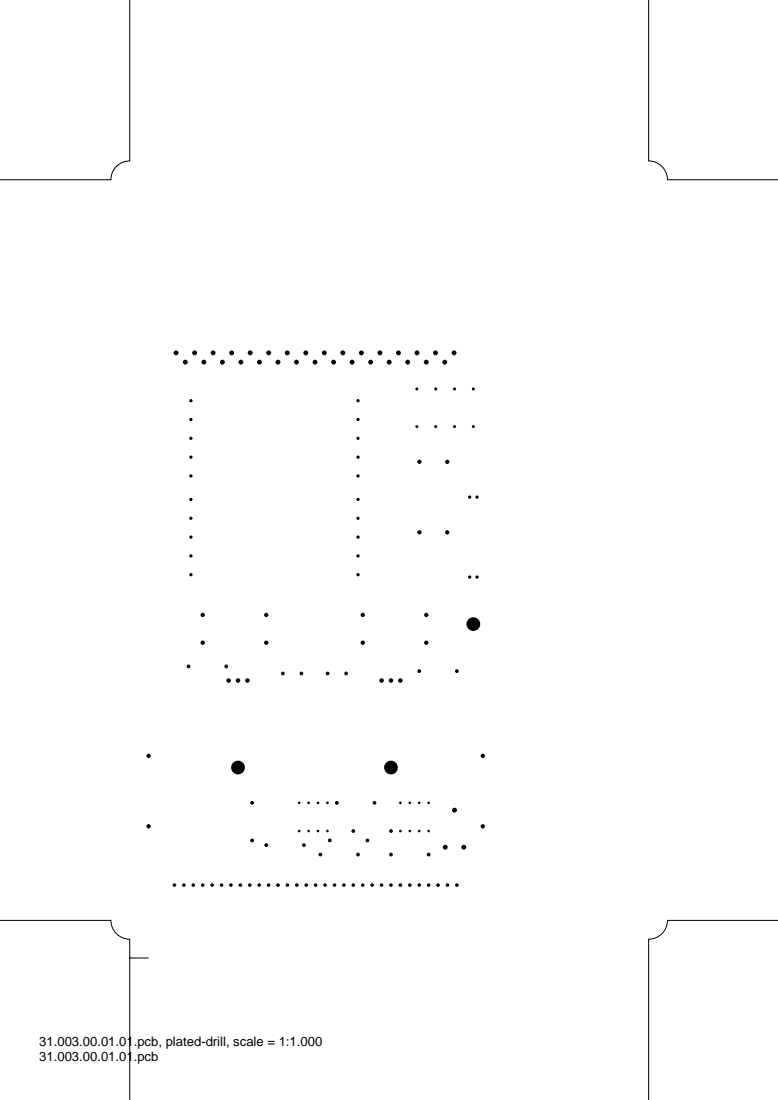
[picture p70: page 5]

31.003.00.01.01.pcb, plated-drill, scale = 1:1.000

31.003.00.01.01.pcb, unplated-drill, scale = 1:1.000

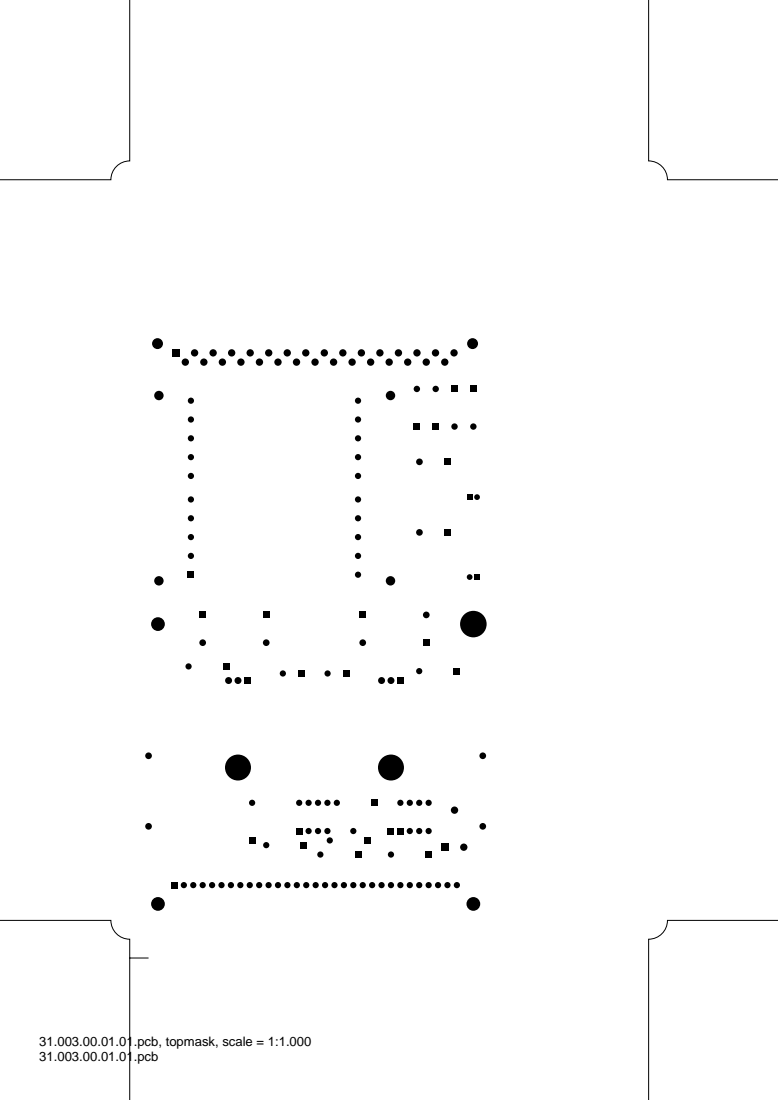
[picture p71: page 7]

31.003.00.01.01.pcb, topmask, scale = 1:1.000

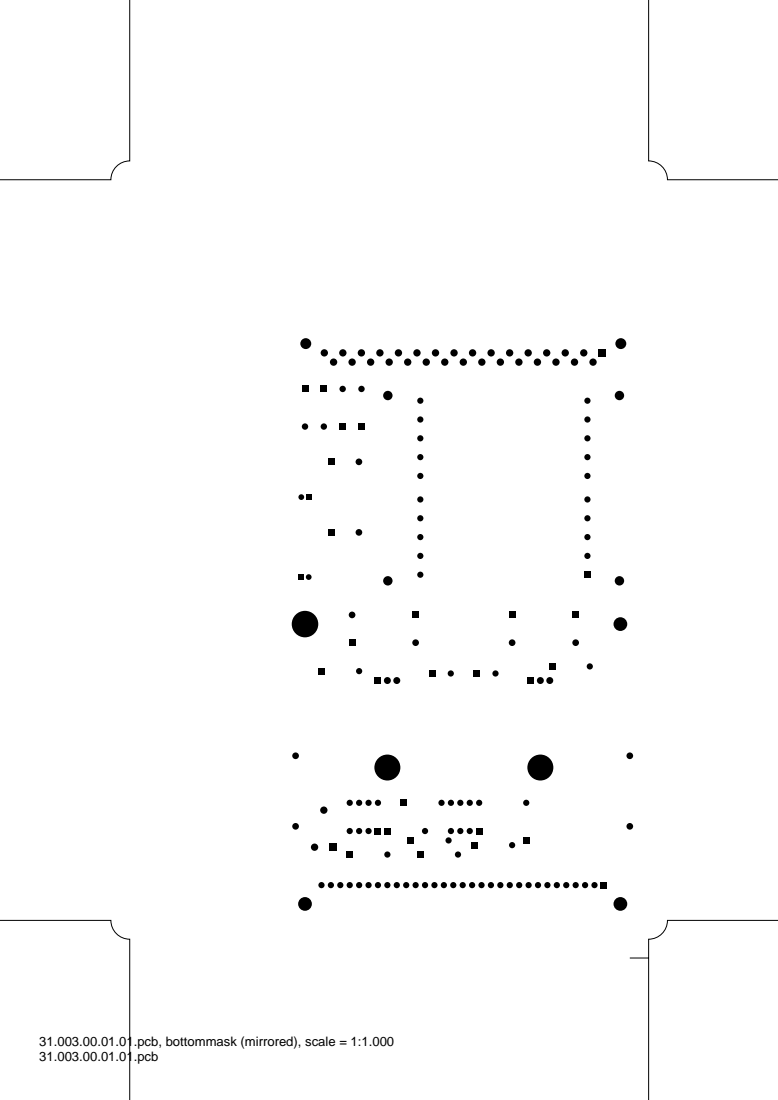
[picture p72: page 8]

31.003.00.01.01.pcb, bottommask (mirrored), scale = 1:1.000

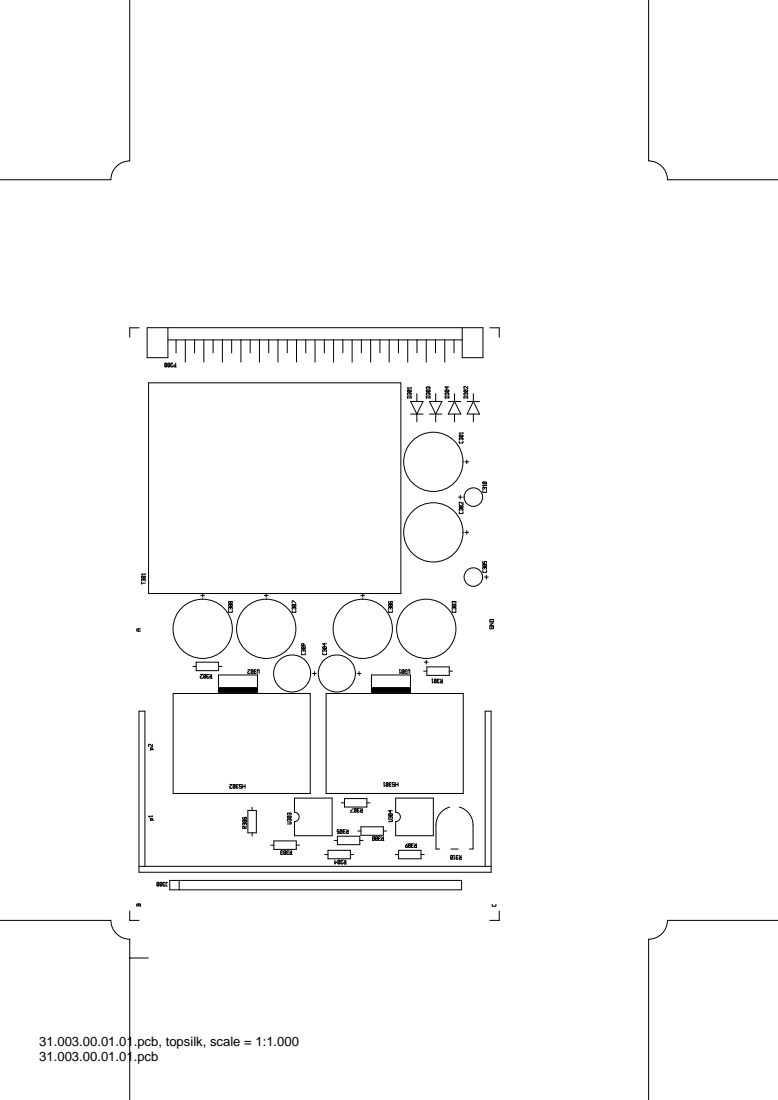
[picture p73: page 9]

31.003.00.01.01.pcb, topsilk, scale = 1:1.000

31.003.00.01.01.pcb, bottomsilk (mirrored), scale = 1:1.000

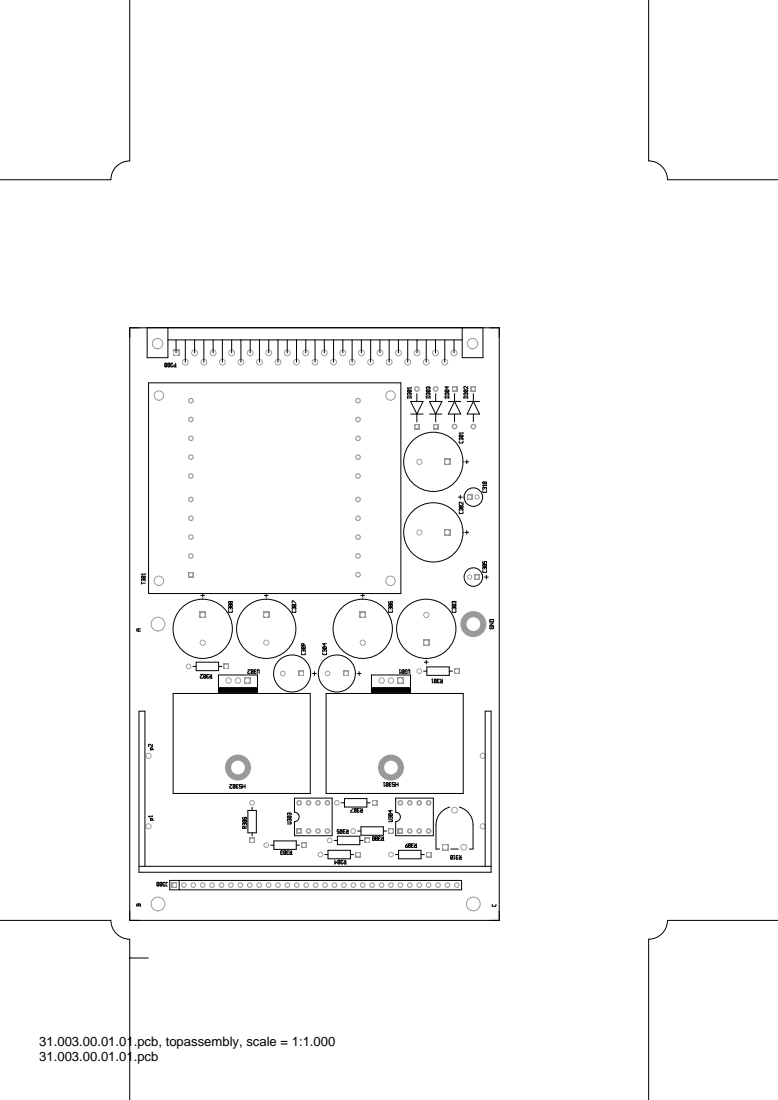
[picture p74: page 11]

31.003.00.01.01.pcb, topassembly, scale = 1:1.000

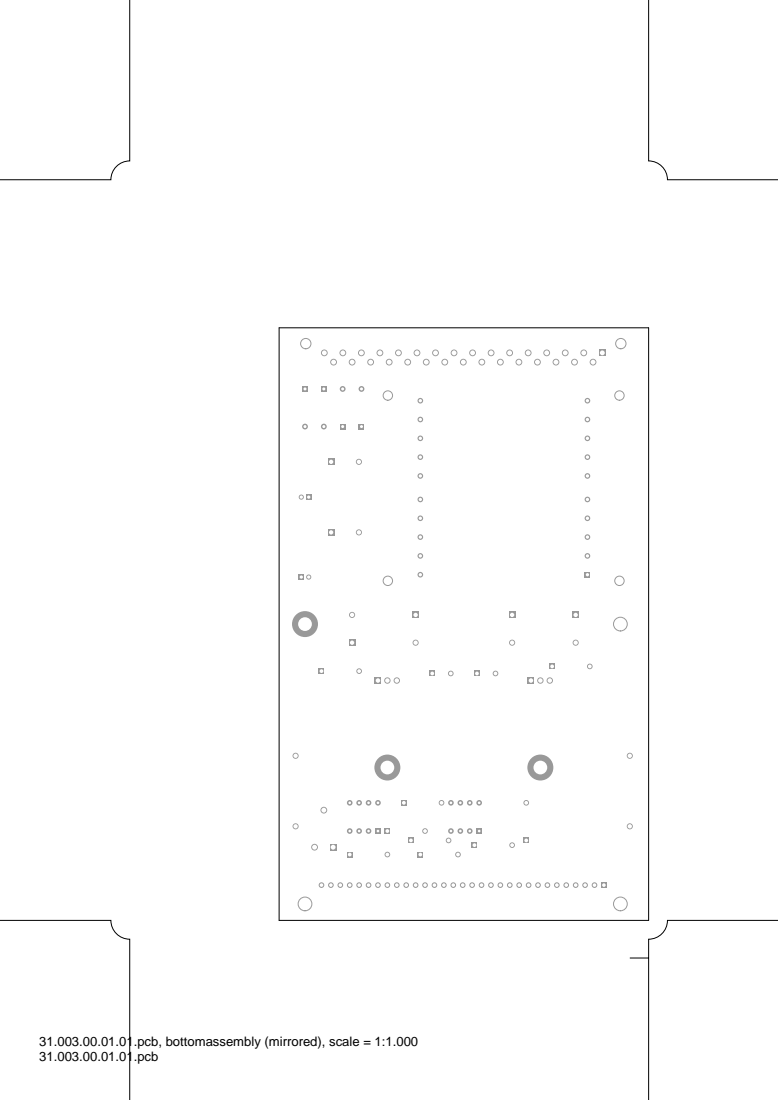
[picture p75: page 12]

31.003.00.01.01.pcb, bottomassembly (mirrored), scale = 1:1.000

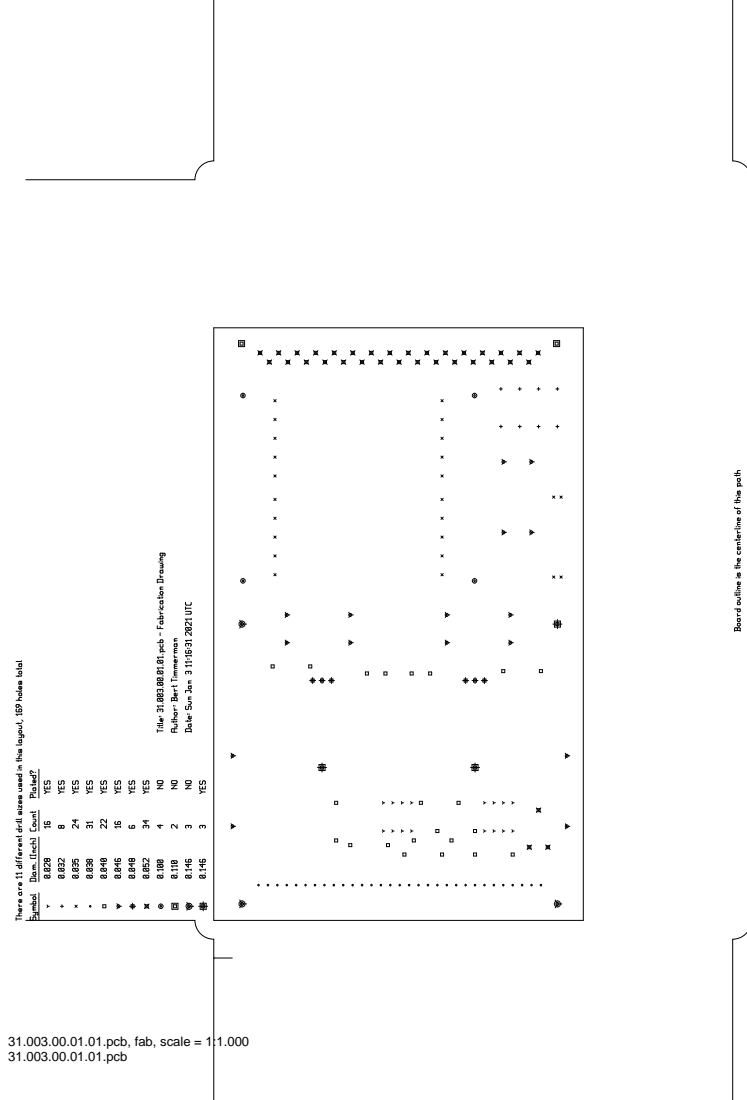
[picture p76: page 13]

31.003.00.01.01.pcb, fab, scale = 1:1.000
