lambert/31/ecad/pcb/plotfiles/31.005.00.01.01.pcb.pdf

## 31.005.00.01.01.pcb

## 1. Table of Contents (This Page) Created on Sun Jan 3 12:16:32 2021 2. top 3. bottom 4. outline 5. plated-drill 6. componentmask 7. soldermask 8. topsilk 9. bottomsilk 10. topassembly 11. bottomassembly 12. fab

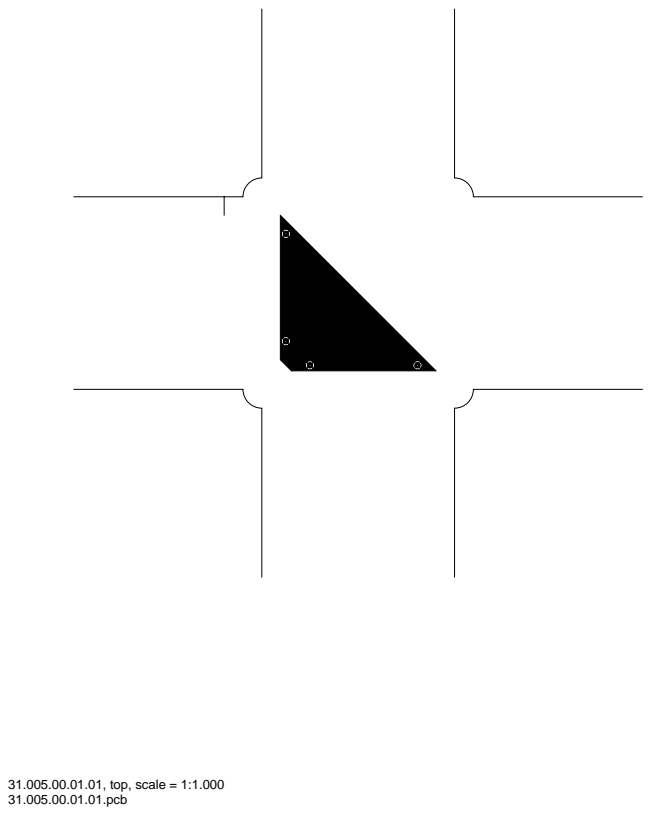
[picture p77: page 2]
31.005.00.01.01, top, scale = 1:1.000

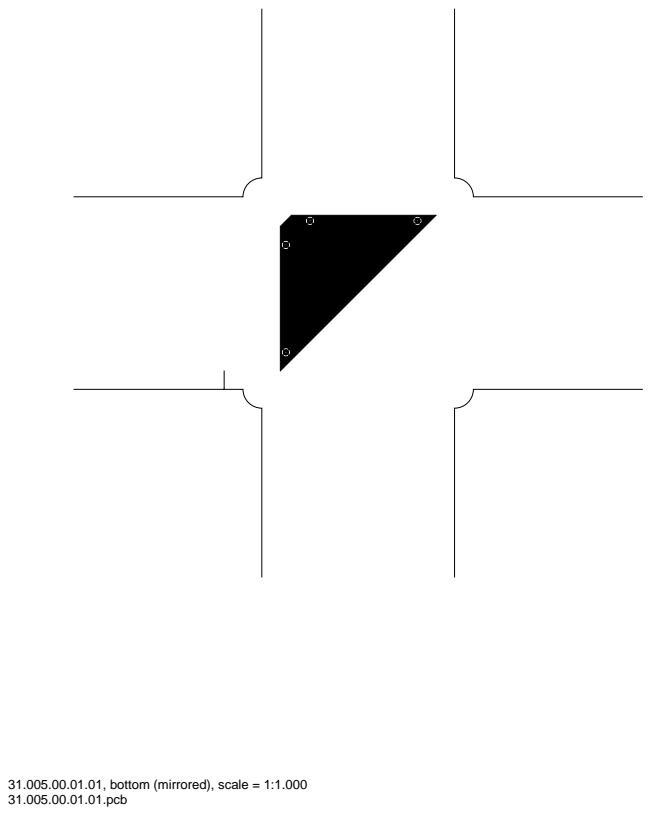
[picture p78: page 3]

31.005.00.01.01, bottom (mirrored), scale = 1:1.000

31.005.00.01.01, outline, scale = 1:1.000

31.005.00.01.01, plated-drill, scale = 1:1.000

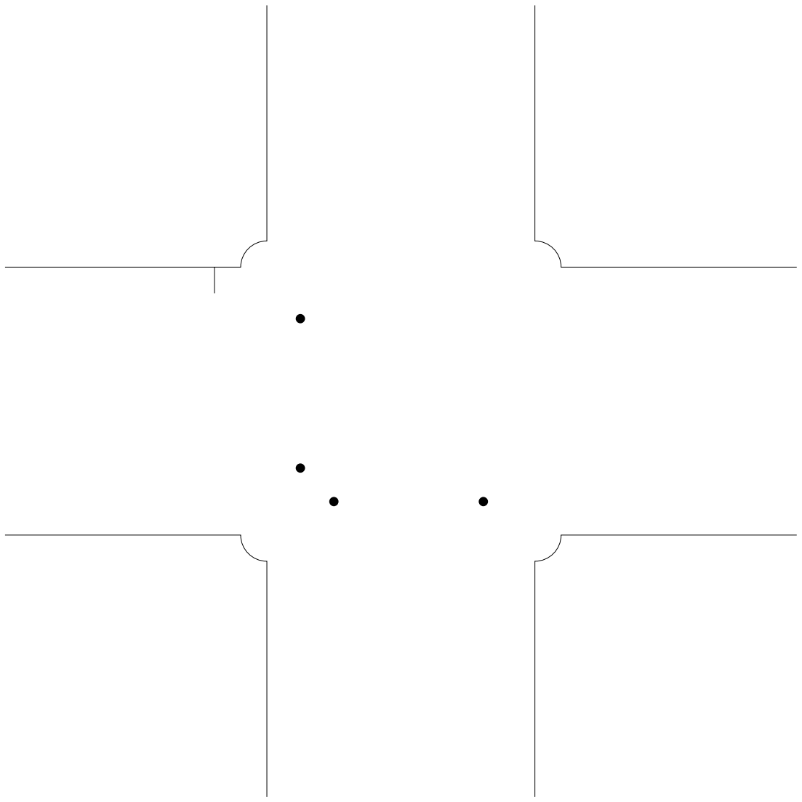
[picture p79: figure]

31.005.00.01.01, topmask, scale = 1:1.000

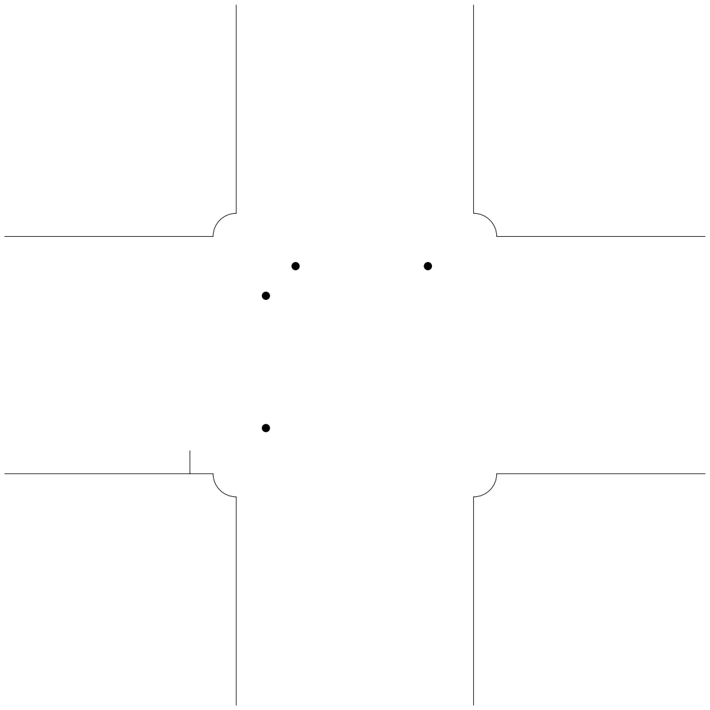
[picture p80: figure]

31.005.00.01.01, bottommask (mirrored), scale = 1:1.000

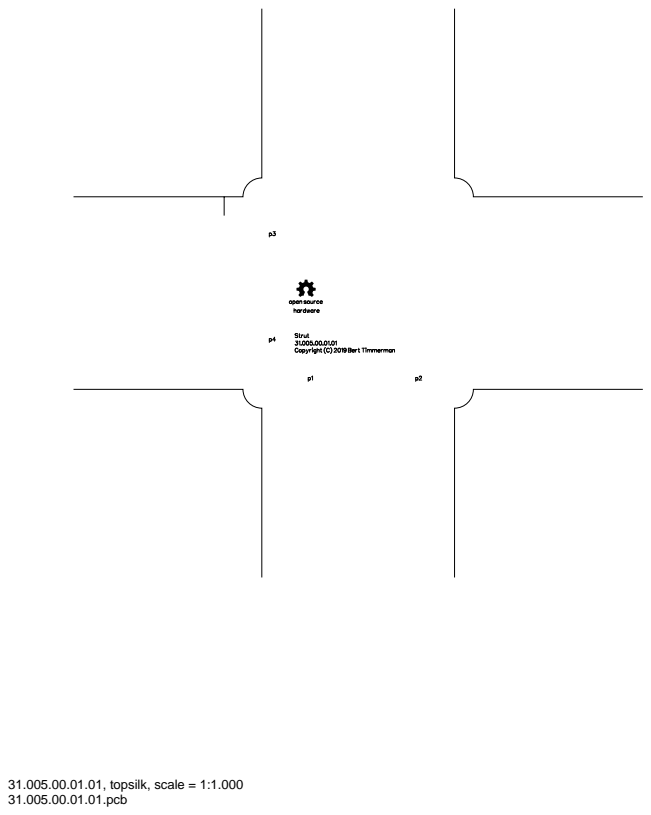
[picture p81: page 8]
31.005.00.01.01, topsilk, scale = 1:1.000

31.005.00.01.01, bottomsilk (mirrored), scale = 1:1.000

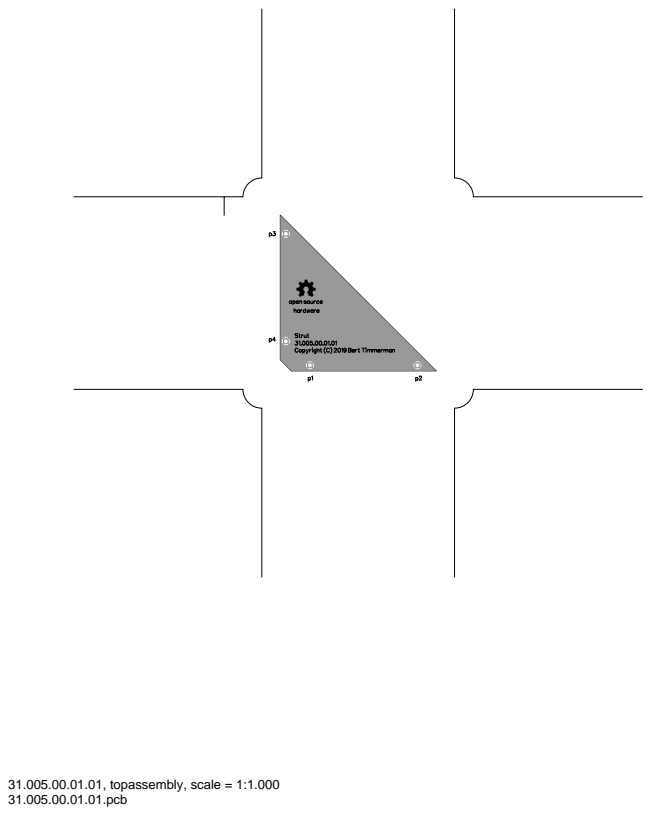
[picture p82: page 10]
31.005.00.01.01, topassembly, scale = 1:1.000

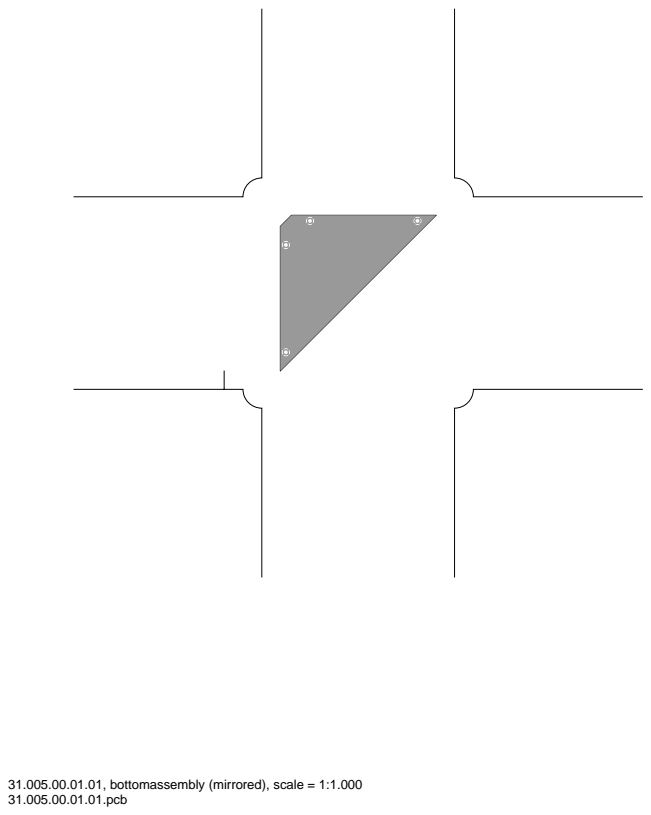
[picture p83: page 11]

31.005.00.01.01, bottomassembly (mirrored), scale = 1:1.000

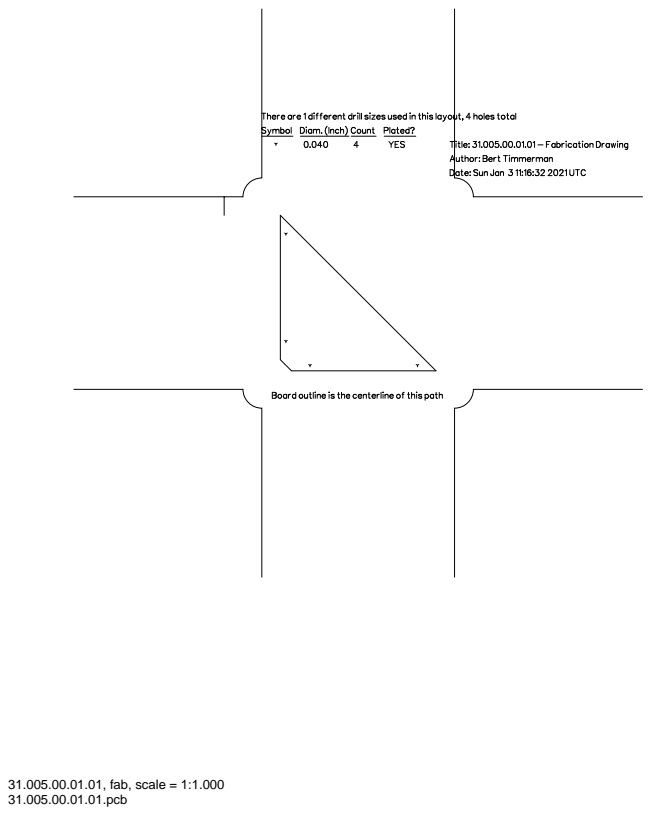
[picture p84: page 12]
31.005.00.01.01, fab, scale = 1:1.000
