lambert/31/mcad/plotfiles/31.001.00.01.01_front_panel_assembly.pdf

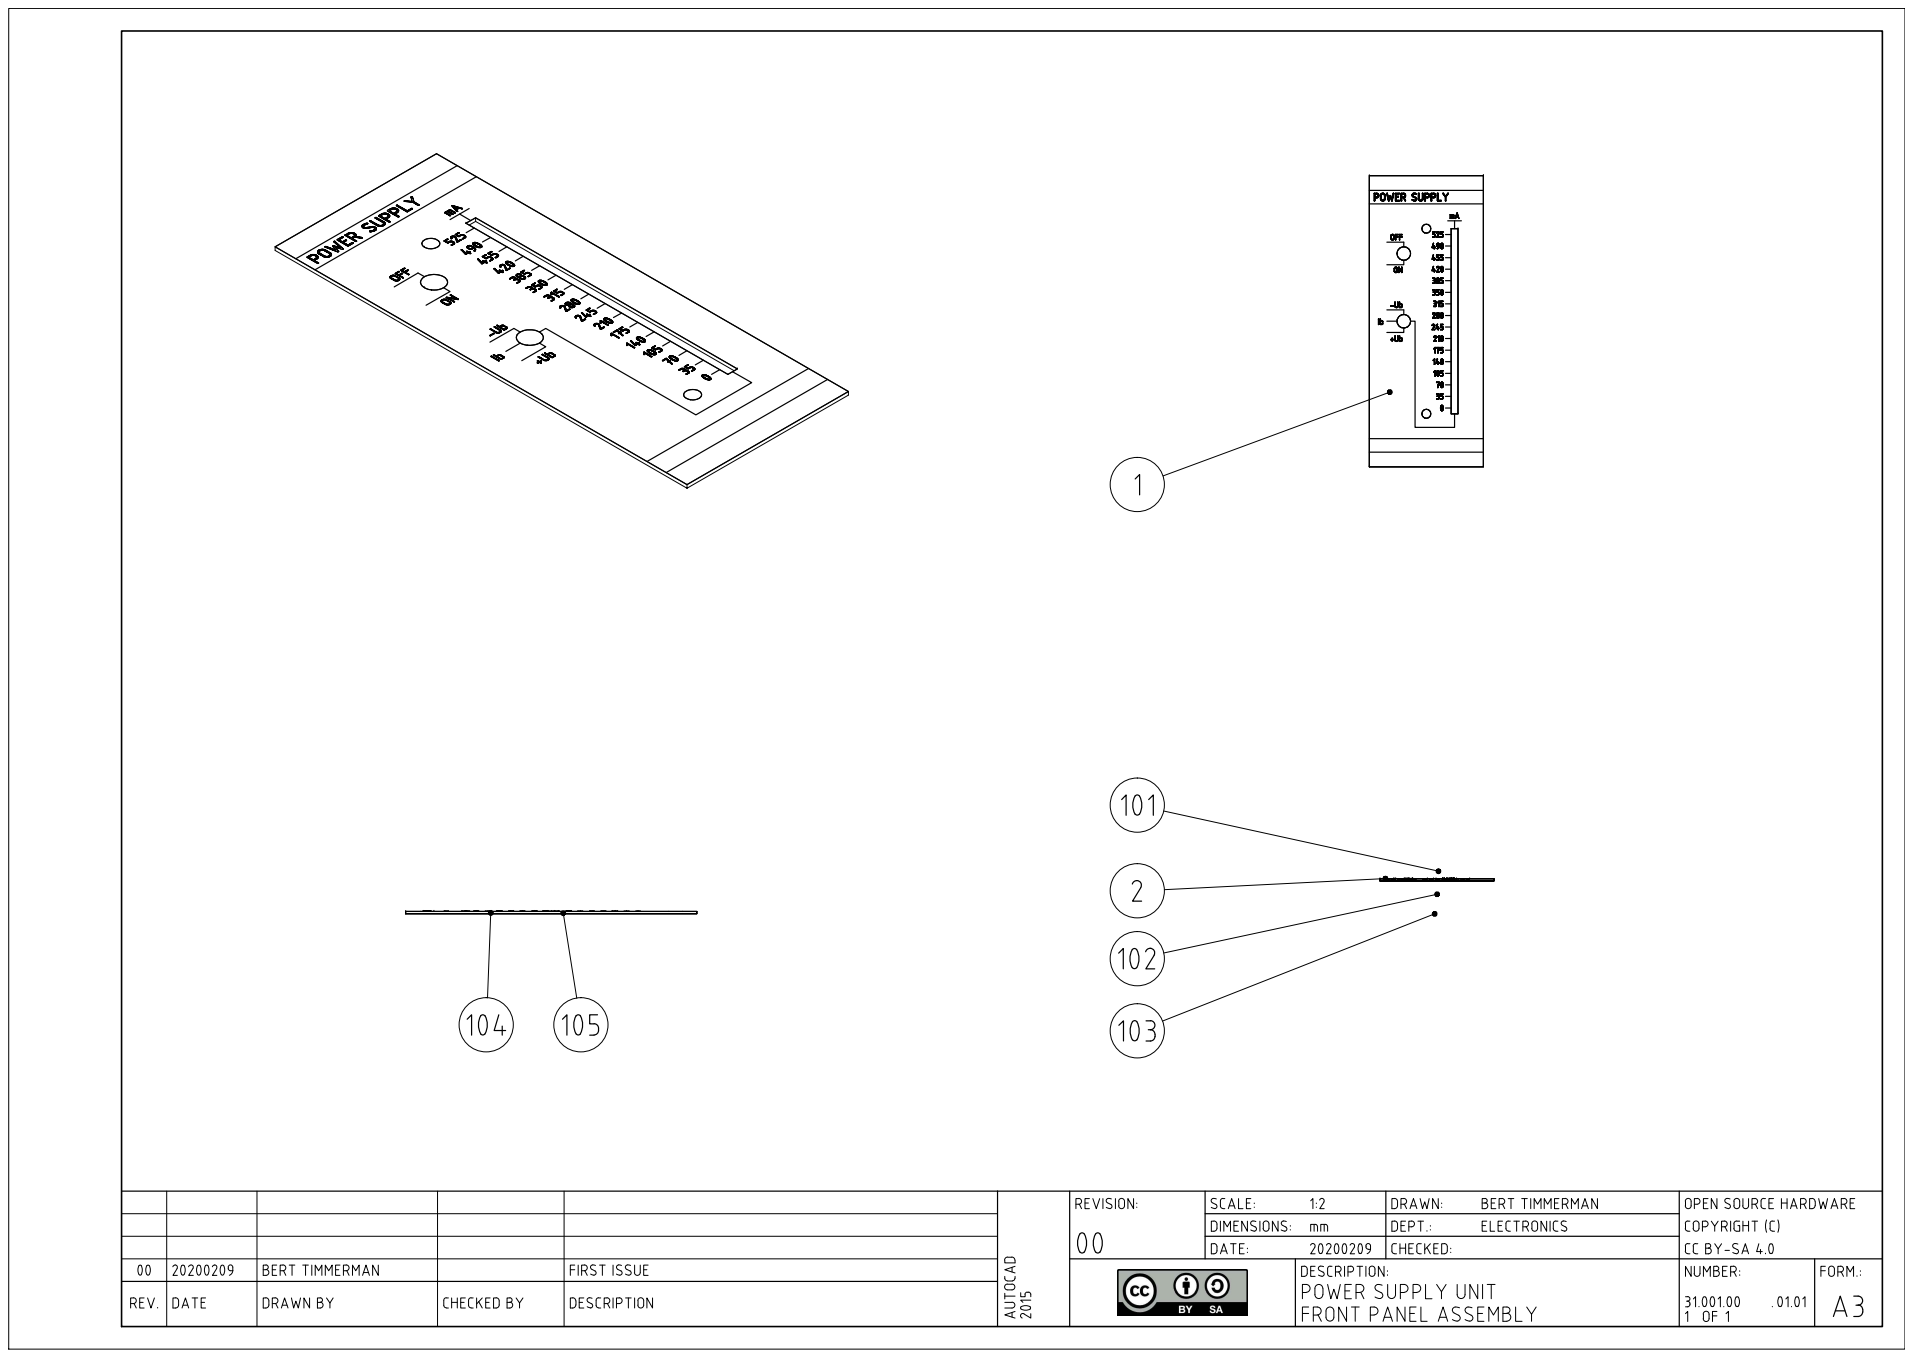
[picture p85: page 1]
