lambert/31/mcad/plotfiles/31.000.00.01.00_assembly_SW_ISO_view.pdf

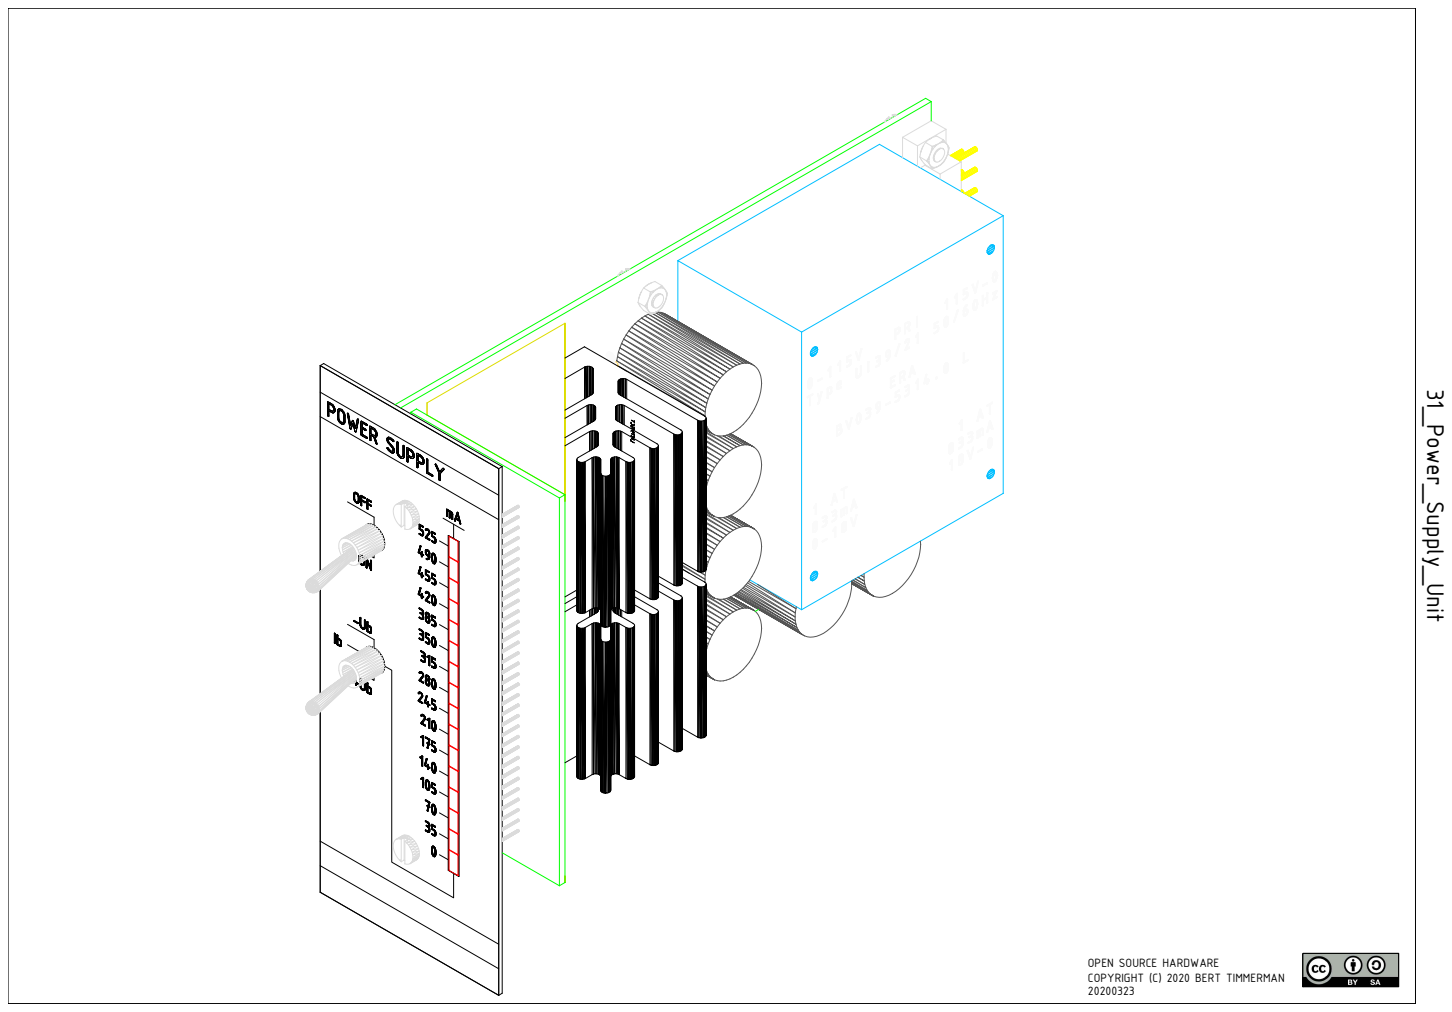
[picture p86: page 1]

OPEN SOURCE HARDWARE
COPYRIGHT (C) 2020 BERT TIMMERMAN
