lambert/31/(list of files, drawings)

Other design files:
ecad/pcb/31.001.00.01.01.pcb
ecad/pcb/31.002.00.01.01.pcb
ecad/pcb/31.003.00.01.01.pcb
ecad/pcb/31.004.00.01.01.pcb
ecad/pcb/31.005.00.01.01.pcb
