lambert/31/(commit log)

2020-12-17 Added gschem ecad files.
    [31.000.00.00.01.sch, 31.000.00.01.01.sch, 31.000.00.01.02.sch, 31.001.00.01.01.sch, 31.002.00.01.01.sch, 31.003.00.01.01.sch, 31.004.00.01.01.sch, 31.005.00.01.01.sch]
2020-12-17 Added a README for pcb.
2020-12-20 Updated schematic.
    [31.002.00.01.01.sch]
2020-12-23 Updated the schematics.
    [31.000.00.01.02.sch, 31.002.00.01.01.sch, 31.003.00.01.01.sch]
2020-12-23 Added pdf of schematics.
2020-12-23 Added pcb eyecandy.
2020-12-23 Updated the pcb Makefile.
2020-12-23 Added pcb fab files.
    [31.001.00.01.01.GBL, 31.001.00.01.01.GBO, 31.001.00.01.01.GBS, 31.001.00.01.01.GKO, 31.001.00.01.01.GTL, 31.001.00.01.01.GTO, 31.001.00.01.01.GTS, 31.001.00.01.01.XLN]
2020-12-23 Updated schematics.
    [31.001.00.01.01.sch, 31.002.00.01.01.sch, 31.005.00.01.01.sch]
2020-12-23 Updated pcb eyecandy.
2020-12-23 Added pcb files.
    [31.001.00.01.01.pcb, 31.002.00.01.01.pcb, 31.004.00.01.01.pcb, 31.005.00.01.01.pcb]
2021-01-03 Updated pcb.
    [31.003.00.01.01.pcb]
2021-01-03 Renumbered a component on pcb 31.003.00.
    [31.003.00.01.01.pcb]
2021-01-03 Correction of name of pcb 31.003.00.
    [31.003.00.01.01.pcb]
2021-01-03 Updated pcb generated files.
    Signed-ff-by: bert <bert.timmerman@xs4all.nl>
    [31.001.00.01.01.GBL, 31.001.00.01.01.GBO, 31.001.00.01.01.GBS, 31.001.00.01.01.GKO, 31.001.00.01.01.GTL, 31.001.00.01.01.GTO, 31.001.00.01.01.GTS, 31.001.00.01.01.gbp]
2023-12-05 Updated pcb 31.003.00.
    [31.003.00.01.01.pcb]
2024-06-22 Updated schematics pdf (WIP).
